I-Grebot/Laser_Beacon_V3.0/README.md

# Laser_Beacon_V3.0
IGrebot's current Beacons system aiming at opponent detection and absolute positioning.

See more on : http://wiki.igrebot.fr/index.php?title=Beacon_V3.0
