I-Grebot/Laser_Beacon_V3.0/Softwares/common/can/doc/igrebot_robot_arch_2013.pdf

Robot Architecture

: sensor
: actuator

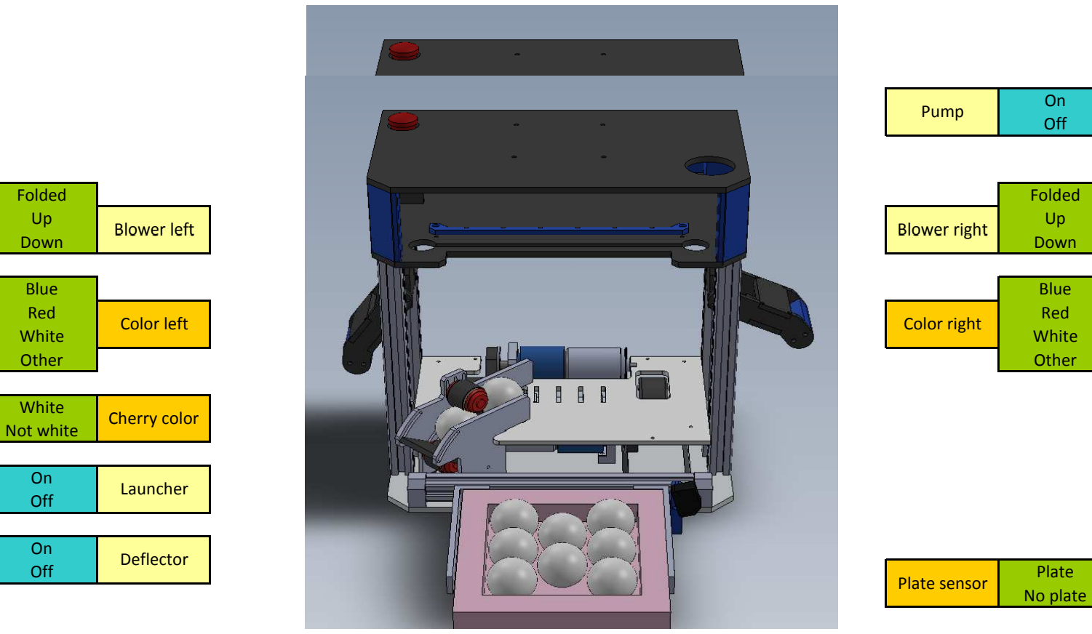
[picture p3: figure]
Folded; Pump; Blower left; Blower right Down; Down; Blue; Red; White; Other; Not white; Off; Plate; No plate; Color right; Deflector; Plate sensor; Cherry color; Launcher; Color left

On | : state
Off | : cmd

## IGrebot 2013

Osiris Back
Right

Osiris Back
Left

Lift
Grab

Osiris Front
Right

Osiris Front
Left Loader
