I-Grebot/Laser_Beacon_V3.0/Electronics/PDD/Releases/PDD_v1.0/PDF/PDD_layout_bcream_neg.pdf

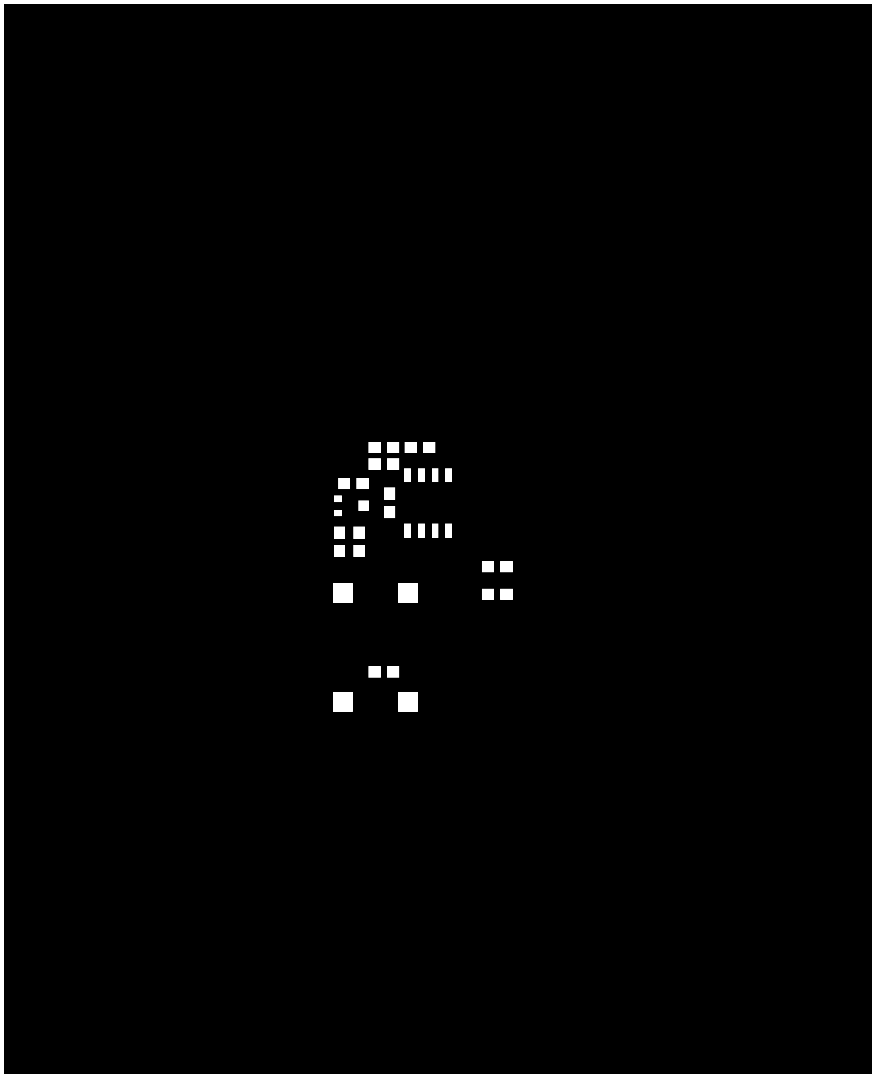
[picture p4: figure]
