I-Grebot/Laser_Beacon_V3.0/Theory/PhotoDetectMain_Algorithm.xlsx

Sheet: Theory
Constants
 |  | 0.003054326191
Laser angle error |  | 0.175 | ° | 0.154
Distance between lasers | dla = | 42 | mm | 38.5 | 60mm @ 3600mm |  | 20
Distance between photodiodes | dph = | 1000 | mm |  |  | 770 | 44.27777778
Turret's angular speed | ftu = | 33 | rps
Measured values
Photodiode A 1st pulse timing | ta1 = | 0 | us
Photodiode A 2nd pulse timing | ta2 = | 722 | us |  | (ta1 < ta2)
Photodiode B 1st pulse timing | tb1 = | 0 | us |  | (ta1 < tb1)
Photodiode B 2nd pulse timing | tb2 = | 0 | us |  | (tb1 < tb2)
Selected orientation quarter offset | qua = | 0 | ° |  | 0° for North, -90° for West, +90° for East, +180° for South
Computed values
Turret's rotation angle between 2 real lasers | Atur = | 8.57736
Turret's rotation angle between 2 perfect // lasers | atu = | 8.40236 | °
Turret's sight distance between 2 photodiodes | dtu = | 0.0 | mm
Final Opponent's values
Distance to opponent | dop = | 287.4275566 | mm
Angle to opponent | aop = | turret's position at (ta2-ta1)/
Opponent's Orientation | oop = | 90.0 | ° |  | relative to aop
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
