I-Grebot/Laser_Beacon_V3.0/Theory/Turret_OpenLoop.xlsx

Sheet: Sheet1
Igrebot 2013
 | Beacon v3.0 - Turret's motor measurements
FCY | 4 | MHz
PWM PERIOD | 512 | cycles at FCY/64
OC2RS | PWM | RPER (ms) | RPS | RPM
0 | 0.00% | 0.00 | 0.00 | 0
32 | 6.25% | 0.00 | 0.00 | 0
64 | 12.50% | 0.00 | 0.00 | 0
96 | 18.75% | 35.00 | 28.57 | 1714.285714
128 | 25.00% | 28.00 | 35.71 | 2142.857143
160 | 31.25% | 25.00 | 40.00 | 2400
192 | 37.50% | 23.00 | 43.48 | 2608.695652
224 | 43.75% | 22.00 | 45.45 | 2727.272727
256 | 50.00% | 21.00 | 47.62 | 2857.142857
288 | 56.25% | 20.50 | 48.78 | 2926.829268
320 | 62.50% | 20.00 | 50.00 | 3000
352 | 68.75% | 19.50 | 51.28 | 3076.923077
384 | 75.00% | 19.00 | 52.63 | 3157.894737
416 | 81.25% | 18.50 | 54.05 | 3243.243243
448 | 87.50% | 18.00 | 55.56 | 3333.333333
480 | 93.75% | 17.75 | 56.34 | 3380.28169
512 | 100.00% | 17.50 | 57.14 | 3428.571429
 | to be avoid (motor doesn't start)
Paul M.
2012-10-19
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
