I-Grebot/Laser_Beacon_V3.0/Electronics/BRX/BRX_v1.0/Images/BRX_schematic.png

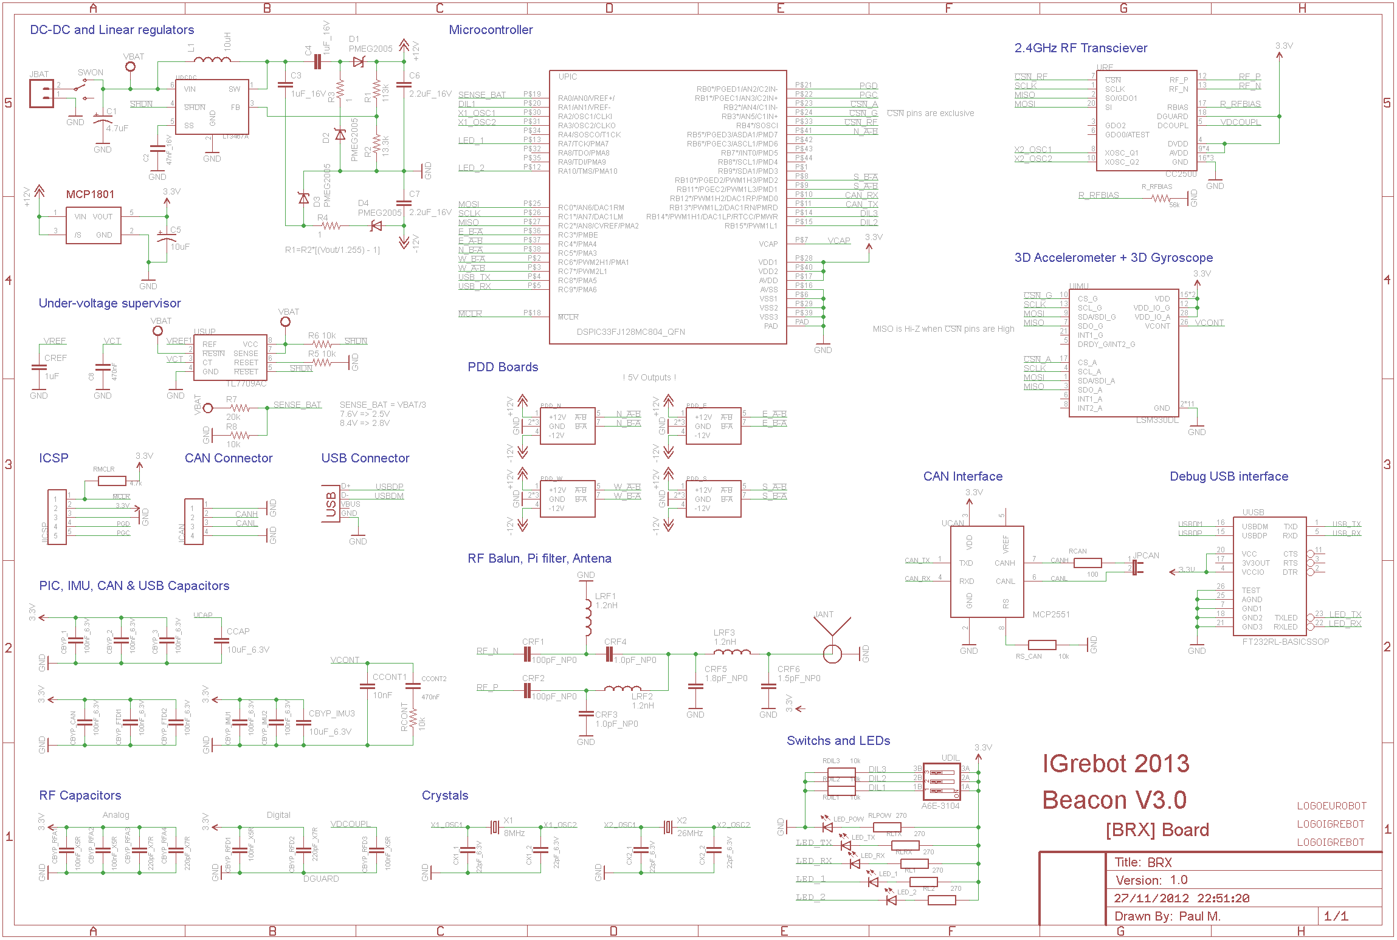
Electronics/BRX/BRX_v1.0/Images/BRX_schematic.png
