I-Grebot/Laser_Beacon_V3.0/Electronics/BTX/BTX_v1.0/Images/BTX_schematic.png

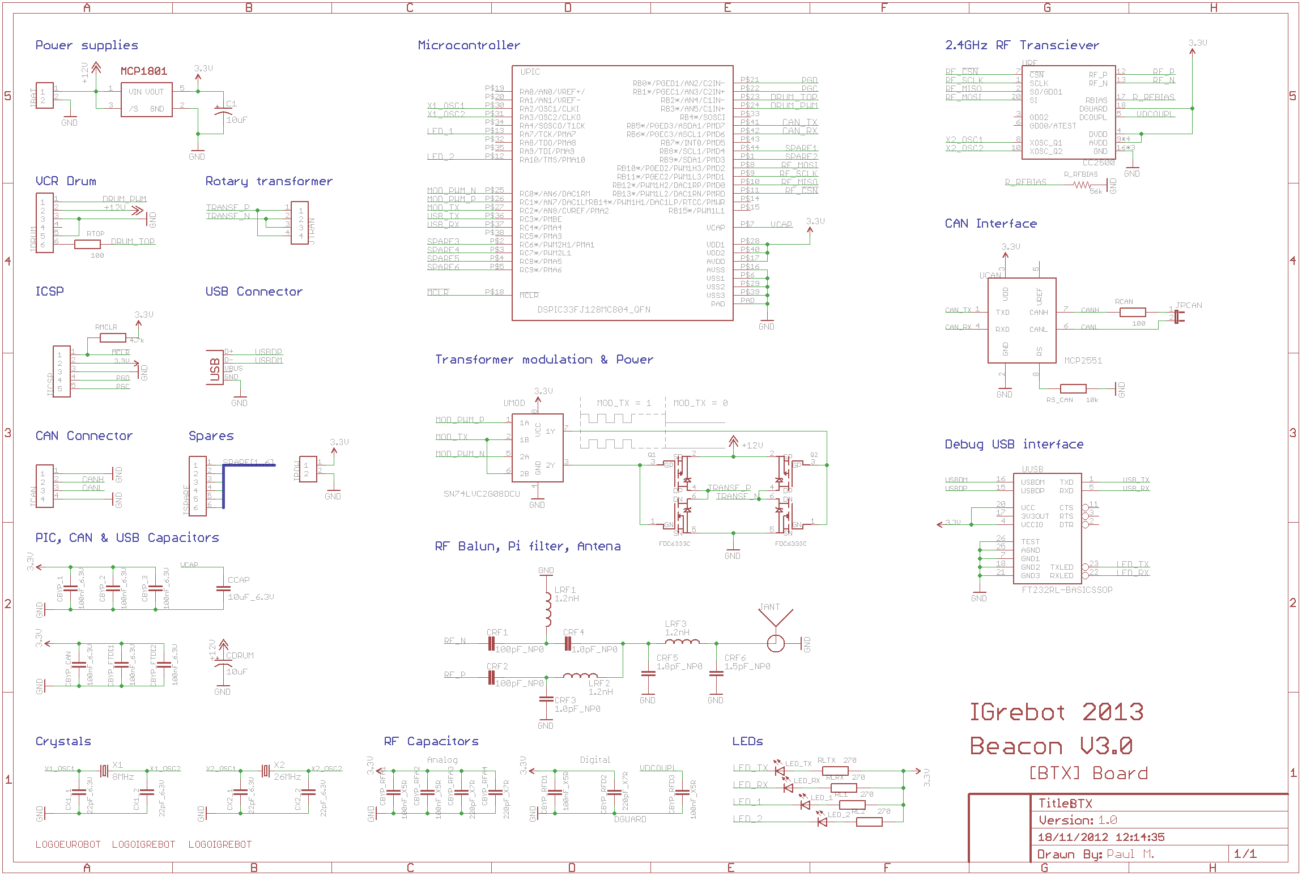
Electronics/BTX/BTX_v1.0/Images/BTX_schematic.png
