I-Grebot/Laser_Beacon_V3.0/Electronics/PDD/Prototype/Images/Rolab_RDD_prot_v1.0_back.png

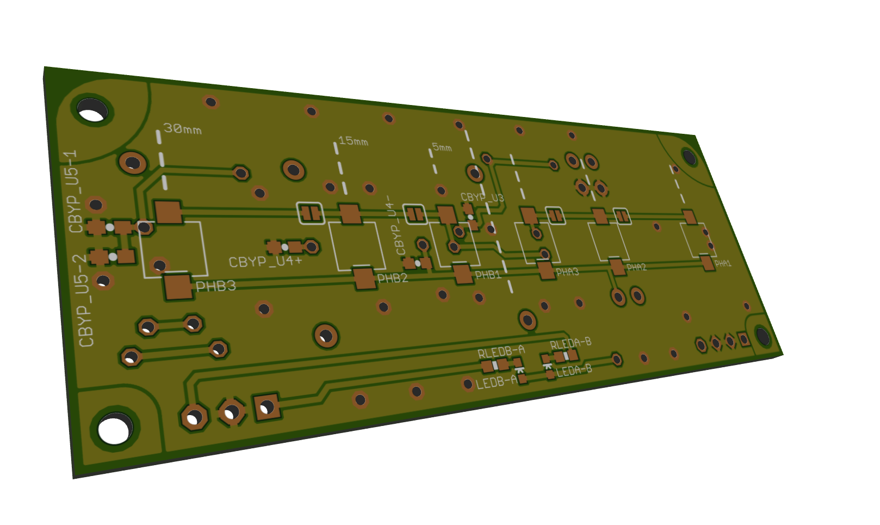
Electronics/PDD/Prototype/Images/Rolab_RDD_prot_v1.0_back.png
