I-Grebot/Laser_Beacon_V3.0/Electronics/PDD/Releases/PDD_v1.0/Images/PDD_schematic.png

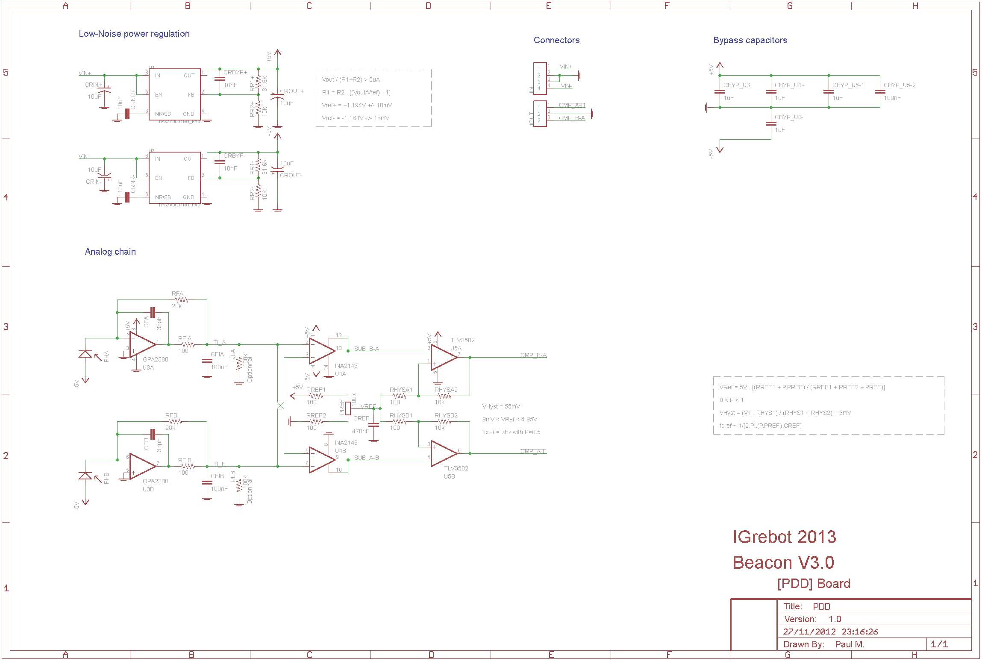
Electronics/PDD/Releases/PDD_v1.0/Images/PDD_schematic.png
