I-Grebot/Laser_Beacon_V3.0/Electronics/TUD/TUD_v1.0/Images/TUD_schematic.png

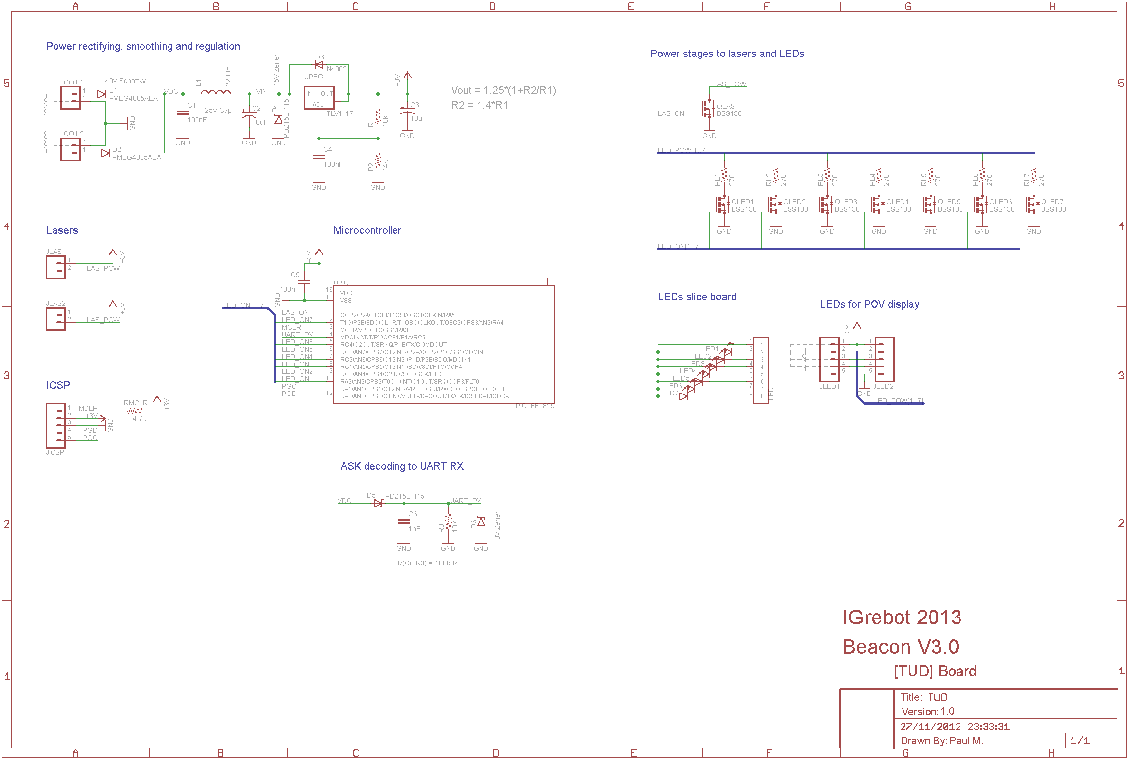
Electronics/TUD/TUD_v1.0/Images/TUD_schematic.png
