I-Grebot/Laser_Beacon_V3.0/Images/Meca/BeaconV3_meca_laser_12x32_10deg.PNG

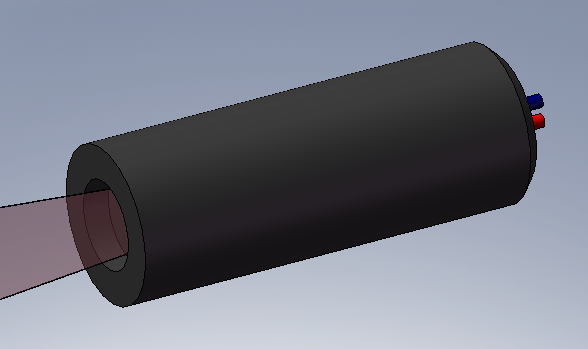
Images/Meca/BeaconV3_meca_laser_12x32_10deg.PNG
