I-Grebot/Laser_Beacon_V3.0/Images/PDD_simu/beacon_2013_rx.png

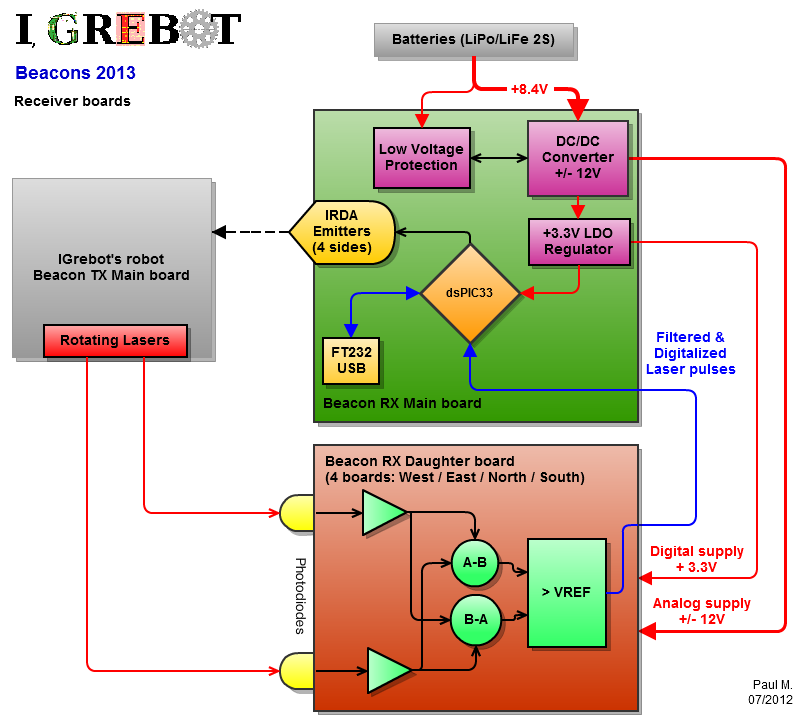
Images/PDD_simu/beacon_2013_rx.png
