I-Grebot/Laser_Beacon_V3.0/Images/PDD_simu/bpw34_datasheet_ir_vs_vr.PNG

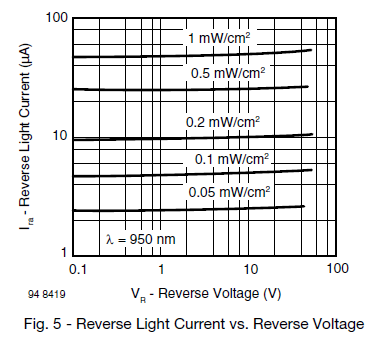
Images/PDD_simu/bpw34_datasheet_ir_vs_vr.PNG
