I-Grebot/Laser_Beacon_V3.0/Images/PDD_simu/bpw34_datasheet_spectral_sensitivity.PNG

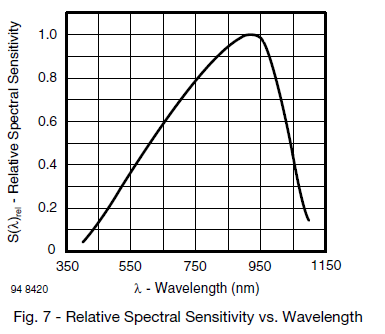
Images/PDD_simu/bpw34_datasheet_spectral_sensitivity.PNG
