I-Grebot/Laser_Beacon_V3.0/Images/PDD_simu/bpw34_model_ir_vs_vr.PNG

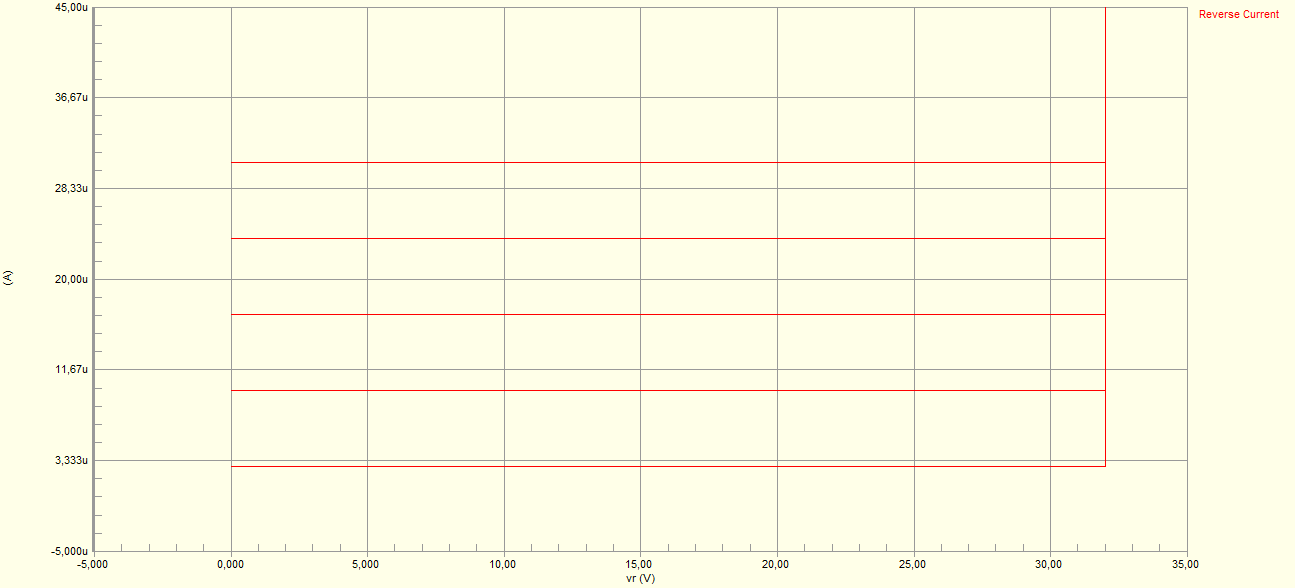
Images/PDD_simu/bpw34_model_ir_vs_vr.PNG
