I-Grebot/Laser_Beacon_V3.0/Images/PDD_simu/bpw34_model_simu3.PNG

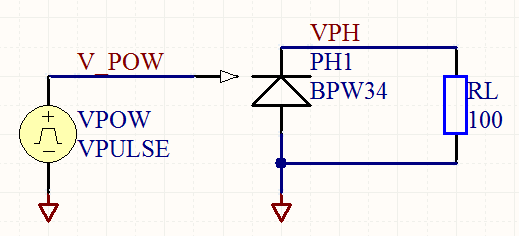
Images/PDD_simu/bpw34_model_simu3.PNG
