I-Grebot/Laser_Beacon_V3.0/Images/PDD_simu/bpw34_model_simu.png

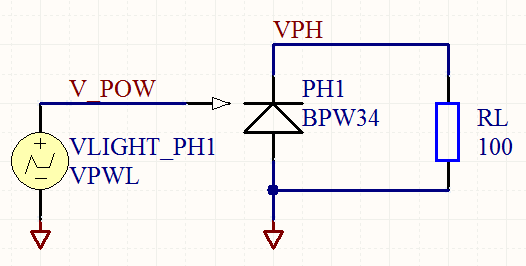
Images/PDD_simu/bpw34_model_simu.png
