I-Grebot/Laser_Beacon_V3.0/Images/PDD_simu/cmp_simu1.PNG

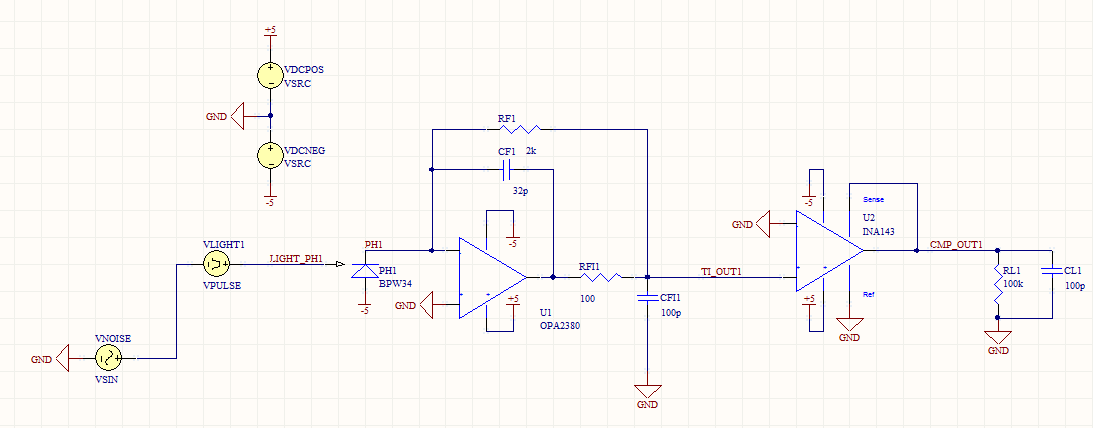
Images/PDD_simu/cmp_simu1.PNG
