I-Grebot/Laser_Beacon_V3.0/Images/PDD_simu/final_sch.PNG

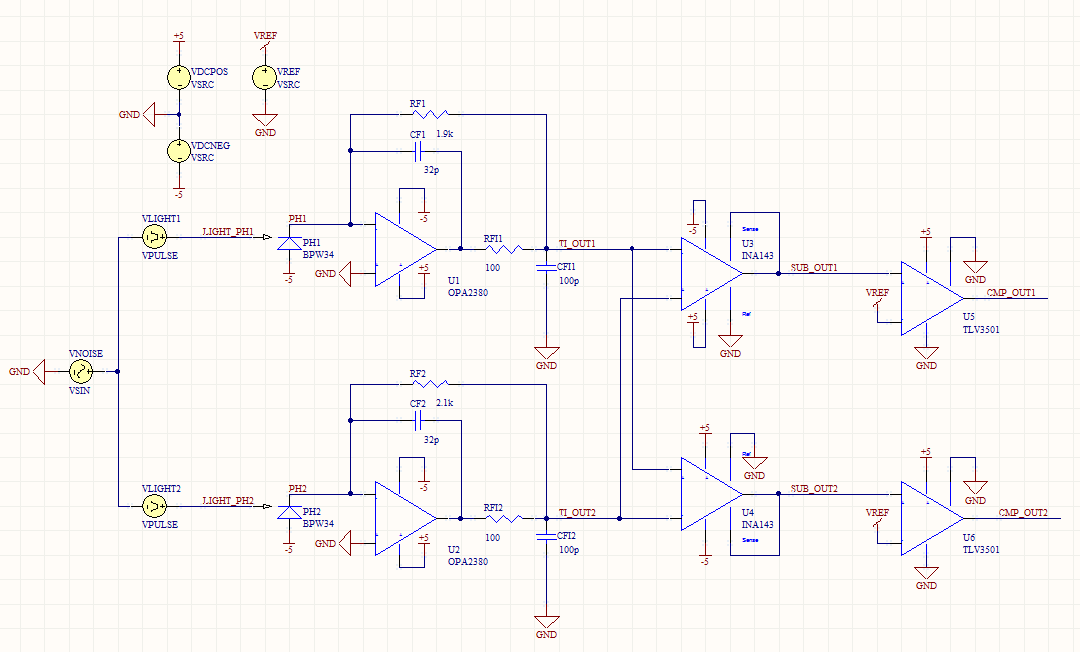
Images/PDD_simu/final_sch.PNG
