I-Grebot/Laser_Beacon_V3.0/Images/PDD_simu/thanks_ti.PNG

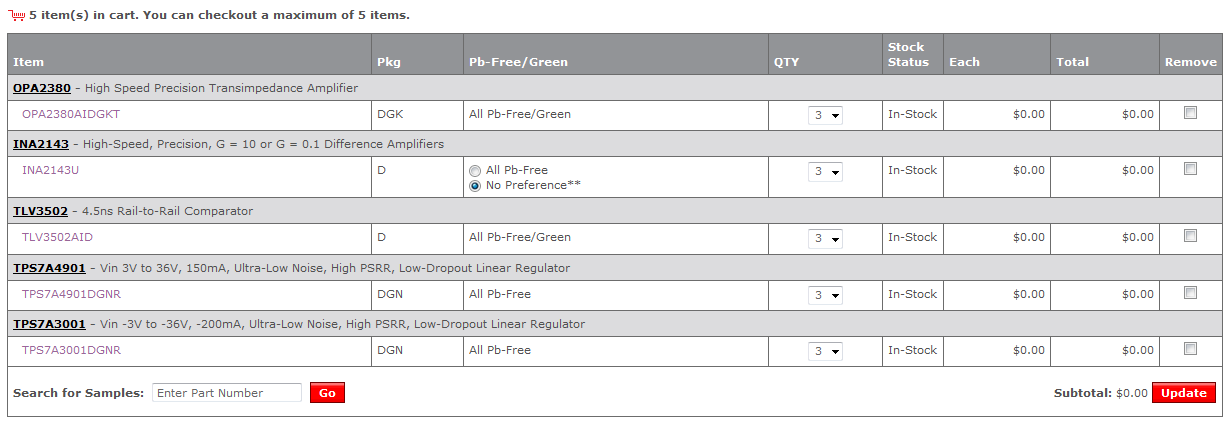
Images/PDD_simu/thanks_ti.PNG
