I-Grebot/Laser_Beacon_V3.0/Images/Theory/beaconV3_theory_err_1b_0.5d_1.0p.png

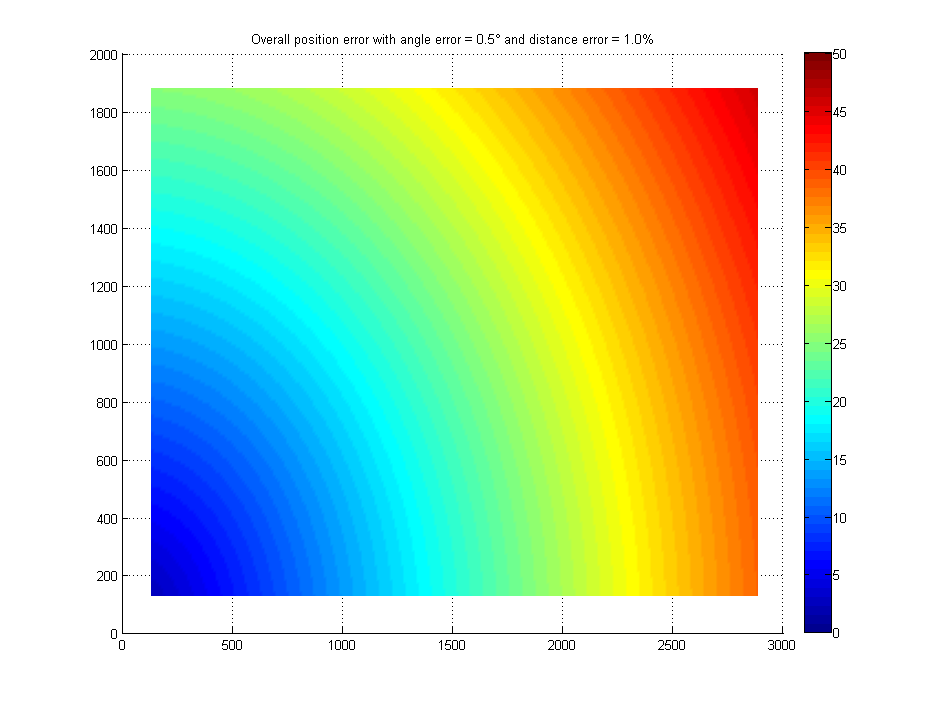
Images/Theory/beaconV3_theory_err_1b_0.5d_1.0p.png
