I-Grebot/Laser_Beacon_V3.0/Images/Theory/beaconV3_theory_pos_2beac_meth1_3.png

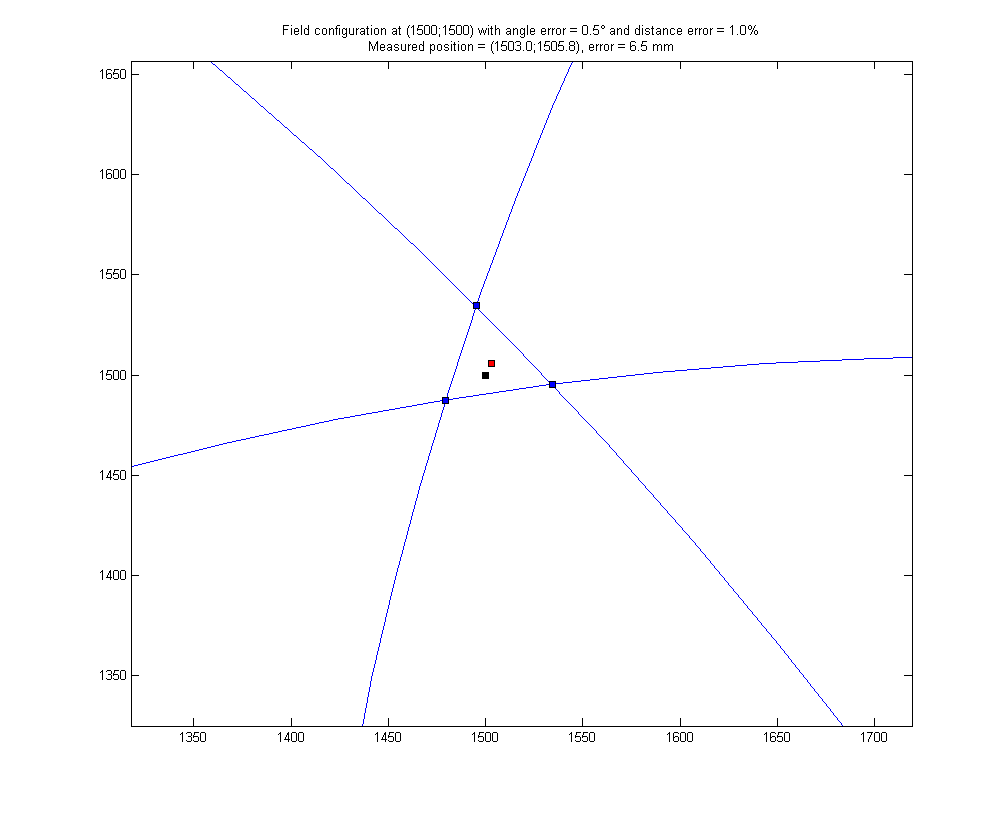
Images/Theory/beaconV3_theory_pos_2beac_meth1_3.png
