I-Grebot/Laser_Beacon_V3.0/Images/Theory/beaconV3_theory_pos_2beac_meth2_AB.png

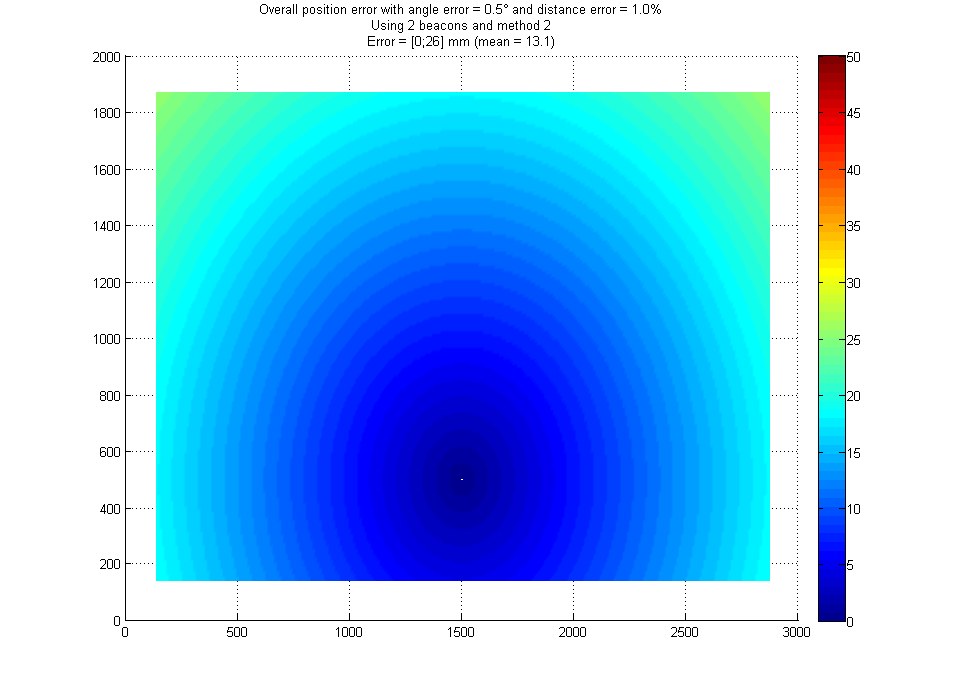
Images/Theory/beaconV3_theory_pos_2beac_meth2_AB.png
