I-Grebot/Laser_Beacon_V3.0/Images/Theory/beaconV3_theory_pos_3beac_meth2_1.png

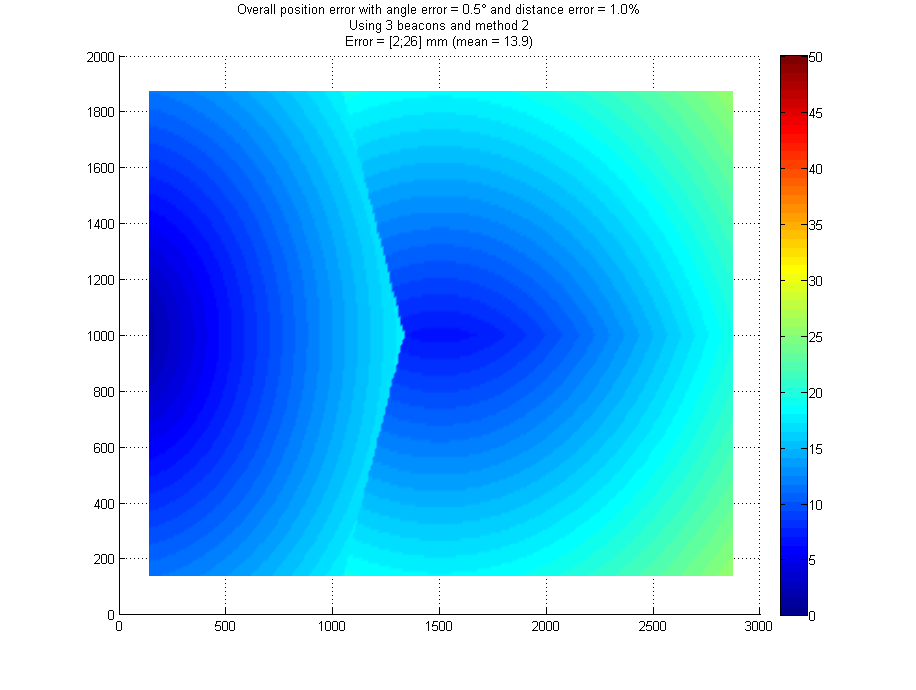
Images/Theory/beaconV3_theory_pos_3beac_meth2_1.png
