I-Grebot/Laser_Beacon_V3.0/Images/Theory/beaconV3_theory_pos_3beac_meth2_2.png

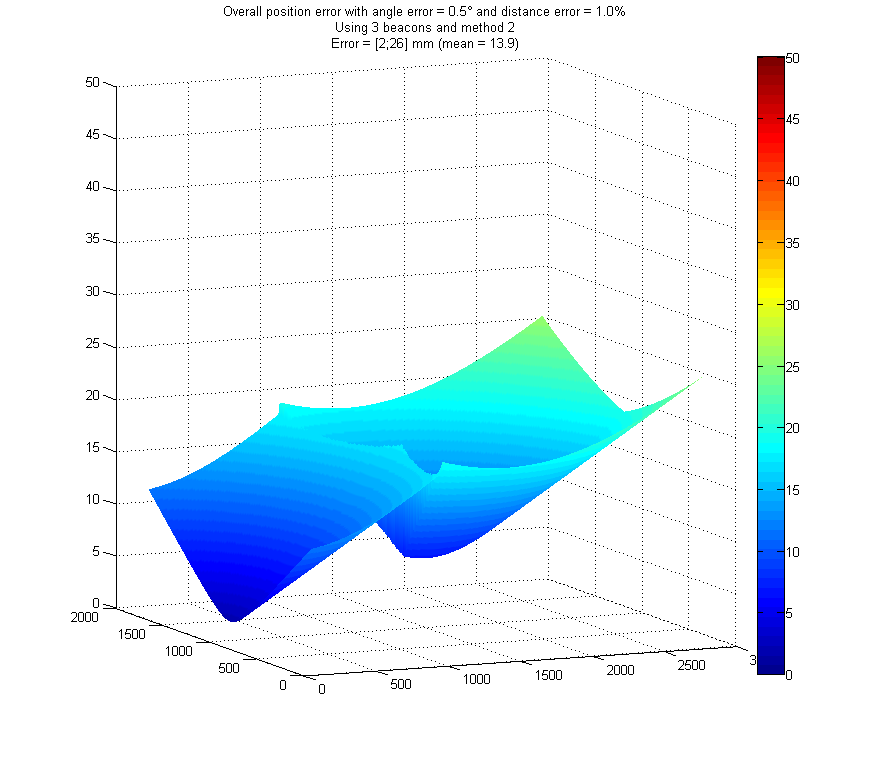
Images/Theory/beaconV3_theory_pos_3beac_meth2_2.png
