I-Grebot/Laser_Beacon_V3.0/Specifications/spec_layout_BRX.png

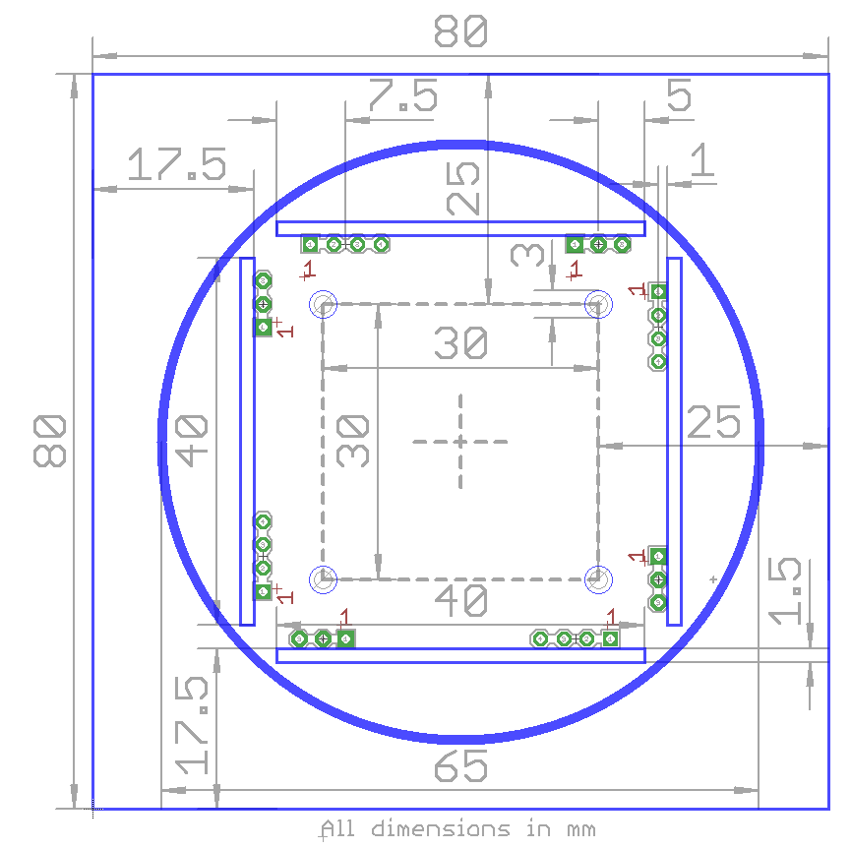
Specifications/spec_layout_BRX.png
