I-Grebot/Laser_Beacon_V3.0/Bill Of Materials/Laser_Beacon_V3.0_BOM.xlsx

Laser Beacon V3.0
Bill-Of-Materials
 |  |  |  |  |  |  |  | [BTX] | [TUD] | [BRX]-O | [BRX]-B | [PDD]
Not included: | - Ceramic 402 / 603 / 805 Resistors, Capacitor (X5R, X7R, NP0 - 6.3V) E24 serie |  |  |  |  | Number of boards |  | 1 | 1 | 2 | 3 | 17
 | - Ceramic 603, Through hole 3mm and 5mm LEDs
 | - Standard 2.54mm or 2.0mm male headers
 |  |  |  | Quantities |  |  |  |  |  |  |  |  |  | Prices
Category | Device | Package / Ref. | Value / Description | [BTX] | [TUD] | [BRX]-O | [BRX]-B | [PDD] | Total Qty. | Stock | Supply | Supply Ref. | Link | Unit | Rem. | Total Price | -
Digital IC | LSM330DL | LLGA-28 | 6 DOF Digital Accelero/Gyro |  |  | 1 |  |  | 2 |  | Farnell | 2056736 | ì | 9.02 € | 18.04 € | 18.04 € | 2.00 €
Connector | SMA Right Angle | 5-1814400-1 | 5.08mm square SMA connector | 1 |  | 1 | 1 |  | 6 |  | Farnell | 1248989 | ì | 2.24 € | 13.44 € | 13.44 € | 6.00 €
Mechanical | M3 X 25mm Hex6 spacer | 05.13.253 | Aluminium Hex6 spacer |  |  | 8 | 4 |  | 28 |  | Farnell | 1466796 | ì | 0.40 € | 11.20 € | 11.20 € | 28
Switch | DIL-3 | A6E3104 | 3 Ways Raised DIL Switch |  |  | 1 | 1 |  | 5 |  | Farnell | 1960869 | ì | 1.98 € | 9.90 € | 9.90 € | 5.00 €
Switch | SPDT Slider | 450302014072 | Right Angle SPDT 12V/500mA |  |  | 1 | 1 |  | 5 |  | Farnell | 2134453 | ì | 1.97 € | 9.85 € | 9.85 € | 5.00 €
Power IC | TL7709AC | SOIC-8 | 7,6V Voltage Supervisor |  |  | 1 | 1 |  | 5 |  | Farnell | 1648653 | ì | 1.76 € | 8.80 € | 8.80 € | 5.00 €
Passive | Schottky Diode | SOD-523 | PMEG2005EB |  |  | 4 | 4 |  | 20 |  | Farnell | 8737860 | ì | 0.36 € | 7.20 € | 7.20 € | 20.00 €
Mechanical | M3 X 40mm Hex6 spacer | 05.13.401 | Aluminium Hex6 spacer |  |  |  | 4 |  | 12 |  | Farnell | 1466856 | ì | 0.60 € | 7.20 € | 7.20 € | 12
Passive | Capacitor | 1411 | 10uF, 16V, Low ESR, Tantalum |  |  |  |  | 4 | 68 |  | Ebay | 310527710797 | ì | 0.10 € | 6.80 € | 6.80 € | 68.00 €
Connector | Antenna | RN-SMA-S-RP | 2.4GHz , 1 inch SMA Antenna | 1 |  | 1 | 1 |  | 6 |  | Ebay | 330844078182 | ì | 1.00 € | 6.00 € | 6.00 € | 6.00 €
Digital IC | FT232RL | SSOP-28 | USB to UART Data converter | 1 |  | 0 | 0 |  | 1 |  | Farnell | 1146032 | ì | 5.45 € | 5.45 € | 5.45 € | 1.00 €
Passive | Trimmer | PVZ2A104C04B00 | 100kΩ |  |  |  |  | 1 | 17 |  | Farnell | 1771728 | ì | 0.22 € | 3.74 € | 3.74 € | 17.00 €
Mechanical | M4 X 30mm Hex6 spacer | 05.14.303 | Aluminium Hex6 spacer | 4 |  |  |  |  | 4 |  | Farnell | 1466848 | ì | 0.80 € | 3.20 € | 3.20 € | 4
Passive | Capacitor | 1210 | 2.2uF, 100V, Ceramic X7R |  |  | 2 | 2 |  | 10 |  | Farnell | 2112727 | ì | 0.29 € | 2.90 € | 2.90 € | 10.00 €
Passive | Capacitor | 1210 | 1uF, 50V, Ceramic X7R |  |  | 3 | 3 |  | 15 |  | Farnell | 2070523 | ì | 0.16 € | 2.40 € | 2.40 € | 15.00 €
Mechanical | Ø3 X 5mm spacer | R30F6700594 | Plastic spacer |  |  | 4 | 4 |  | 20 |  | Farnell | 666877 | ì | 0.10 € | 2.00 € | 2.00 € | 20
Mechanical | M4 X 15mm Hex6 spacer | 05.14.153 | Aluminium Hex6 spacer | 4 |  |  |  |  | 4 |  | Farnell | 1466807 | ì | 0.40 € | 1.60 € | 1.60 € | 4
Mechanical | M4 X 20mm Hex6 spacer | 05.14.203 | Aluminium Hex6 spacer | 4 |  |  |  |  | 4 |  | Farnell | 1467030 | ì | 0.40 € | 1.60 € | 1.60 € | 4
Passive | Capacitor | PANASONIC_C | 4.7uF, 50V, Electrolytic |  |  | 1 | 1 |  | 5 |  | Farnell | 9697098 | ì | 0.27 € | 1.35 € | 1.35 € | 5.00 €
Passive | Capacitor | 1411 | 3.3uF, 35V, ESR 1.3Ω, Tantalum |  | 1 |  |  |  | 1 |  | Farnell | 1692400RL | ì | 1.23 € | 1.23 € | 1.23 € | 1.00 €
Analog IC | FDC6333C | SSOT-6 | Low-VT FAST N/P MOSFET 30V/2A | 2 |  |  |  |  | 2 |  | Farnell | 1700671 | ì | 0.50 € | 1.00 € | 1.00 € | 2.00 €
Passive | Inductor | MCSDC0503-100MU | 10uH |  |  | 1 | 1 |  | 5 |  | Farnell | 1864079 | ì | 0.16 € | 0.80 € | 0.80 € | 5.00 €
Connector | Mini-USB | 10033526-N3212MLF | SMD Type B Mini-USB | 1 |  |  |  |  | 1 |  | Farnell | 2112367 | ì | 0.73 € | 0.73 € | 0.73 € | 1.00 €
Passive | Inductor | 402 | 1.2nH | 3 |  | 3 | 3 |  | 18 |  | Farnell | 2103058 | ì | 0.04 € | 0.72 € | 0.72 € | 18.00 €
Passive | Zener Diode | SOD-323 | BZT52C15S - Vz = 15V |  | 2 |  |  |  | 2 |  | Farnell | 1902429 | ì | 0.32 € | 0.64 € | 0.64 € | 2.00 €
Passive | Capacitor | PANASONIC_C | 10uF, 35V, Electrolytic | 2 |  |  |  |  | 2 |  | Farnell | 9697012 | ì | 0.27 € | 0.54 € | 0.54 € | 2.00 €
Analog IC | BSS138 | SOT-23 | N Channel MOSFET 50V/0,2A |  | 8 |  |  |  | 8 |  | Farnell | 1859849 | ì | 0.06 € | 0.48 € | 0.48 € | 8.00 €
Mechanical | Ø4 X 5mm spacer | R40F6710594 | Plastic spacer | 4 |  |  |  |  | 4 |  | Farnell | 666920 | ì | 0.10 € | 0.40 € | 0.40 € | 4
Passive | Capacitor | 1206 | 10uF, 6.3V, Ceramic X5R | 1 |  | 1 | 1 |  | 6 |  | Farnell | 1759483 | ì | 0.06 € | 0.36 € | 0.36 € | 6.00 €
Passive | Inductor | MCSDC0503-221KU | 220uH |  | 1 |  |  |  | 1 |  | Farnell | 1864084 | ì | 0.34 € | 0.34 € | 0.34 € | 1.00 €
Digital IC | SN74LVC2G08DCU | DCU-8 | Dual AND2 logic gates | 1 |  |  |  |  | 1 |  | Farnell | 1470869 | ì | 0.33 € | 0.33 € | 0.33 € | 1.00 €
Passive | Zener Diode | SOD-323 | BZT52C3V3S-7-F - Vz = 3.3V |  | 1 |  |  |  | 1 |  | Farnell | 2077918 | ì | 0.32 € | 0.32 € | 0.32 € | 1.00 €
Connector | Screw Terminal Bloc | PM5.08/2/90 BLK | 2 Ways 5.08mm Header | 1 |  |  |  |  | 1 |  | Farnell | 1131855 | ì | 0.28 € | 0.28 € | 0.28 € | 1.00 €
Passive | Schottky Diode | SOD-323 | PMEG4005AEA - 40V |  | 2 |  |  |  | 2 |  | Farnell | 8738025 | ì | 0.09 € | 0.18 € | 0.18 € | 2.00 €
Passive | Diode | SOD-323 | 1N4148 - 100V |  | 1 |  |  |  | 1 |  | Farnell | 1612348 | ì | 0.11 € | 0.11 € | 0.11 € | 1.00 €
Passive | Capacitor | 603 | 47nF, 16V, Ceramic X7R |  |  | 1 | 1 |  | 5 |  | Farnell | 1759011 | ì | 0.01 € | 0.05 € | 0.05 € | 5.00 €
Passive | Capacitor | 603 | 1nF, 25V, Ceramic X7R |  | 1 |  |  |  | 1 |  | Farnell | 1856347RL | ì | 0.03 € | 0.03 € | 0.03 € | 1.00 €
Passive | Capacitor | 603 | 100nF, 25V, Ceramic X7R |  | 1 |  |  |  | 1 |  | Farnell | 1759037 | ì | 0.01 € | 0.01 € | 0.01 € | 1.00 €
Passive | Photodiode | VBPW34S | 7mm², 65°, 940nm |  |  |  |  | 2 | 34 | 19 | Sample VS |  |  | 0.00 € | 0.00 € | 0.00 € | 15.00 €
Power IC | LT3467A | TSOT-23 | DC/DC 2.1MHz / 1.1A |  |  | 1 | 1 |  | 5 |  | Sample LT | 1663827 |  | 0.00 € | 0.00 € | 0.00 € | 5.00 €
Analog IC | INA2143U | SOIC-14 | High-Speed Difference OPA |  |  |  |  | 1 | 17 | 5 | Sample TI |  |  | 0.00 € | 0.00 € | 0.00 € | 12
Analog IC | OPA2380AIDGKT | SSOP-8 | High-Speed Transimpedance OPA |  |  |  |  | 1 | 17 | 7 | Sample TI |  |  | 0.00 € | 0.00 € | 0.00 € | 10
Analog IC | TLV3502AID | SOIC-8 | High-Speed Comparator OPA |  |  |  |  | 1 | 17 | 5 | Sample TI |  |  | 0.00 € | 0.00 € | 0.00 € | 12
Digital IC | CC2500RTKR | VQFN-20 | 2.4GHz RF Transciever | 1 |  | 1 | 1 |  | 6 | 10 | Sample TI |  |  | 0.00 € | 0.00 € | 0.00 € | 0
Digital IC | DSPIC33FJ128MC804-x/ML | QFN-44 | dsPIC33F Microcontroller | 1 |  | 1 | 1 |  | 6 |  | Sample MC |  |  | 0.00 € | 0.00 € | 0.00 € | 6.00 €
Digital IC | PIC16F1825 | QFN-16 | PIC16F Microcontroller |  | 1 |  |  |  | 1 |  | Sample MC |  |  | 0.00 € | 0.00 € | 0.00 € | 1.00 €
Digital IC | SN65HVD233D | SOIC-8 | 3.3V CAN Transciever | 1 |  | 0 | 0 |  | 1 | 1 | Sample TI |  |  | 0.00 € | 0.00 € | 0.00 € | 0
Passive | Crystal | ABS10 (2pads 4.8 x 1.8 mm) | 8MHz - No availability! | 1 |  | 1 | 1 |  | 6 |  |  |  |  |  | 0.00 € | 0.00 € | 6.00 €
Passive | Crystal | ABS10 (2pads 4.8 x 1.8 mm) | 26MHz - No availability! | 1 |  | 1 | 1 |  | 6 |  |  |  |  |  | 0.00 € | 0.00 € | 6.00 €
Power IC | TLV1117-33CDCYR | SOT-223 | 3.3V LDO Regulator 800mA | 1 |  | 1 | 1 |  | 6 | 8 | Sample TI |  |  | 0.00 € | 0.00 € | 0.00 € | 0
Power IC | TLV1117CDCYR | SOT-223 | Adjustable LDO Regulator 800mA |  | 1 |  |  |  | 1 | 4 | Sample TI |  |  | 0.00 € | 0.00 € | 0.00 € | 0
Power IC | TPS7A3001DGNR | MSOP-8 | -36V, -200mA LN Regulator |  |  |  |  | 1 | 17 | 6 | Sample TI |  |  | 0.00 € | 0.00 € | 0.00 € | 11
Power IC | TPS7A4901DGNR | MSOP-8 | +36V, +150mA LN Regulator |  |  |  |  | 1 | 17 | 6 | Sample TI |  |  | 0.00 € | 0.00 € | 0.00 € | 11
 |  |  |  |  |  |  |  |  |  |  |  |  | Sub-total tax free |  | 131.22 € | 131.22 €
 |  |  |  |  |  |  |  |  |  |  |  |  | VAT |  | 156.94 € | 156.94 €
 |  |  |  |  |  |  |  |  |  |  |  |  | Shipping |  | 12.00 € | 12.00 €
 |  |  |  |  |  |  |  |  |  |  |  |  | Grand Total |  | 168.94 € | 168.94 €
