I-Grebot/Laser_Beacon_V3.0/Electronics/PDD/Prototype/BOM/Rolab_PDD_prot.xlsx

Rolab PhotoDetect Daughter - Proto 1.0
Bill-Of-Materials |  |  |  |  | Number of boards | 4
Device | Package | Qty | Value | Parts | Description | Supply | Price | Line Price
CAP0603-CAP | 0603-CAP | 3 | 100nF | CBYP_U5-2, CFIA, CFIB | Capacitor | Stock | 0.00 € | 0.00 €
CAP0603-CAP | 0603-CAP | 4 | 10nF | CRBYP+, CRBYP-, CRNR+, CRNR- | Capacitor | Farnell |  | 0.00 €
CAP0603-CAP | 0603-CAP | 4 | 1uF | CBYP_U3, CBYP_U4+, CBYP_U4-, CBYP_U5-1 | Capacitor | Farnell |  | 0.00 €
CAP0603-CAP | 0603-CAP | 2 | 33pF | CFA, CFB | Capacitor | Farnell |  | 0.00 €
CAP0603-CAP | 0603-CAP | 1 | 470nF | CREF | Capacitor | Farnell |  | 0.00 €
RESISTOR0603-RES | 0603-RES | 2 | 0 | RSA, RSB | Resistor | Stock |  | 0.00 €
RESISTOR0603-RES | 0603-RES | 6 | 100 | RFIA, RFIB, RHYSA1, RHYSB1, RREF1, RREF2 | Resistor | Stock | 0.00 € | 0.00 €
RESISTOR0603-RES | 0603-RES | 2 | 100k | RLA, RLB | Resistor | Stock | 0.00 € | 0.00 €
RESISTOR0603-RES | 0603-RES | 6 | 10k | RHYSA2, RHYSB2, ROUTA1, ROUTB1, RR2+, RR2- | Resistor | Stock | 0.00 € | 0.00 €
RESISTOR0603-RES | 0603-RES | 2 | 20k | ROUTA2, ROUTB2 | Resistor | Stock | 0.00 € | 0.00 €
RESISTOR0603-RES | 0603-RES | 4 | 270 | RLEDA-B, RLEDB-A, RLEDV+, RLEDV- | Resistor | Stock | 0.00 € | 0.00 €
RESISTOR0603-RES | 0603-RES | 2 | 2k | RFA, RFB | Resistor | Farnell |  | 0.00 €
RESISTOR0603-RES | 0603-RES | 2 | 31.6k | RR1+, RR1- | Resistor | Farnell |  | 0.00 €
M01PTH | 1X01 | 5 | M01PTH | JTA-B, JTB-A, JTTIA, JTTIB, JTVREF | Header 1 | Stock | 0.00 € | 0.00 €
JUMPER-2PTH_LOCK | 1X02_LOCK | 2 | N/A | JP+5V, JP-5V | Jumper | Stock | 0.00 € | 0.00 €
M02LOCK | 1X02_LOCK | 1 | N/A | JTAGND | Header 2 | Stock | 0.00 € | 0.00 €
SIL3 | CON3-2.54 | 1 | SIL3 | JOUT | Header 3 | Stock | 0.00 € | 0.00 €
SIL4 | CON4-2.54 | 1 | SIL4 | JIN | Header 4 | Stock | 0.00 € | 0.00 €
CAP_POL3528-KIT | EIA3528-KIT | 4 | 10uF | CRIN+, CRIN-, CROUT+, CROUT- | Capacitor Polarized | Farnell |  | 0.00 €
LED0603 | LED-0603 | 4 | N/A | LEDA-B, LEDB-A, LEDV+, LEDV- | LEDs | Stock | 0.00 € | 0.00 €
OPA2380 | MSOP8 | 1 | OPA2380 | U3 | Transimpedance OPA | TI Sample | 0.00 € | 0.00 €
TPS7A3001NO_PAD | MSOP8 | 1 | TPS7A3001NO_PAD | U2 | Regulator | TI Sample | 0.00 € | 0.00 €
TPS7A4901NO_PAD | MSOP8 | 1 | TPS7A4901NO_PAD | U1 | Regulator | TI Sample | 0.00 € | 0.00 €
SOLDERJUMPERNC | SJ_2S | 10 | SOLDERJUMPERNC | SJ1, SJ2, SJ3, SJ4, SJ5, SJ6, SJ7, SJ8, SJ9, SJ11 | Solder Jumper | N/A | 0.00 € | 0.00 €
INA2143 | SOIC14 | 1 | INA2143 | U4 | Differential OPA | TI Sample | 0.00 € | 0.00 €
TLV3502 | SOIC8 | 1 | TLV3502 | U5 | High speed comparator | TI Sample | 0.00 € | 0.00 €
PVZ2A | TRIM-PVZ2A | 1 | 100k | PREF | Trimmer | Stock | 0.00 € | 0.00 €
PVZ2A | TRIM-PVZ2A | 2 | 10k | PA, PB | Trimmer | Stock | 0.00 € | 0.00 €
VBPW34SR | VBPW34SR | 6 | VBPW34SR | PHA1, PHA2, PHA3, PHB1, PHB2, PHB3 | Photodiode | Farnell |  | 0.00 €
 |  |  |  |  |  | Total per board |  | 0.00 €
 |  |  |  |  |  | Total tax free |  | 0.00 €
 |  |  |  |  |  | VAT |  | 0.00 €
 |  |  |  |  |  | Shipping |  | 20.00 €
 |  |  |  |  |  | Grand Total |  | 20.00 €
