I-Grebot/Laser_Beacon_V3.0/Softwares/common/can/doc/igrebot_can_2013.ods

Sheet: CAN Protocol
Standard CAN
Fixed size = | 44 | bits
Bit-stuffing ratio = | 1,2 | when using NRZ-5
Bus speed = | 125 | kbit/s

Sheet: IGrebot's CAN
IGrebot 2013 |  |  |  |  |  |  |  |  |  |  |  | CAN Message IDs
Lower SID = Higher Priority
 |  | CAN Id
 |  | 10 | 9 | 8 | 7 | 6 | 5 | 4 | 3 | 2 | 1 | 0
CAN Message |  | Priority |  | Category |  |  |  | Message
Priorities (4 values)
ID[10:9] | Mnemonic | Description
0 | high | Highest priority
1 | default | Default priority
2 | low | Low priority
3 | diag | Used for diagnosis and debug messages
Categories (16 values)
ID[8:5] | Mnemonic | Description
0 | supply | Critical messages linked with power supply and batteries managment
1 | avoidance | Messages related to the robot avoidance system (except beacons)
2 | beacon | Specific messages related to the beacon(s) managment
3 | motion | Robot motion messages
4 | actuators | Actuators related messages (except motion managment)
5 | sensors | Sensors message (uncorellated with direct actuator motion)
6 | unused
7 | unused
8 | system | High-level messages, related to strategy and system managment
9 | unused
10 | unused
11 | unused
12 | unused
13 | unused
14 | boot | Bootloading messages, dedicated for self-writing over CAN purposes
15 | debug | Messages which purely have a debug purpose
Message ID (32 per category)
ID [4:0]
They are all specific to the category.
Payload possible data types
Data type | Description
bool | Boolean (True or False) stored as a byte
int8 | Byte (-128 to 127)
int16 | Integer (-32768 to 32767)
int32 | Integer (-2147483648 to 2147483647)
int64 | Integer (9223372036854775808 to 9223372036854775807)
uint8 | Unsigned integer (0 to 255) : also used for flags and states
uint16 | Unsigned integer (0 to 65535) : also used for flags and states if than 8 is needed
uint32 | Unsigned integer (0 to 4294967295)
uint64 | Unsigned integer (0 to 18446744073709551615)
float16 | Half precision float: sign bit, 5 bits exponent, 10 bits mantissa
float32 | Single precision float: sign bit, 8 bits exponent, 23 bits mantissa
float64 | Double precision float: sign bit, 11 bits exponent, 52 bits mantissa
complex64 | Complex number, represented by two 32-bit floats (real and imaginary components)
complex128 | Complex number, represented by two 64-bit floats (real and imaginary components)
array | Type used when the data contained in payload shouldn't be interpreted
Note: data type names are given according to Python Numpy package denomination
 |  | status |  |  | yes |  | 1 |  |  |  |  |  |  | Node's id
 |  |  |  |  |  |  |  |  |  | state | 1 | 1 | uint8 | General feedback status ; by sending this the node indicates that it's alive
debug | 15 | printf |  | 0x1E0 | no | 0 | 7 |  |  |  |  |  |  | Emitter node id
 |  |  |  |  |  |  |  |  |  | data | 1 | 7 | array | String data: always 7 bytes (pad with 0 if string is finished)

Sheet: CAN Messages Table
IGrebot 2013 |  |  |  |  |  |  | CAN Messages Table
Category |  | Message |  | CAN Id | RTR allowed | Reccurence (msg/s) | Length (bytes) | Frame size (bits) | Frame's bus-load | Payload content
Mnemonic | Id | Mnemonic | Id |  |  |  |  |  |  | Bitfield | Byte no. | Length | Type | Description
supply | 0 | status | 0 | 0x000 | yes | 20 | 5 | 101 | 1,62% | fault | 0 | 1 | uint8 | Indicates any critical fault
 |  |  |  |  |  |  |  |  |  | battery_voltage | 1 | 2 | uint16 | Main batteries voltage
 |  |  |  |  |  |  |  |  |  | fuses_state | 3 | 1 | uint8 | Fuses state for each power-supply
 |  |  |  |  |  |  |  |  |  | emergency_stop | 4 | 1 | bool | Indicates that emergency button is pushed down
 |  | command | 1 | 0x001 | no | 0 | 1 | 63 | 0,00% | shutdown | 0 | 1 | uint8 | Command a power supply to be shutdown
avoidance | 1 | osiris | 0 | 0x020 | yes | 20 | 1 | 63 | 1,01% | detection | 0 | 1 | uint8 | Each bit indicates a detected object by osiris sensor (#0 to #7)
 |  | ultrasonic | 1 | 0x021 | yes | 20 | 2 | 72 | 1,15% | dist_0 | 0 | 1 | uint8 | Distance measured by US sensor #0
 |  |  |  |  |  |  |  |  |  | dist_1 | 1 | 1 | uint8 | Distance measured by US sensor #1
beacon | 2 | status | 0 | 0x040 | yes | 5 | 3 | 82 | 0,33% | errors | 0 | 1 | uint8 | Each bit corresponds to an error flag
 |  |  |  |  |  |  |  |  |  | turret | 1 | 2 | float16 | Corresponds to the current turret speed
 |  | command | 1 | 0x041 | no | 0 | 1 | 63 | 0,00% | turret | 0 | 1 | uint8 | Controls the turret activations (rotation, lasers, …)
 |  | opponent_1_abs | 2 | 0x042 | yes | 10 | 6 | 111 | 0,89% | pos_x | 0 | 2 | int16 | Opponent's 1st robot X-axis position
 |  |  |  |  |  |  |  |  |  | pos_y | 2 | 2 | int16 | Opponent's 1st robot Y-axis position
 |  |  |  |  |  |  |  |  |  | pos_a | 4 | 2 | int16 | Opponent's 1st robot absolute angular position
 |  | opponent_1_rel | 3 | 0x043 | yes | 10 | 4 | 92 | 0,74% | pos_d | 0 | 2 | int16 | Opponent's 1st robot distance relative to the robot's front
 |  |  |  |  |  |  |  |  |  | pos_a | 2 | 2 | int16 | Opponent's 1st robot angle relative to the robot's front
 |  | opponent_2_abs | 4 | 0x044 | yes | 10 | 6 | 111 | 0,89% | pos_x | 0 | 2 | int16 | Opponent's 2nd robot X-axis position
 |  |  |  |  |  |  |  |  |  | pos_y | 2 | 2 | int16 | Opponent's 2nd robot Y-axis position
 |  |  |  |  |  |  |  |  |  | pos_a | 4 | 2 | int16 | Opponent's 2nd robot absolute angular position
 |  | opponent_2_rel | 5 | 0x045 | yes | 10 | 4 | 92 | 0,74% | pos_d | 0 | 2 | int16 | Opponent's 2nd robot distance relative to the robot's front
 |  |  |  |  |  |  |  |  |  | pos_a | 2 | 2 | int16 | Opponent's 2nd robot angle relative to the robot's front
 |  | robot_abs | 6 | 0x046 | yes | 5 | 6 | 111 | 0,44% | pos_x | 0 | 2 | int16 | Absolute X-axis position from beacon computation
 |  |  |  |  |  |  |  |  |  | pos_y | 2 | 2 | int16 | Absolute Y-axis position from beacon computation
 |  |  |  |  |  |  |  |  |  | pos_a | 4 | 2 | int16 | Absolute Angular position from beacon computation
motion | 3 | fb_status | 0 | 0x060 | yes | 20 | 3 | 82 | 1,31% | lock | 0 | 1 | bool | Lock feedback
 |  |  |  |  |  |  |  |  |  | trajectory_near | 1 | 1 | bool | Flag when trajectory in end windows
 |  |  |  |  |  |  |  |  |  | trajectory_finished | 2 | 1 | bool | Flag when trajectory ends
 |  | fb_position | 1 | 0x061 | yes | 10 | 6 | 111 | 0,89% | pos_x | 0 | 2 | int16 | Current Absolute X-axis position
 |  |  |  |  |  |  |  |  |  | pos_y | 2 | 2 | int16 | Current Absolute Y-axis position
 |  |  |  |  |  |  |  |  |  | pos_a | 4 | 2 | int16 | Current Absolute angle position
 |  | fb_speed | 2 | 0x062 | yes | 10 | 4 | 92 | 0,74% | speed_d | 0 | 2 | int16 | Current linear speed
 |  |  |  |  |  |  |  |  |  | speed_a | 2 | 2 | int16 | Current angular speed
 |  | fb_acceleration | 3 | 0x063 | yes | 10 | 4 | 92 | 0,74% | accel_d | 0 | 2 | int16 | Current linear acceleration
 |  |  |  |  |  |  |  |  |  | accel_a | 2 | 2 | int16 | Current angular acceleration
 |  | param_speed | 4 | 0x064 | no | 0 | 8 | 130 | 0,00% | speed_pos_max_d | 0 | 2 | int16 | Maximum allowed linear positive speed
 |  |  |  |  |  |  |  |  |  | speed_neg_max_d | 2 | 2 | int16 | Maximum allowed linear negative speed
 |  |  |  |  |  |  |  |  |  | speed_pos_max_a | 4 | 2 | int16 | Maximum allowed angular positive speed
 |  |  |  |  |  |  |  |  |  | speed_neg_max_a | 6 | 2 | int16 | Maximum allowed angular negative speed
 |  | param_accel | 5 | 0x065 | no | 0 | 6 | 111 | 0,00% | accel_max_d | 0 | 2 | int16 | Maximum allowed linear acceleration
 |  |  |  |  |  |  |  |  |  | deccel_max_d | 2 | 2 | int16 | Maximum allowed linear decceleration
 |  |  |  |  |  |  |  |  |  | deccel_max_a | 6 | 2 | int16 | Maximum allowed angular decceleration
 |  | command | 6 | 0x066 | yes | 0 | 7 | 120 | 0,00% | lock | 0 | 1 | uint16 | Motion lock configuration
 |  |  |  |  |  |  |  |  |  | stall | 1 | 1 | uint8 | Edges-stall (1:right, 2:left, 4:front: 8:back)
 |  |  |  |  |  |  |  |  |  | pos_reset_x | 3 | 2 | int16 | Reset X position to specified value
 |  |  |  |  |  |  |  |  |  | pos_reset_y | 5 | 2 | int16 | Reset Y position to specified value
 |  |  |  |  |  |  |  |  |  | trajectory_stop | 7 | 1 | bool | Command to stop the current trajectory
 |  | goto | 7 | 0x067 | no | 0 | 4 | 92 | 0,00% | pos_x | 0 | 2 | int16 | Absolute X coordinate to go
 |  |  |  |  |  |  |  |  |  | pos_y | 2 | 2 | int16 | Absolute Y coordinate to go
 |  | set_speed | 8 | 0x068 | no | 0 | 4 | 92 | 0,00% | speed_d | 0 | 2 | int16 | Set linear speed
 |  |  |  |  |  |  |  |  |  | speed_a | 2 | 2 | int16 | Set angular speed
 |  | move_relative | 9 | 0x069 | no | 0 | 4 | 92 | 0,00% | pos_rel_d | 0 | 2 | int16 | Distance consign
 |  |  |  |  |  |  |  |  |  | pos_rel_a | 2 | 2 | int16 | Angular consign
 |  | move_forward | 10 | 0x06A | no | 0 | 2 | 72 | 0,00% | pos_fwd_d | 0 | 2 | int16 | Distance consign
 |  | move_backward | 11 | 0x06B | no | 0 | 2 | 72 | 0,00% | pos_bwd_d | 0 | 2 | int16 | Distance consign
 |  | turn_right | 12 | 0x06C | no | 0 | 2 | 72 | 0,00% | pos_r_a | 0 | 2 | int16 | Angular consign
 |  | turn_left | 13 | 0x06D | no | 0 | 2 | 72 | 0,00% | pos_l_a | 0 | 2 | int16 | Angular consign
actuators | 4 | blower_left | 0 | 0x080 | no | 0 | 2 | 72 | 0,00% | position | 0 | 1 | uint8 | Desired blower position
 |  |  |  |  |  |  |  |  |  | speed | 1 | 1 | uint8 | Optionnal speed of blowing
 |  | blower_right | 1 | 0x081 | no | 0 | 2 | 72 | 0,00% | position | 0 | 1 | uint8 | Desired blower position
 |  |  |  |  |  |  |  |  |  | speed | 1 | 1 | uint8 | Optionnal speed of blowing
 |  | loader | 2 | 0x082 | no | 0 | 2 | 72 | 0,00% | lift | 0 | 1 | uint8 | Position of the lift actuator
 |  |  |  |  |  |  |  |  |  | grab | 1 | 1 | uint8 | Position of the grabbing actuator
 |  | launcher | 3 | 0x083 | no | 0 | 2 | 72 | 0,00% | speed | 0 | 2 | uint8 | Launcher regulated speed command (0 = off)
 |  | deflector | 4 | 0x084 | no | 0 | 1 | 63 | 0,00% | deflect | 0 | 1 | bool | Launcher deflector activation
 |  | pump | 5 | 0x085 | no | 0 | 1 | 63 | 0,00% | pump | 0 | 1 | bool | Funny action activation
sensors | 5 | left_color | 0 | 0x0A0 | no | 5 | 1 | 63 | 0,25% | color | 0 | 1 | uint8 | Sensed color of left RGB color sensor
 |  | right_color | 1 | 0x0A1 | no | 5 | 1 | 63 | 0,25% | color | 0 | 1 | uint8 | Sensed color of right RGB color sensor
 |  | cherry_color | 2 | 0x0A2 | no | 5 | 1 | 63 | 0,25% | color | 0 | 1 | uint8 | Sensed color of cherry RGB color sensor
 |  | plate | 3 | 0x0A3 | no | 5 | 1 | 63 | 0,25% | presence | 0 | 1 | bool | Presence of a plate
system | 8 | status | 0 | 0x100 | yes | 1 | 2 | 72 | 0,06% | node | 0 | 1 | uint8 | Node's id
 |  |  |  |  |  |  |  |  |  | state | 1 | 1 | uint8 | General feedback status ; by sending this the node indicates that it's alive
 |  | match | 1 | 0x101 | no | 0 | 6 | 111 | 0,00% | state | 0 | 1 | uint8 | Match state global variable
 |  |  |  |  |  |  |  |  |  | color | 1 | 1 | bool | Color picked for the match
 |  |  |  |  |  |  |  |  |  | points | 2 | 2 | uint16 | Current count of points (or estimation)
 |  |  |  |  |  |  |  |  |  | timestamp | 4 | 2 | uint16 | Global match timestamp. Unit: 100ms. 0 if not started
 |  | bist_launch | 2 | 0x102 | no | 0 | 1 | 63 | 0,00% | node | 0 | 1 | uint8 | Launch Build-In-Self-Test on specified node(s)
 |  | bist_status | 3 | 0x103 | no | 0 | 3 | 82 | 0,00% | node | 0 | 1 | uint8 | Node's id
 |  |  |  |  |  |  |  |  |  | status | 1 | 2 | uint16 | Bist status feedback for specified id
boot | 14 | node_0 | 0 | 0x1C0 | no | 0 | 8 | 130 | 0,00% | boot_cmd | 0 | 1 | uint8 | Bootload command for node 0
 |  |  |  |  |  |  |  |  |  | boot_data | 1 | 7 | array | Bootload data for node 0
 |  | node_1 | 1 | 0x1C1 | no | 0 | 8 | 130 | 0,00% | boot_cmd | 0 | 1 | uint8 | Bootload command for node 1
 |  |  |  |  |  |  |  |  |  | boot_data | 1 | 7 | array | Bootload data for node 1
 |  | node_2 | 2 | 0x1C2 | no | 0 | 8 | 130 | 0,00% | boot_cmd | 0 | 1 | uint8 | Bootload command for node 2
 |  |  |  |  |  |  |  |  |  | boot_data | 1 | 7 | array | Bootload data for node 2
 |  | node_3 | 3 | 0x1C3 | no | 0 | 8 | 130 | 0,00% | boot_cmd | 0 | 1 | uint8 | Bootload command for node 3
 |  |  |  |  |  |  |  |  |  | boot_data | 1 | 7 | array | Bootload data for node 3
 |  | node_4 | 4 | 0x1C4 | no | 0 | 8 | 130 | 0,00% | boot_cmd | 0 | 1 | uint8 | Bootload command for node 4
 |  |  |  |  |  |  |  |  |  | boot_data | 1 | 7 | array | Bootload data for node 4
 |  | node_5 | 5 | 0x1C5 | no | 0 | 8 | 130 | 0,00% | boot_cmd | 0 | 1 | uint8 | Bootload command for node 5
 |  |  |  |  |  |  |  |  |  | boot_data | 1 | 7 | array | Bootload data for node 5
 |  | node_6 | 6 | 0x1C6 | no | 0 | 8 | 130 | 0,00% | boot_cmd | 0 | 1 | uint8 | Bootload command for node 6
 |  |  |  |  |  |  |  |  |  | boot_data | 1 | 7 | array | Bootload data for node 6
 |  | node_7 | 7 | 0x1C7 | no | 0 | 8 | 130 | 0,00% | boot_cmd | 0 | 1 | uint8 | Bootload command for node 7
 |  |  |  |  |  |  |  |  |  | boot_data | 1 | 7 | array | Bootload data for node 7
debug | 15 | printf | 0 | 0x1E0 | no | 0 | 8 | 130 | 0,00% | node | 0 | 1 | uint8 | Emitter node id
 |  |  |  |  |  |  |  |  |  | data | 1 | 7 | array | String data: always 7 bytes (pad with 0 if string is finished)
END OF TABLE
 |  |  |  | Bus Statistics
 |  |  |  | Useful data (bytes/s) = |  |  | 627
 |  |  |  | Bus load (bytes/s) = |  |  | 1958,375
 |  |  |  | Bus load = |  |  | 12,53%

Sheet: Robot Architecture
IGrebot 2013 |  |  |  |  |  |  |  | Robot Architecture
 |  | Osiris Back Right |  |  | Osiris Back Left
 |  |  |  |  |  |  |  | : sensor
 |  |  |  |  |  |  |  | : actuator
 |  |  |  |  |  | Pump | On | : state
 |  |  |  |  |  |  | Off | : cmd
Folded |  |  |  |  |  |  | Folded
Up | Blower left |  |  |  |  | Blower right | Up
Down |  |  |  |  |  |  | Down
Blue |  |  |  |  |  |  | Blue
Red | Color left |  |  |  |  | Color right | Red
White |  |  |  |  |  |  | White
Other |  |  |  |  |  |  | Other
White | Cherry color
Not white
On | Launcher
Off
On | Deflector
Off |  |  |  |  |  | Plate sensor | Plate
 |  |  |  |  |  |  | No plate
 |  | Osiris Front Right |  |  | Osiris Front Left
 |  |  | Loader | Lift
 |  |  |  | Grab
