I-Grebot/Laser_Beacon_V3.0/Softwares/common/can/holonome/doc/igrebot_can_2013.xlsm

Sheet: CAN Protocol
Standard CAN
Fixed size = | 44 | bits
Bit-stuffing ratio = | 1.2 | when using NRZ-5
Bus speed = | 125 | kbit/s

Sheet: IGrebot's CAN
Lower SID = Higher Priority
Priorities (4 values) |  |  |  | CAN Id
ID[10:9] | Mnemonic | Description |  | 10 | 9 | 8 | 7 | 6 | 5 | 4 | 3 | 2 | 1 | 0
0 | high | Highest priority | CAN Message | Priority |  | Category |  |  |  | Message
1 | default | Default priority
2 | low | Low priority
3 | diag | Used for diagnosis and debug messages
Categories (16 values)
ID[8:5] | Mnemonic | Description
0 | supply | Critical messages linked with power supply and batteries managment
1 | avoidance | Messages related to the robot avoidance system (except beacons)
2 | beacon | Specific messages related to the beacon(s) managment
3 | motion | Robot motion messages
4 | actuators | Actuators related messages (except motion managment)
5 | unused
6 | unused
7 | unused
8 | system | High-level messages, related to strategy and system managment
9 | unused
10 | unused
11 | unused
12 | unused
13 | unused
14 | boot | Bootloading messages, dedicated for self-writing over CAN purposes
15 | debug | Messages which purely have a debug purpose
Message ID (32 per category)
ID [4:0]
They are all specific to the category.

Sheet: CAN Messages Table
IGrebot 2013 - Holonomic |  |  |  |  |  |  | CAN Messages Table
Category |  | Message |  | CAN Id | RTR allowed | Reccurence (msg/s) | Length (bytes) | Frame size (bits) | Frame's bus-load | Payload content
Mnemonic | Id | Mnemonic | Id |  |  |  |  |  |  | Bitfield | Byte no. | Length | Description
supply | 0 | status | 0 | 0x000 | yes | 20 | 4 | 92 | 1.47% | fault | 0 | 1 | Indicates any critical fault
 |  |  |  |  |  |  |  |  |  | battery_voltage | 1 | 2 | Main batteries voltage
 |  |  |  |  |  |  |  |  |  | emergency_stop | 4 | 1 | Indicates that emergency button is pushed down
 |  | command | 1 | 0x001 | no | 0 | 1 | 63 | 0.00% | shutdown | 0 | 1 | Command a power supply to be shutdown
avoidance | 1 | Corner_1 | 0 | 0x020 | yes | 5 | 8 | 130 | 0.52% | Sharps1 | 0 | 2 | Indicates the distance measured by the sharp1 sensor
 |  |  |  |  |  |  |  |  |  | Sharps2 | 2 | 2 | Indicates the distance measured by the sharp2 sensor
 |  |  |  |  |  |  |  |  |  | Sharps3 | 4 | 2 | Indicates the distance measured by the sharp3 sensor
 |  |  |  |  |  |  |  |  |  | Us | 6 | 2 | Indicates the distance measured by the US sensor
 |  | Corner_2 | 1 | 0x021 | yes | 5 | 8 | 130 | 0.52% | Sharps1 | 0 | 2 | Indicates the distance measured by the sharp1 sensor
 |  |  |  |  |  |  |  |  |  | Sharps2 | 2 | 2 | Indicates the distance measured by the sharp2 sensor
 |  |  |  |  |  |  |  |  |  | Sharps3 | 4 | 2 | Indicates the distance measured by the sharp3 sensor
 |  |  |  |  |  |  |  |  |  | Us | 6 | 2 | Indicates the distance measured by the US sensor
 |  | Corner_3 | 2 | 0x022 | yes | 5 | 8 | 130 | 0.52% | Sharps1 | 0 | 2 | Indicates the distance measured by the sharp1 sensor
 |  |  |  |  |  |  |  |  |  | Sharps2 | 2 | 2 | Indicates the distance measured by the sharp2 sensor
 |  |  |  |  |  |  |  |  |  | Sharps3 | 4 | 2 | Indicates the distance measured by the sharp3 sensor
 |  |  |  |  |  |  |  |  |  | Us | 6 | 2 | Indicates the distance measured by the US sensor
beacon | 2 | opponent | 0 | 0x040 | yes | 5 | 6 | 111 | 0.44% | opponent_main_pos_x | 0 | 1 | Opponent main robot's X-axis position
 |  |  |  |  |  |  |  |  |  | opponent_main_pos_y | 1 | 1 | Opponent main robot's Y-axis position
 |  |  |  |  |  |  |  |  |  | opponent_main_pos_a | 2 | 1 | Opponent main robot's angle relative to the robot's front
 |  |  |  |  |  |  |  |  |  | opponent_second_pos_x | 3 | 1 | Opponent's X-axis position
 |  |  |  |  |  |  |  |  |  | opponent_second_pos_y | 4 | 1 | Opponent's Y-axis position
 |  |  |  |  |  |  |  |  |  | opponent_second_pos_a | 5 | 1 | Opponent's angle relative to the robot's front
motion | 3 | fb_wheel_1 | 0 | 0x060 | yes | 20 | 2 | 72 | 1.15% | pos_x | 0 | 1 | Current Absolute X-axis position of wheel 1
 |  |  |  |  |  |  |  |  |  | pos_y | 1 | 1 | Current Absolute Y-axis position of wheel 1
 |  | fb_wheel_2 | 1 | 0x061 | yes | 20 | 2 | 72 | 1.15% | pos_x | 0 | 1 | Current Absolute X-axis position of wheel 2
 |  |  |  |  |  |  |  |  |  | pos_y | 1 | 1 | Current Absolute Y-axis position of wheel 2
 |  | fb_wheel_3 | 2 | 0x062 | yes | 20 | 2 | 72 | 1.15% | pos_x | 0 | 1 | Current Absolute X-axis position of wheel 3
 |  |  |  |  |  |  |  |  |  | pos_y | 1 | 1 | Current Absolute Y-axis position of wheel 3
 |  | fb_motor_1 | 3 | 0x063 | yes | 5 | 3 | 82 | 0.33% | motor_speed | 0 | 2 | Get speed of wheel 1
 |  |  |  |  |  |  |  |  |  | fault | 2 | 1 | Indicates any critical fault on motor driver 1
 |  | fb_motor_2 | 4 | 0x064 | yes | 5 | 3 | 82 | 0.33% | motor_speed | 0 | 2 | Get speed of wheel 2
 |  |  |  |  |  |  |  |  |  | fault | 2 | 1 | Indicates any critical fault on motor driver 2
 |  | fb_motor_3 | 5 | 0x065 | yes | 5 | 3 | 82 | 0.33% | motor_speed | 0 | 2 | Get speed of wheel 3
 |  |  |  |  |  |  |  |  |  | fault | 2 | 1 | Indicates any critical fault on motor driver 3
 |  | param_speed | 6 | 0x066 | no | 20 | 6 | 111 | 1.78% | motor1_speed | 0 | 2 | Set speed of wheel 1
 |  |  |  |  |  |  |  |  |  | motor2_speed | 2 | 2 | Set speed of wheel 2
 |  |  |  |  |  |  |  |  |  | motor3_speed | 4 | 2 | Set speed of wheel 3
actuators | 4 | command | 0 | 0x080 | no | 0 | 6 | 111 | 0.00% | load | 0 | 1 | Order the actuators to load something (cd, totem)
 |  |  |  |  |  |  |  |  |  | unload | 1 | 1 | Order the actuators to empty the robot from its items
 |  |  |  |  |  |  |  |  |  | lift_left | 2 | 1 | Move left lift (vitesse) positive->up, negative->down
 |  |  |  |  |  |  |  |  |  | lift_right | 3 | 1 | Move right lift (vitesse) positive->up, negative->down
 |  |  |  |  |  |  |  |  |  | arm_left | 4 | 1 | Move left arm (position, vaccuum)
 |  |  |  |  |  |  |  |  |  | arm_right | 5 | 1 | Move right arm (position, vaccuum)
Robot | 5 | position | 0 | 0x0A0 | yes | 20 | 6 | 111 | 1.78% | x | 0 | 2 | Current Absolute X-axis position of robot
 |  |  |  |  |  |  |  |  |  | y | 2 | 2 | Current Absolute Y-axis position of robot
 |  |  |  |  |  |  |  |  |  | a | 4 | 2 | Current Absolute angle of robot
 |  | speed | 1 | 0x0A1 | yes | 5 | 6 | 111 | 0.44% | x | 0 | 2 | Current speed of the robot following X-axis
 |  |  |  |  |  |  |  |  |  | y | 2 | 2 | Current speed of the robot following Y-axis
 |  |  |  |  |  |  |  |  |  | a | 4 | 2 | Current rotational speed of the robot
 |  | acceleration | 2 | 0x0A2 | yes | 5 | 6 | 111 | 0.44% | x | 0 | 2 | Current acceleration of the robot following X-axis
 |  |  |  |  |  |  |  |  |  | y | 2 | 2 | Current acceleration of the robot following Y-axis
 |  |  |  |  |  |  |  |  |  | a | 4 | 2 | Current rotational acceleration of the robot
System | 6 | sync | 0 | 0x0C0 | no | 0 | 2 | 72 | 0.00% | timestamp | 0 | 2 | Global match timestamp. Unit: 100ms. 0 if not started
 |  | bist_launch | 1 | 0x0C1 | no | 0 | 1 | 63 | 0.00% | node | 0 | 1 | Launch Build-In-Self-Test on specified node(s)
boot | 14 | node_0 | 0 | 0x1C0 | no | 0 | 8 | 130 | 0.00% | boot_cmd | 0 | 1 | Bootload command for node 0
 |  |  |  |  |  |  |  |  |  | boot_data | 1 | 7 | Bootload data for node 0
 |  | node_1 | 1 | 0x1C1 | no | 0 | 8 | 130 | 0.00% | boot_cmd | 0 | 1 | Bootload command for node 1
 |  |  |  |  |  |  |  |  |  | boot_data | 1 | 7 | Bootload data for node 1
 |  | node_2 | 2 | 0x1C2 | no | 0 | 8 | 130 | 0.00% | boot_cmd | 0 | 1 | Bootload command for node 2
 |  |  |  |  |  |  |  |  |  | boot_data | 1 | 7 | Bootload data for node 2
 |  | node_3 | 3 | 0x1C3 | no | 0 | 8 | 130 | 0.00% | boot_cmd | 0 | 1 | Bootload command for node 3
 |  |  |  |  |  |  |  |  |  | boot_data | 1 | 7 | Bootload data for node 3
 |  | node_4 | 4 | 0x1C4 | no | 0 | 8 | 130 | 0.00% | boot_cmd | 0 | 1 | Bootload command for node 4
 |  |  |  |  |  |  |  |  |  | boot_data | 1 | 7 | Bootload data for node 4
 |  | node_5 | 5 | 0x1C5 | no | 0 | 8 | 130 | 0.00% | boot_cmd | 0 | 1 | Bootload command for node 5
 |  |  |  |  |  |  |  |  |  | boot_data | 1 | 7 | Bootload data for node 5
 |  | node_6 | 6 | 0x1C6 | no | 0 | 8 | 130 | 0.00% | boot_cmd | 0 | 1 | Bootload command for node 6
 |  |  |  |  |  |  |  |  |  | boot_data | 1 | 7 | Bootload data for node 6
 |  | node_7 | 7 | 0x1C7 | no | 0 | 8 | 130 | 0.00% | boot_cmd | 0 | 1 | Bootload command for node 7
 |  |  |  |  |  |  |  |  |  | boot_data | 1 | 7 | Bootload data for node 7
debug | 15 | to be completed | 0
END OF TABLE
 |  |  |  | Bus Statistics
 |  |  |  | Useful data (bytes/s) = |  |  | 695
 |  |  |  | Bus load (bytes/s) = |  |  | 1930.625
 |  |  |  | Bus load = |  |  | 12.36%
