I-Grebot/Laser_Beacon_V3.0/Mechanics/beacons_setup.SLDASM

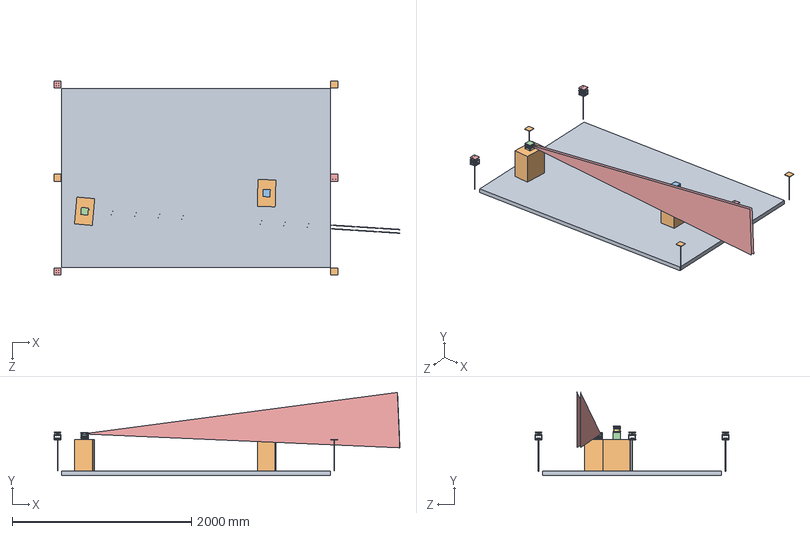
[picture p63: CAD file, 2016-11-03]
Mechanics/beacons_setup.SLDASM
3856.8 x 926.9 x 2164.0 mm
dummy_table
dummy_table_holder x 6
drum_head_bot
drum_head_top
laser_12x32_10deg x 2
turret_laser_12x32_holder
board_tud
drum_head_motor
drum_head_magnet
turret_holder
spacer_screw_M4x20 x 4
turret_top
spacer_screw_M4x15 x 4
spacer_screw_M4x30 x 4
board_btx
spacer_M4x5 x 4
laser_guide x 2
dummy_robot x 2
screw_M4x25 x 4
opponent_holder
beacon_stair_1 x 4
board_brx x 4
board_pdd x 16
spacer_M3x5 x 16
spacer_screw_M3x25 x 20
beacon_stair_2 x 4
beacon_stair_3 x 4
screw_M3x10 x 16
screw_M3x15 x 16
battery_70x40x15 x 4
light_shutter x 4
spacer_screw_M3x40 x 12
nut_M3 x 12
