I-Grebot/Laser_Beacon_V3.0/Mechanics/panels/laser_beacon_panel1.SLDASM

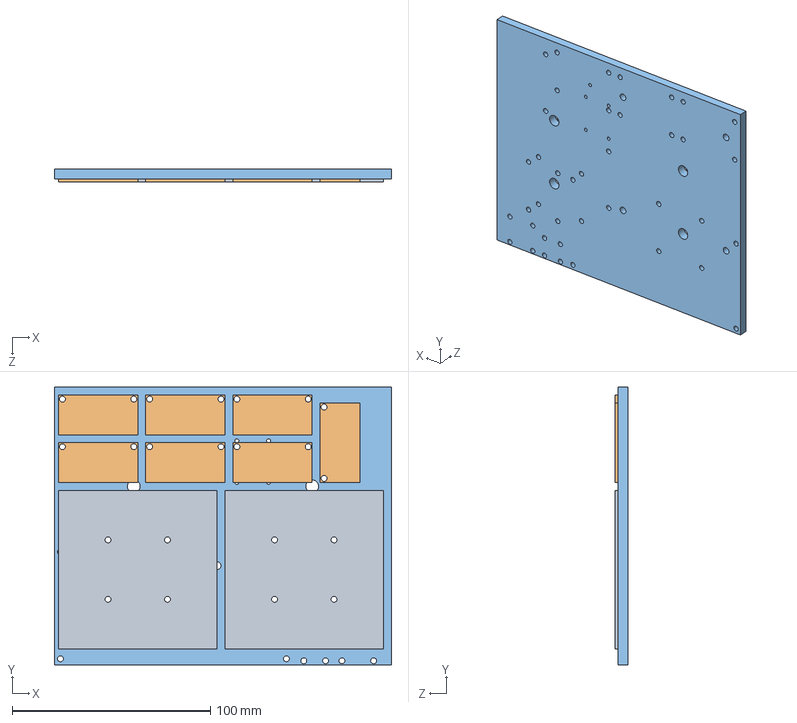
[picture p64: CAD file, 2016-11-03]
Mechanics/panels/laser_beacon_panel1.SLDASM
170.0 x 140.0 x 6.60 mm
board_brx x 2
board_pdd x 7
Board_cutting
