I-Grebot/Laser_Beacon_V3.0/Mechanics/panels/laser_beacon_panel2.SLDASM

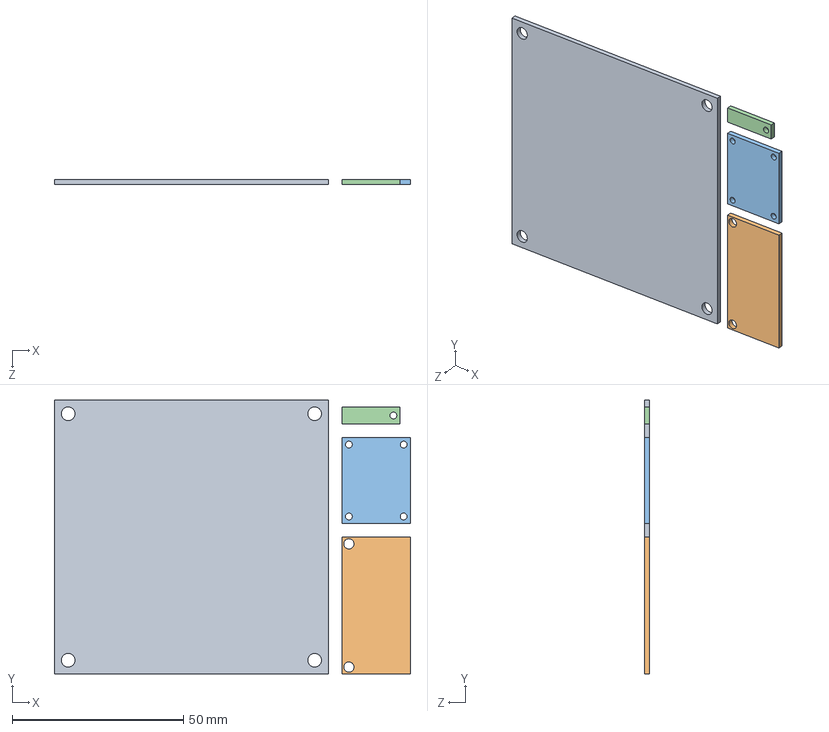
[picture p65: CAD file, 2016-11-03]
Mechanics/panels/laser_beacon_panel2.SLDASM
104.0 x 80.0 x 1.60 mm
board_btx
board_pdd
board_tud
board_pov
