I-Grebot/Laser_Beacon_V3.0/Mechanics/dummies/opponent_robot.SLDASM

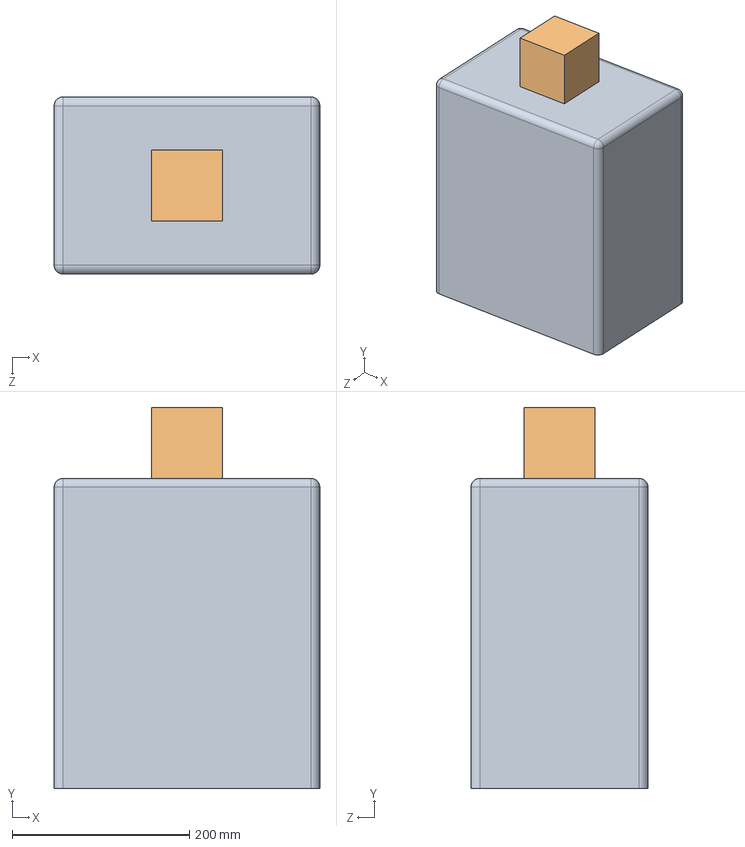
[picture p67: CAD file, 2016-11-03]
Mechanics/dummies/opponent_robot.SLDASM
300.0 x 430.0 x 200.0 mm
dummy_robot
opponent_holder
