I-Grebot/Laser_Beacon_V3.0/Mechanics/dummies/friend_robot.SLDASM

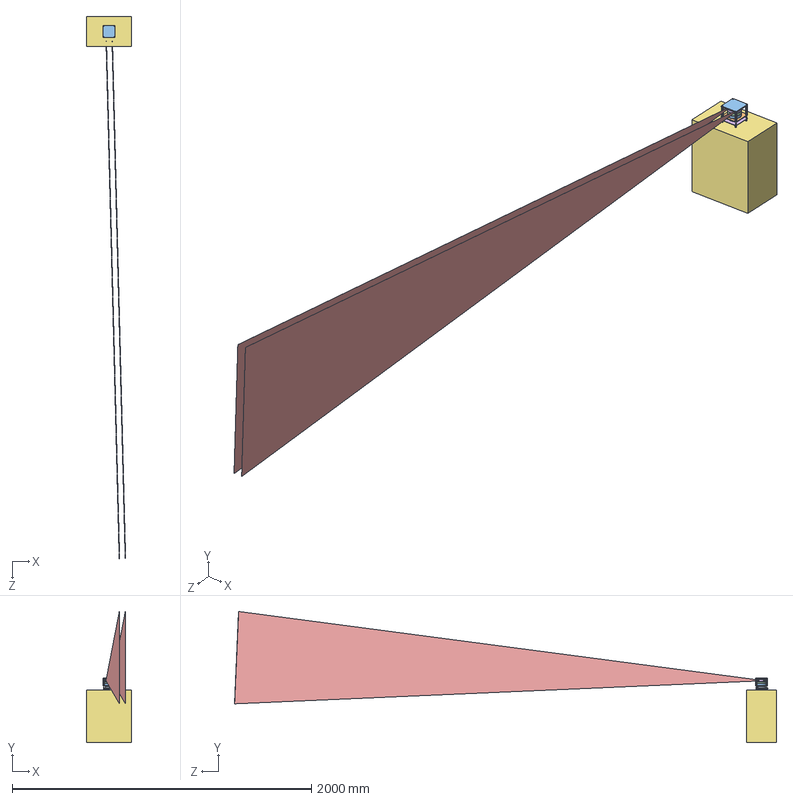
[picture p68: CAD file, 2016-11-03]
Mechanics/dummies/friend_robot.SLDASM
300.0 x 875.2 x 3621.2 mm
drum_head_bot
drum_head_top
laser_12x32_10deg x 2
turret_laser_12x32_holder
board_tud
drum_head_motor
drum_head_magnet
turret_holder
turret_top
spacer_screw_M4x15 x 4
spacer_screw_M4x30 x 4
board_btx
spacer_M4x5 x 4
laser_guide x 2
dummy_robot
screw_M4x25 x 4
