I-Grebot/Laser_Beacon_V3.0/Mechanics/beacons/beacon_table.SLDASM

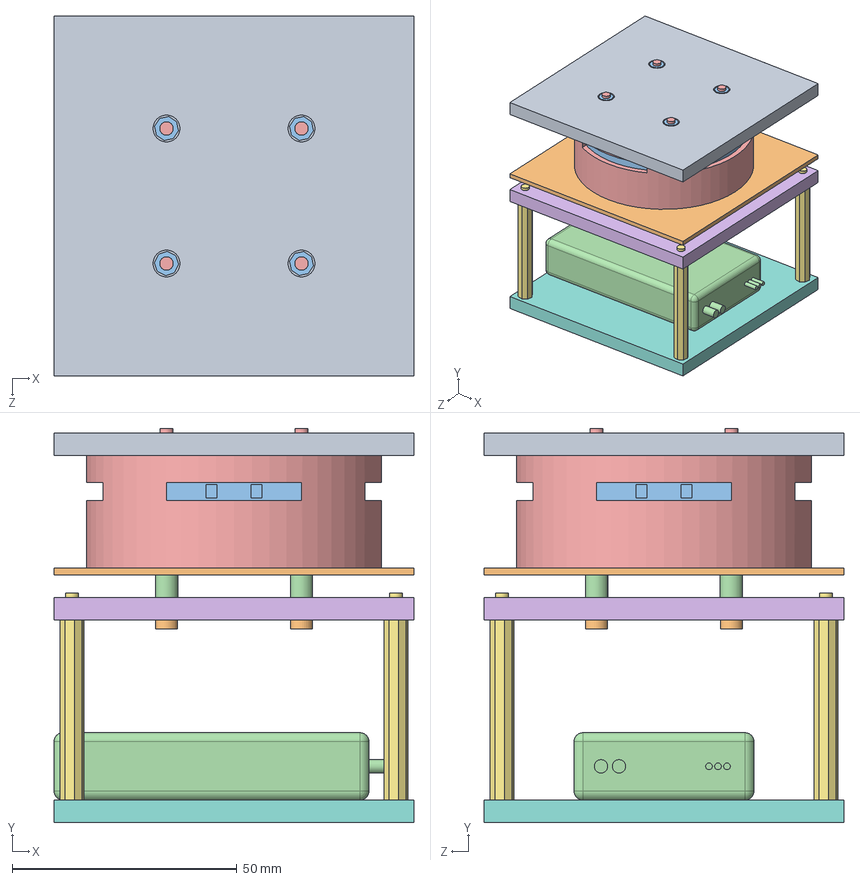
[picture p70: CAD file, 2016-11-03]
Mechanics/beacons/beacon_table.SLDASM
80.0 x 87.6 x 80.0 mm
beacon_stair_1
board_brx
board_pdd x 4
spacer_M3x5 x 4
spacer_screw_M3x25 x 4
beacon_stair_2
spacer_screw_M3x40 x 4
beacon_stair_3
screw_M3x10 x 4
screw_M3x15 x 4
nut_M3 x 4
battery_70x40x15
light_shutter
