I-Grebot/Laser_Beacon_V3.0/Mechanics/beacons/negative_film.SLDPRT

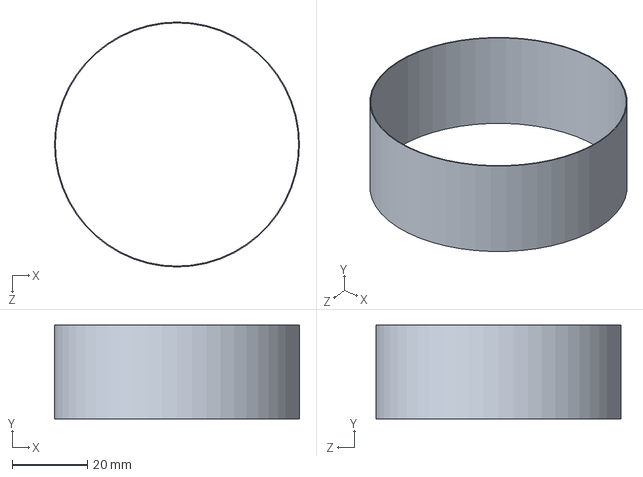
[picture p71: CAD file, 2016-11-03]
Mechanics/beacons/negative_film.SLDPRT
65.2 x 25.0 x 65.2 mm
