I-Grebot/Laser_Beacon_V3.0/Mechanics/dummies/dummy_table.SLDPRT

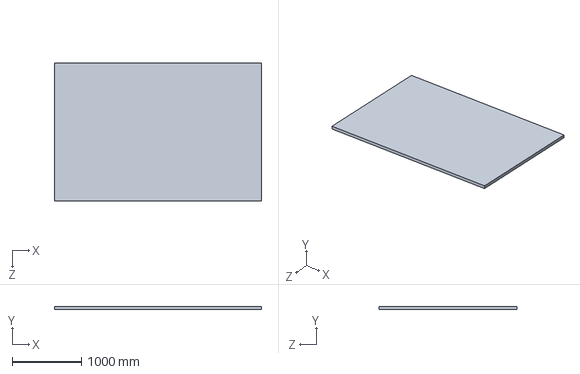
[picture p72: CAD file, 2016-11-03]
Mechanics/dummies/dummy_table.SLDPRT
3000.0 x 50.0 x 2000.0 mm
