I-Grebot/Laser_Beacon_V3.0/Mechanics/turret/board_pov.SLDPRT

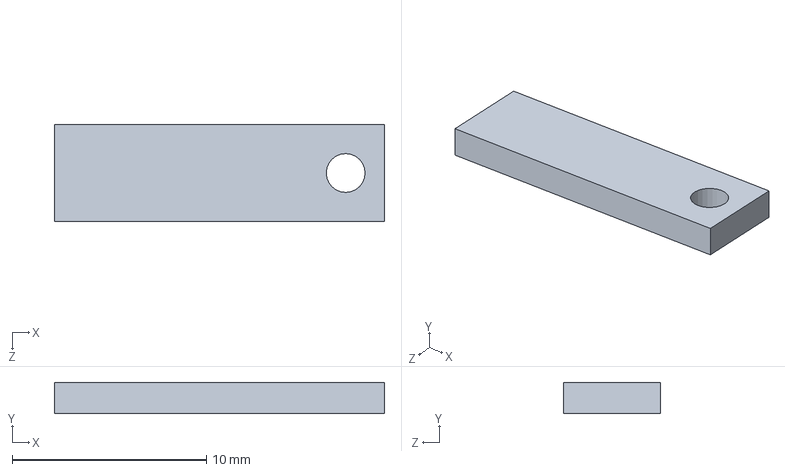
[picture p73: CAD file, 2016-11-03]
Mechanics/turret/board_pov.SLDPRT
17.0 x 1.60 x 5.00 mm
