I-Grebot/Laser_Beacon_V3.0/Mechanics/beacons/board_pdd.SLDPRT

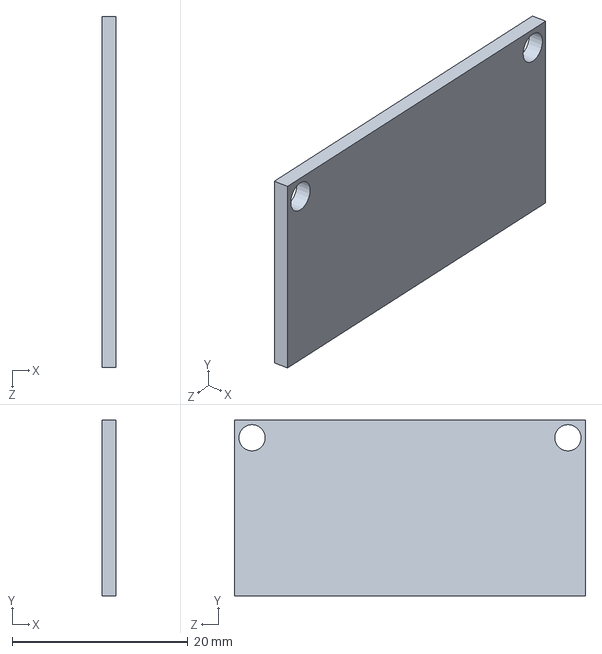
[picture p74: CAD file, 2016-11-03]
Mechanics/beacons/board_pdd.SLDPRT
1.60 x 20.0 x 40.0 mm
