I-Grebot/Laser_Beacon_V3.0/Mechanics/dummies/battery_70x40x15.SLDPRT

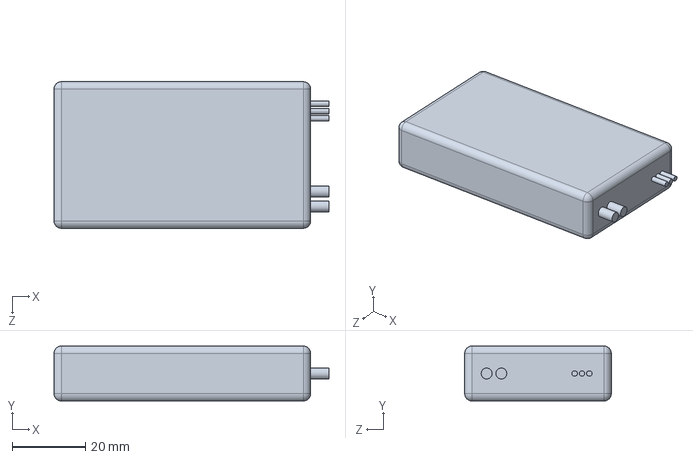
[picture p75: CAD file, 2016-11-03]
Mechanics/dummies/battery_70x40x15.SLDPRT
75.0 x 15.0 x 40.0 mm
