I-Grebot/Laser_Beacon_V3.0/Mechanics/beacons/beacon_stair_3.SLDPRT

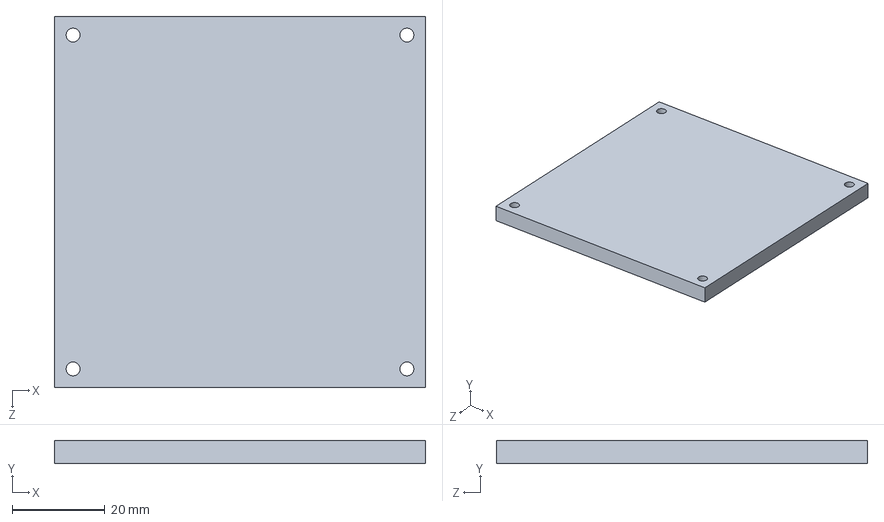
[picture p76: CAD file, 2016-11-03]
Mechanics/beacons/beacon_stair_3.SLDPRT
80.0 x 5.00 x 80.0 mm
