I-Grebot/Laser_Beacon_V3.0/Mechanics/turret/board_tud.SLDPRT

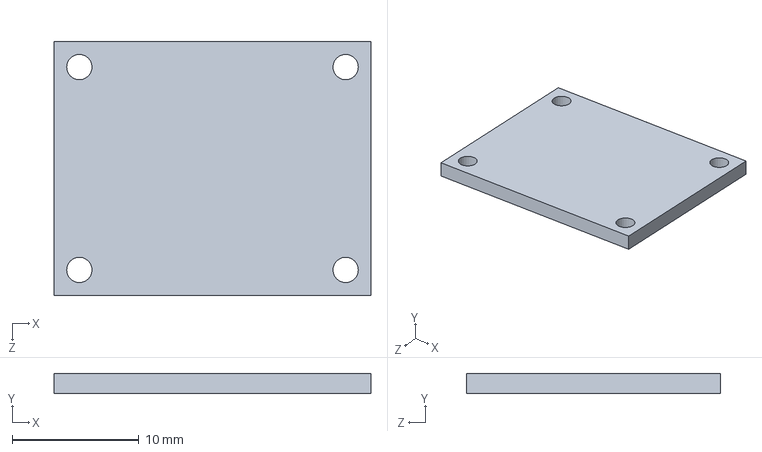
[picture p77: CAD file, 2016-11-03]
Mechanics/turret/board_tud.SLDPRT
25.0 x 1.60 x 20.0 mm
