I-Grebot/Laser_Beacon_V3.0/Mechanics/dummies/team_flag.SLDPRT

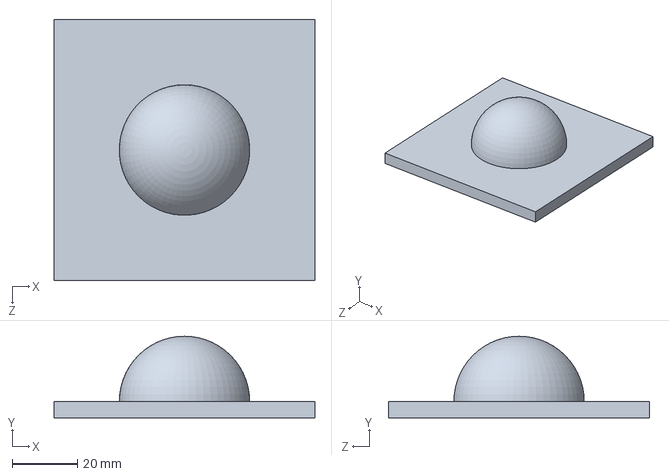
[picture p78: CAD file, 2016-11-03]
Mechanics/dummies/team_flag.SLDPRT
80.0 x 25.0 x 80.0 mm
