I-Grebot/Laser_Beacon_V3.0/Mechanics/turret/laser_guide.SLDPRT

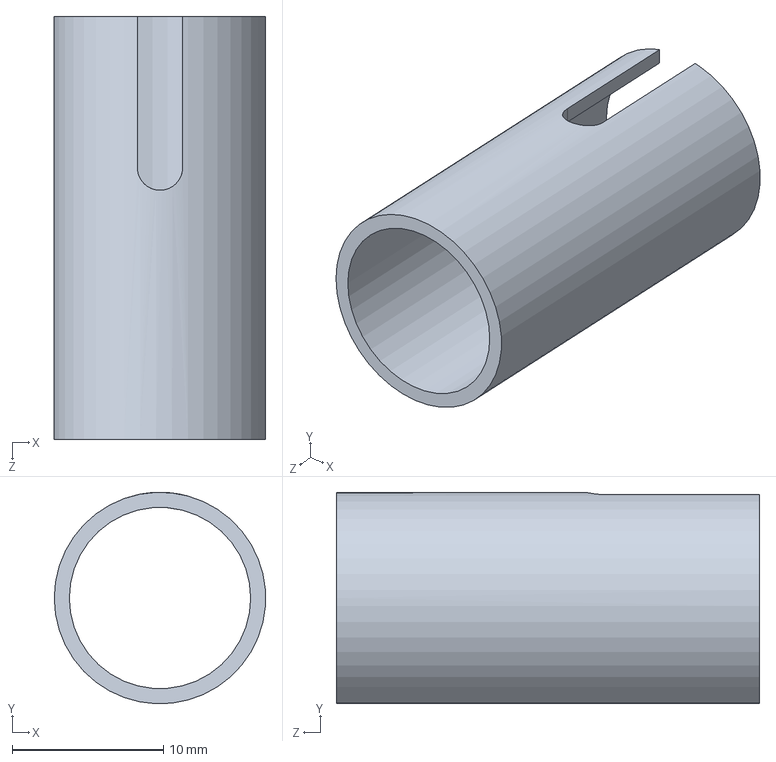
[picture p79: CAD file, 2016-11-03]
Mechanics/turret/laser_guide.SLDPRT
14.0 x 14.0 x 28.0 mm
