I-Grebot/Laser_Beacon_V3.0/Mechanics/dummies/opponent_holder.SLDPRT

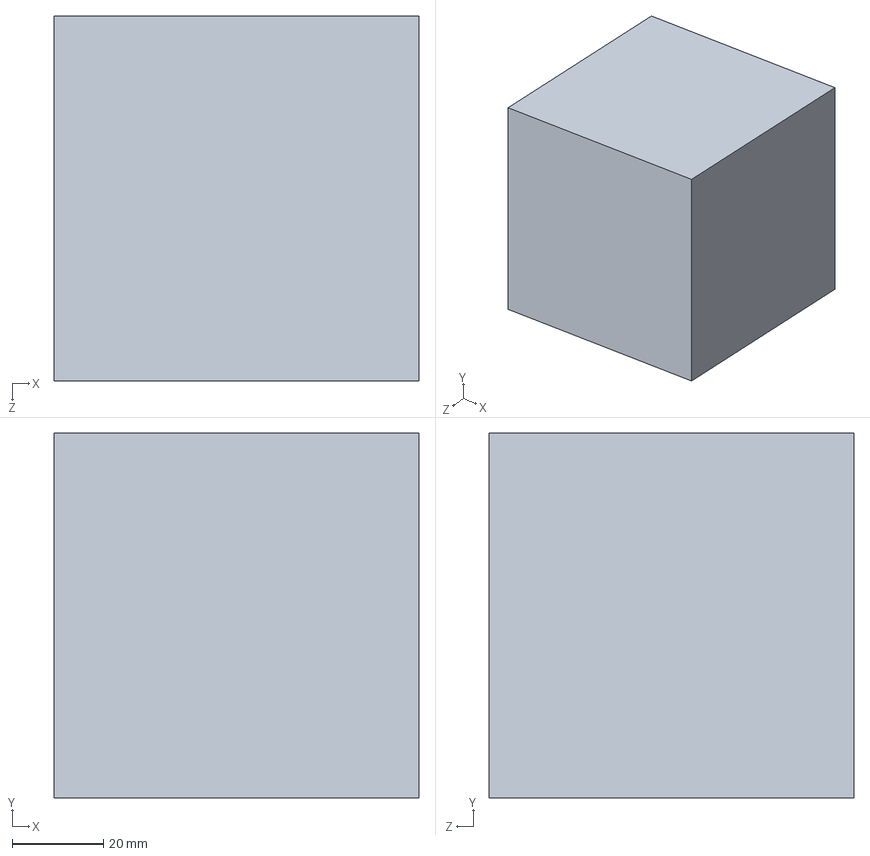
[picture p80: CAD file, 2016-11-03]
Mechanics/dummies/opponent_holder.SLDPRT
80.0 x 80.0 x 80.0 mm
