I-Grebot/Laser_Beacon_V3.0/Mechanics/turret/laser_12x32_10deg.SLDPRT

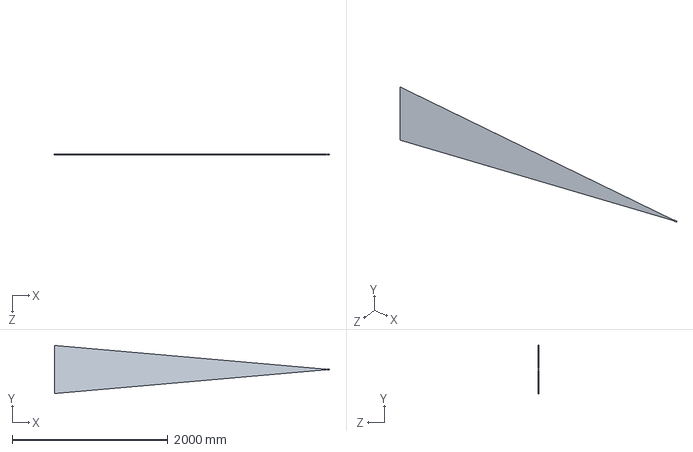
[picture p81: CAD file, 2016-11-03]
Mechanics/turret/laser_12x32_10deg.SLDPRT
3533.0 x 617.9 x 12.0 mm
