I-Grebot/Laser_Beacon_V3.0/Mechanics/dummies/dummy_table_holder.SLDPRT

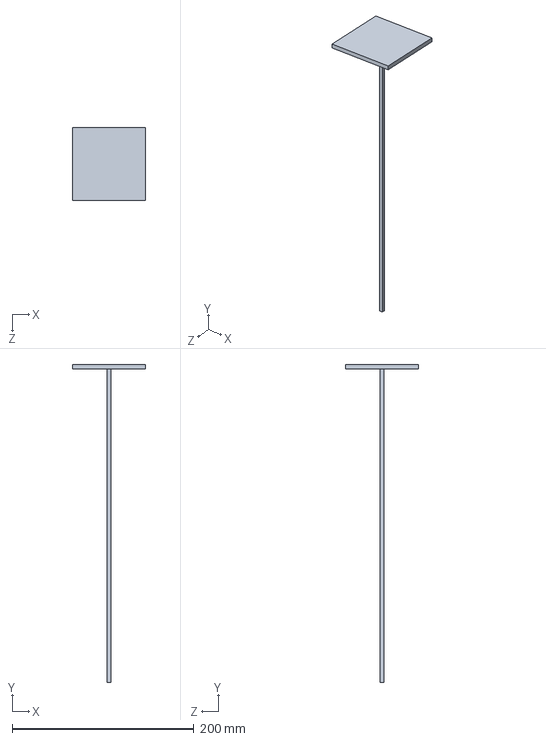
[picture p82: CAD file, 2016-11-03]
Mechanics/dummies/dummy_table_holder.SLDPRT
80.0 x 350.0 x 80.0 mm
