I-Grebot/Laser_Beacon_V3.0/Mechanics/turret/drum_head_magnet.SLDPRT

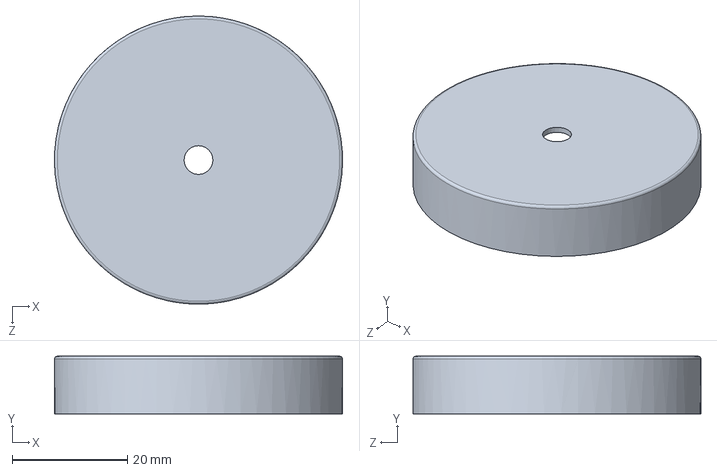
[picture p83: CAD file, 2016-11-03]
Mechanics/turret/drum_head_magnet.SLDPRT
50.0 x 10.0 x 50.0 mm
