I-Grebot/Laser_Beacon_V3.0/Mechanics/beacons/light_shutter.SLDPRT

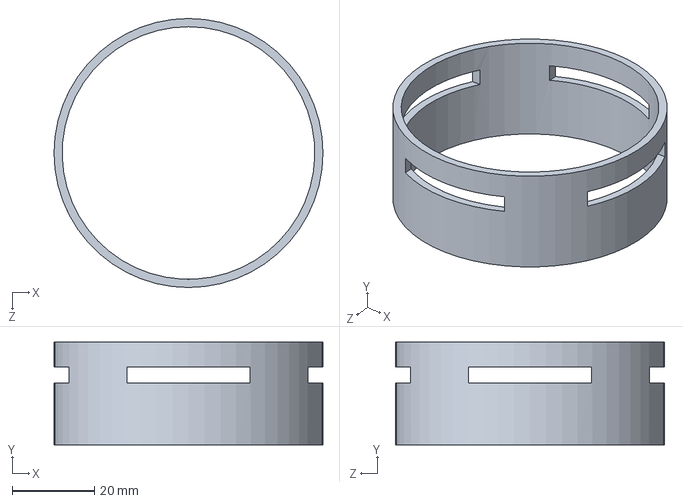
[picture p84: CAD file, 2016-11-03]
Mechanics/beacons/light_shutter.SLDPRT
65.5 x 25.0 x 65.5 mm
