I-Grebot/Laser_Beacon_V3.0/Mechanics/dummies/dummy_robot.SLDPRT

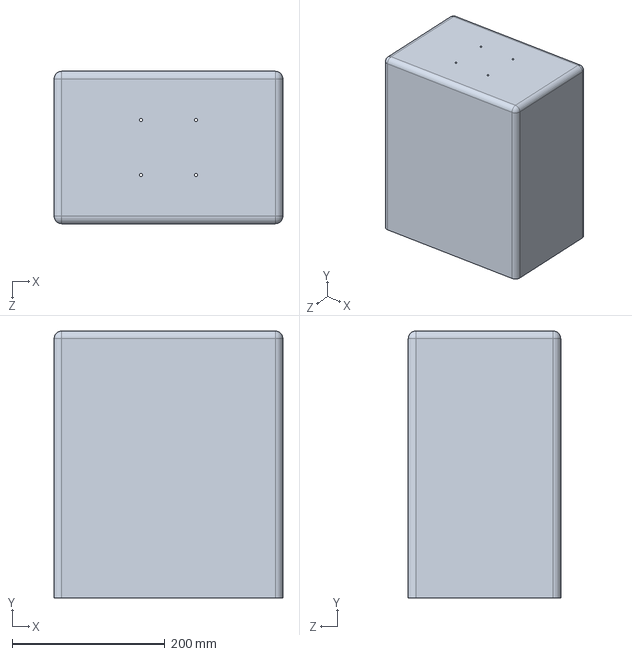
[picture p85: CAD file, 2016-11-03]
Mechanics/dummies/dummy_robot.SLDPRT
300.0 x 350.0 x 200.0 mm
