I-Grebot/Laser_Beacon_V3.0/Mechanics/turret/drum_head_bot.SLDPRT

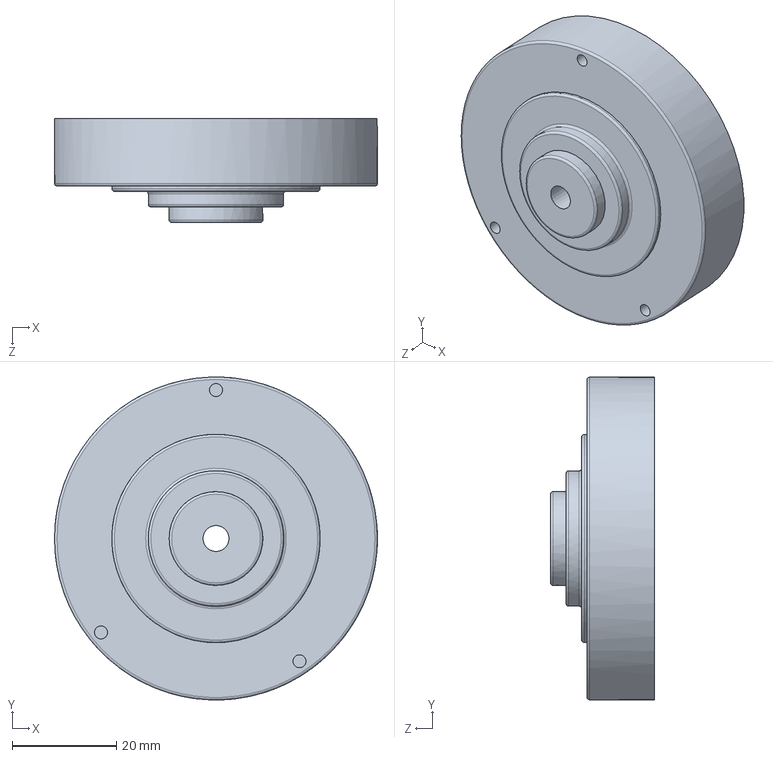
[picture p86: CAD file, 2016-11-03]
Mechanics/turret/drum_head_bot.SLDPRT
62.0 x 62.0 x 20.0 mm
