I-Grebot/Laser_Beacon_V3.0/Mechanics/beacons/board_brx.SLDPRT

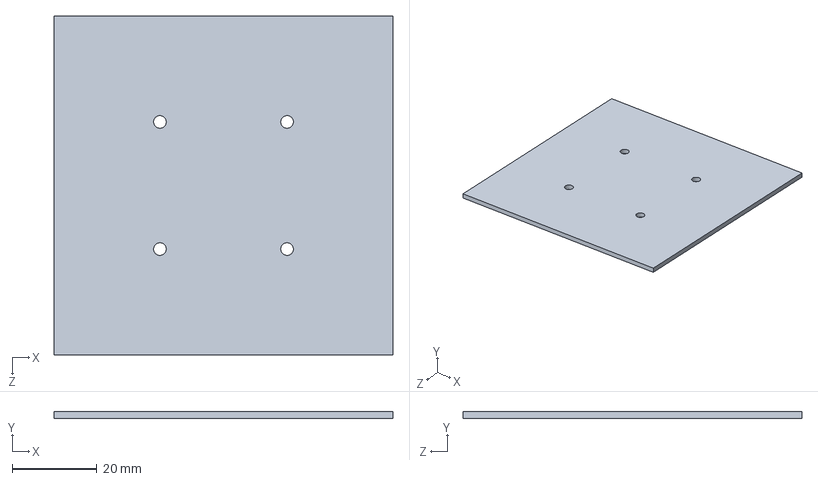
[picture p87: CAD file, 2016-11-03]
Mechanics/beacons/board_brx.SLDPRT
80.0 x 1.60 x 80.0 mm
