I-Grebot/Laser_Beacon_V3.0/Mechanics/turret/drum_head_motor.SLDPRT

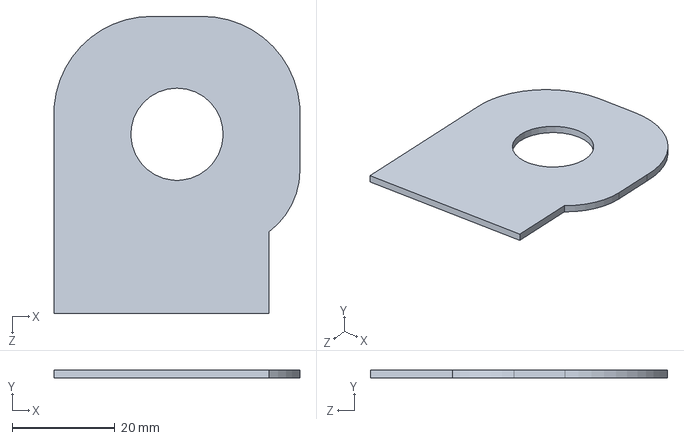
[picture p88: CAD file, 2016-11-03]
Mechanics/turret/drum_head_motor.SLDPRT
48.0 x 1.60 x 58.0 mm
