I-Grebot/Laser_Beacon_V3.0/Mechanics/common/spacer_M3x5.SLDPRT

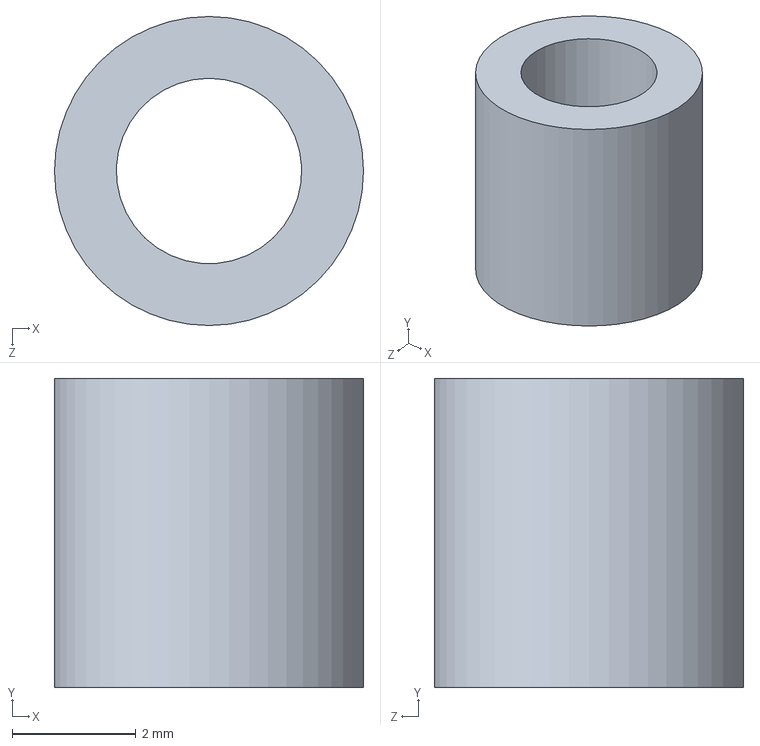
[picture p89: CAD file, 2016-11-03]
Mechanics/common/spacer_M3x5.SLDPRT
5.00 x 5.00 x 5.00 mm
