I-Grebot/Laser_Beacon_V3.0/Mechanics/common/spacer_M4x5.SLDPRT

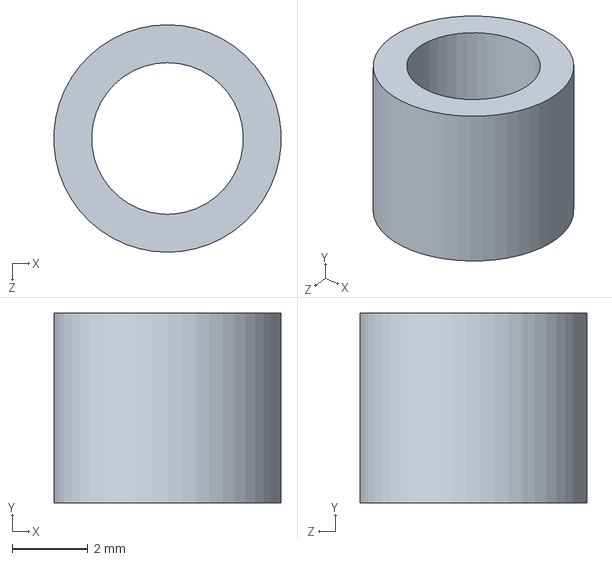
[picture p90: CAD file, 2016-11-03]
Mechanics/common/spacer_M4x5.SLDPRT
5.99 x 5.00 x 6.00 mm
