I-Grebot/Laser_Beacon_V3.0/Mechanics/turret/turret_holder.SLDPRT

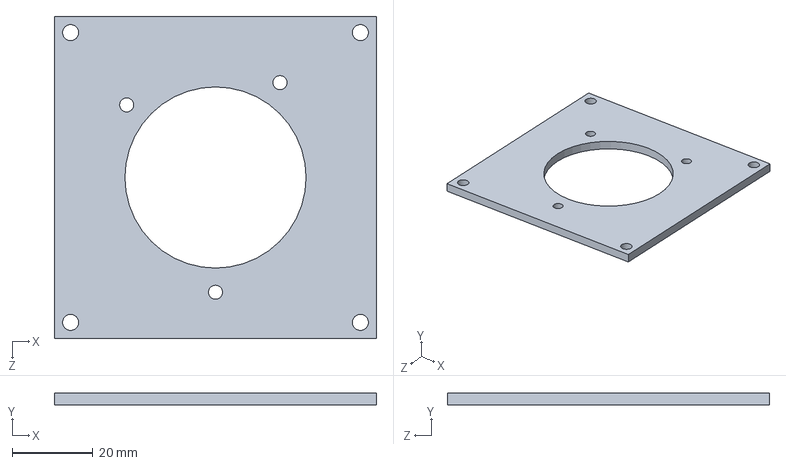
[picture p91: CAD file, 2016-11-03]
Mechanics/turret/turret_holder.SLDPRT
80.0 x 3.00 x 80.0 mm
