I-Grebot/Laser_Beacon_V3.0/Mechanics/turret/drum_head_top.SLDPRT

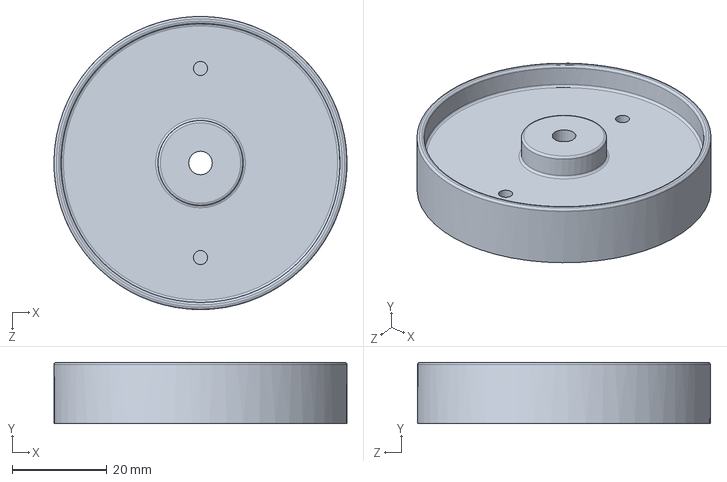
[picture p92: CAD file, 2016-11-03]
Mechanics/turret/drum_head_top.SLDPRT
62.0 x 13.0 x 62.0 mm
