I-Grebot/Laser_Beacon_V3.0/Mechanics/turret/turret_laser_12x32_holder.SLDPRT

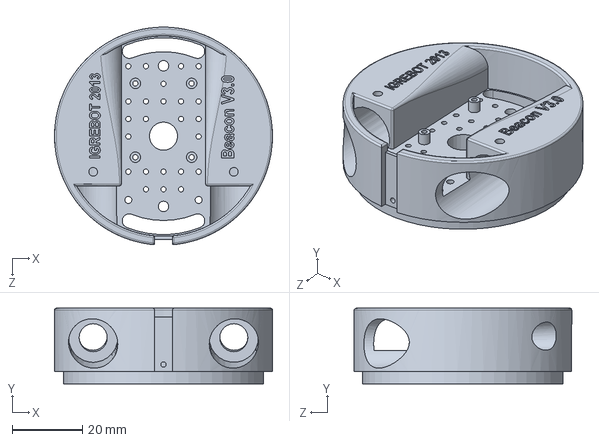
[picture p93: CAD file, 2016-11-03]
Mechanics/turret/turret_laser_12x32_holder.SLDPRT
62.0 x 21.5 x 61.9 mm
