I-Grebot/Laser_Beacon_V3.0/Mechanics/common/spacer_M4x10.SLDPRT

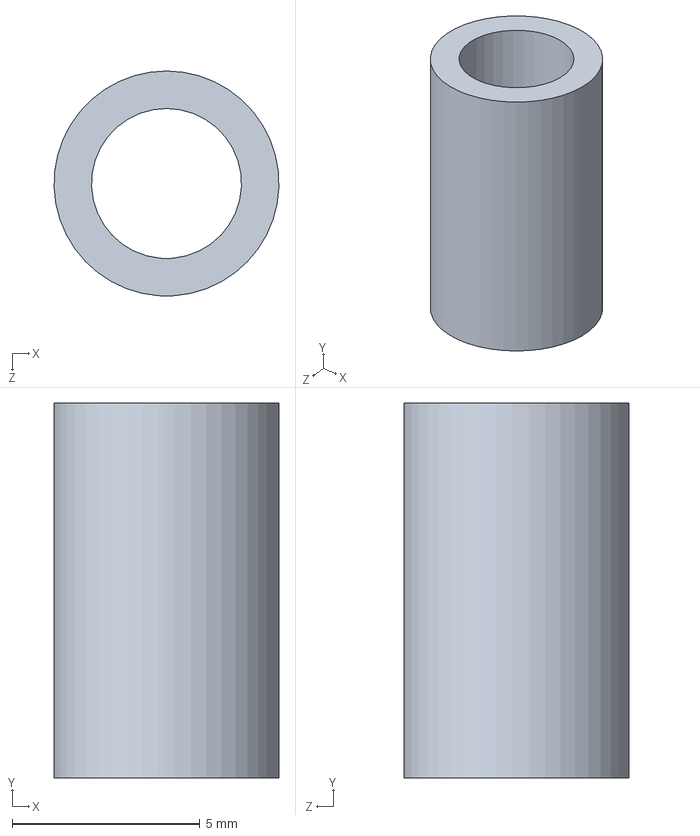
[picture p94: CAD file, 2016-11-03]
Mechanics/common/spacer_M4x10.SLDPRT
6.00 x 10.0 x 6.00 mm
