I-Grebot/Laser_Beacon_V3.0/(list of files, cad)

Other CAD files:
Theory/setup_drawings.SLDPRT
Mechanics/beacons/beacon_stair_2.SLDPRT
Mechanics/turret/turret_top.SLDPRT
Mechanics/beacons/beacon_stair_1.SLDPRT
Mechanics/turret/board_btx.SLDPRT
Mechanics/common/nut_M3.SLDPRT
Mechanics/common/screw_M3x10.SLDPRT
Mechanics/common/screw_M3x15.SLDPRT
Mechanics/common/screw_M4x10.SLDPRT
Mechanics/common/screw_M4x15.SLDPRT
Mechanics/common/screw_M4x25.SLDPRT
Mechanics/common/spacer_screw_M3x25.SLDPRT
Mechanics/common/spacer_screw_M3x40.SLDPRT
Mechanics/common/spacer_screw_M4x15.SLDPRT
Mechanics/common/spacer_screw_M4x20.SLDPRT
Mechanics/common/spacer_screw_M4x30.SLDPRT
Mechanics/common/spacer_screw_M4x40.SLDPRT
Mechanics/common/spacer_screw_M4x45.SLDASM
Mechanics/common/spacer_screw_M4x50.SLDPRT
Mechanics/turret/turret_laser_12x32_holder.STL
