I-Grebot/Laser_Beacon_V3.0/Images/Meca/BeaconV3_meca_setup_0.PNG

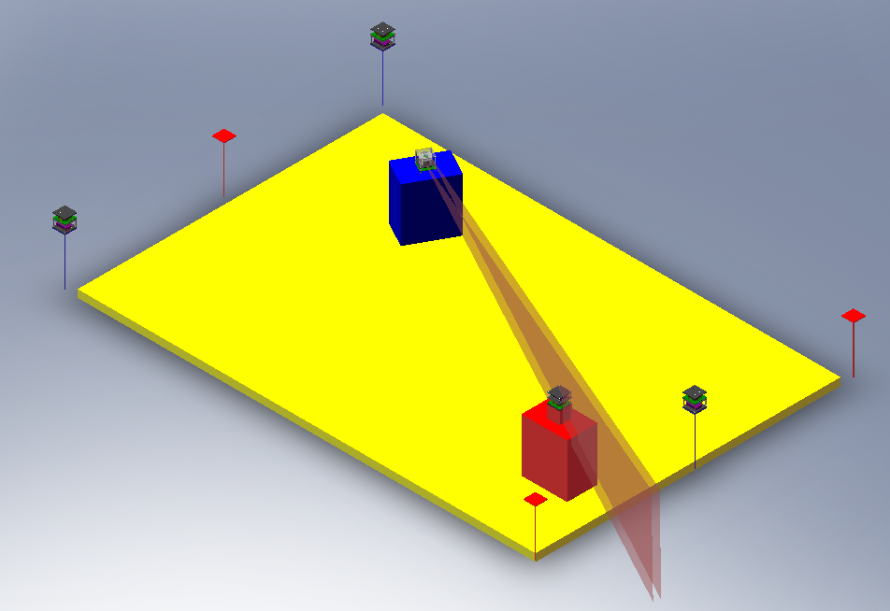
Images/Meca/BeaconV3_meca_setup_0.PNG
