I-Grebot/Laser_Beacon_V3.0/Images/Meca/BeaconV3_meca_setup_2.PNG

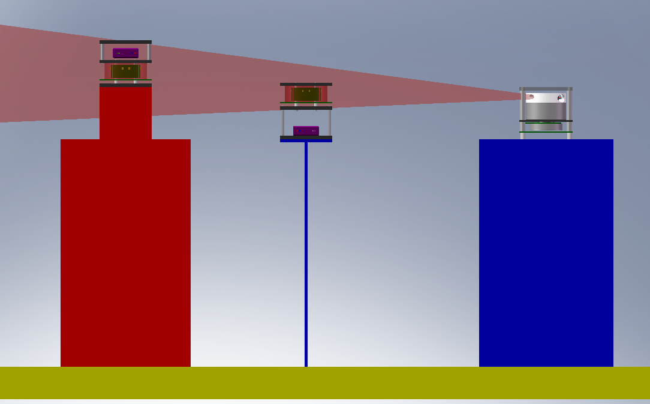
Images/Meca/BeaconV3_meca_setup_2.PNG
