I-Grebot/Laser_Beacon_V3.0/Images/Meca/BeaconV3_meca_setup_5.PNG

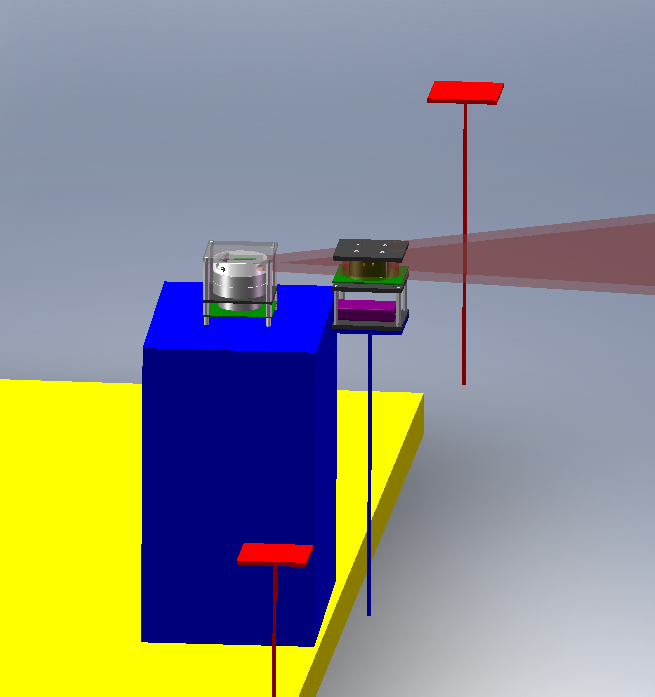
Images/Meca/BeaconV3_meca_setup_5.PNG
