I-Grebot/Laser_Beacon_V3.0/Images/PDD_simu/final_simu1_result1.PNG

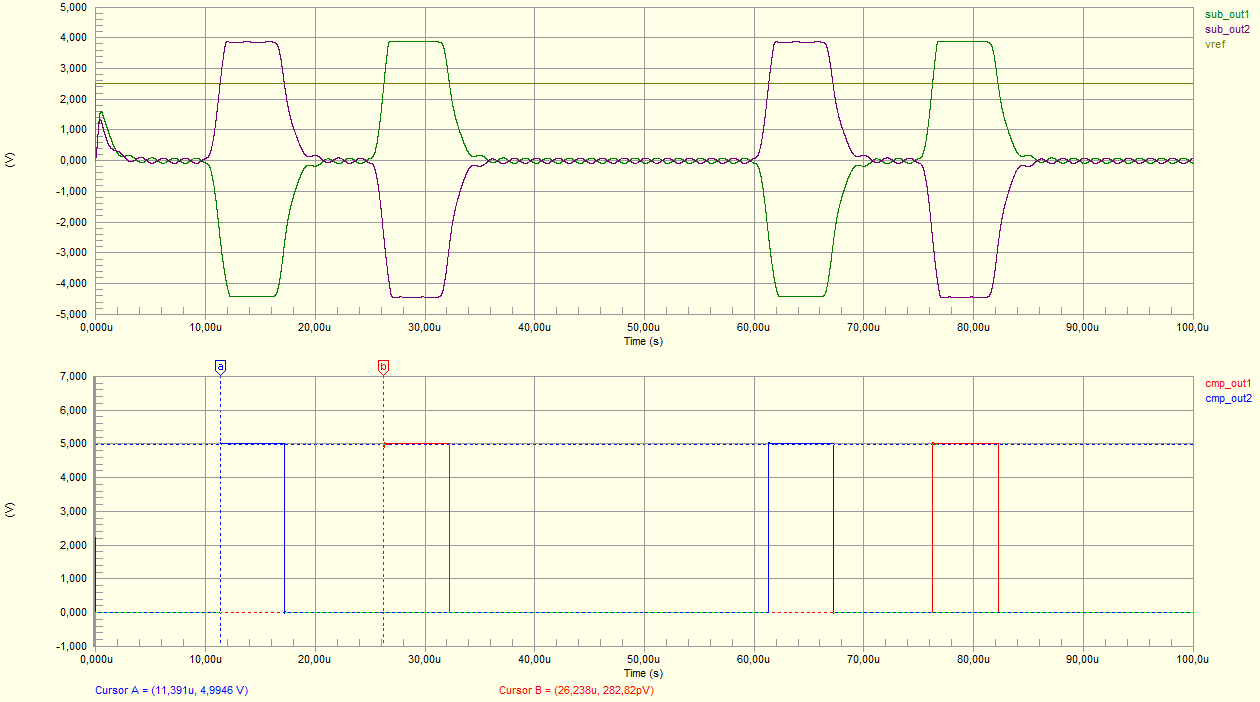
Images/PDD_simu/final_simu1_result1.PNG
