I-Grebot/Laser_Beacon_V3.0/Images/PDD_simu/ti_simu1_result1.PNG

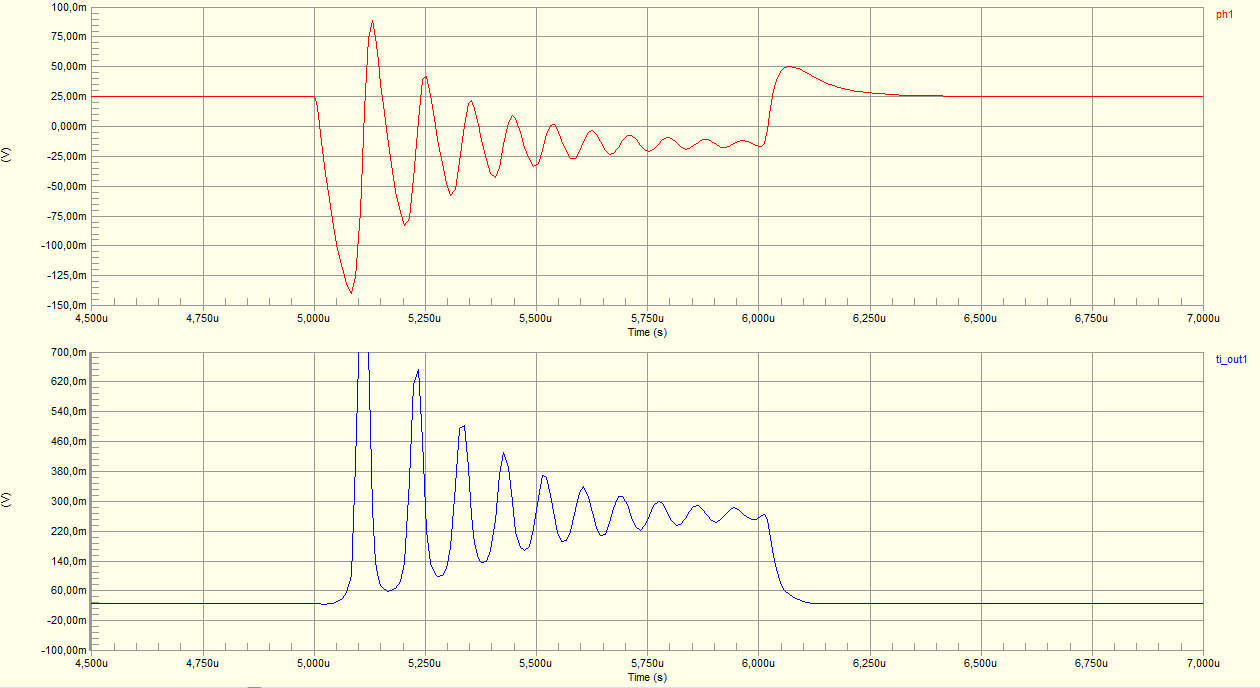
Images/PDD_simu/ti_simu1_result1.PNG
