I-Grebot/Laser_Beacon_V3.0/Electronics/BRX/BRX_v1.0/PDF/BRX_layout_top.pdf

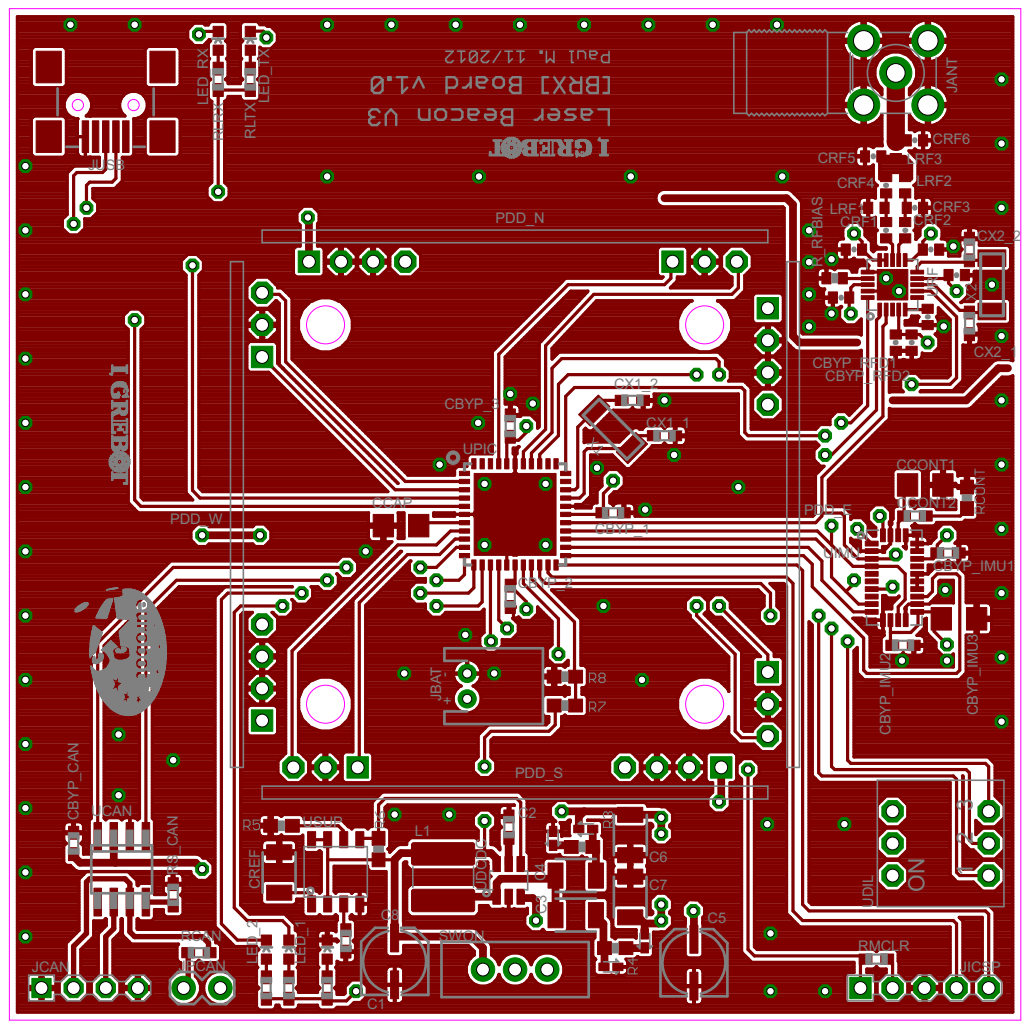
[picture p111: page 1]

+ - 1 2 3 ON UPIC UCAN RS_CAN CX1_1 CX1_2 LED_TX LED_RX RLTX CBYP_1 CBYP_2 CBYP_3 CCAP CBYP_CAN RLRX LED_1 JUSB RMCLR LED_2 URF CX2_1 CX2_2 R_RFBIAS CRF1 LRF1 CRF2CRF3 CRF4 LRF2 CRF5 LRF3CRF6 CBYP_RFD1 CBYP_RFD2 JANT JCAN JPCAN RCAN JICSP PDD_N PDD_W PDD_E PDD_S UDCDC L1 C1 C2 C3 C4C6C7 JBAT SWON USUP C8 UIMU CCONT1 CBYP_IMU1 CBYP_IMU2 C5 CBYP_IMU3 CREF CCONT2 UDIL
