I-Grebot/Laser_Beacon_V3.0/Electronics/BRX/BRX_v1.0/PDF/BRX_schematic.pdf

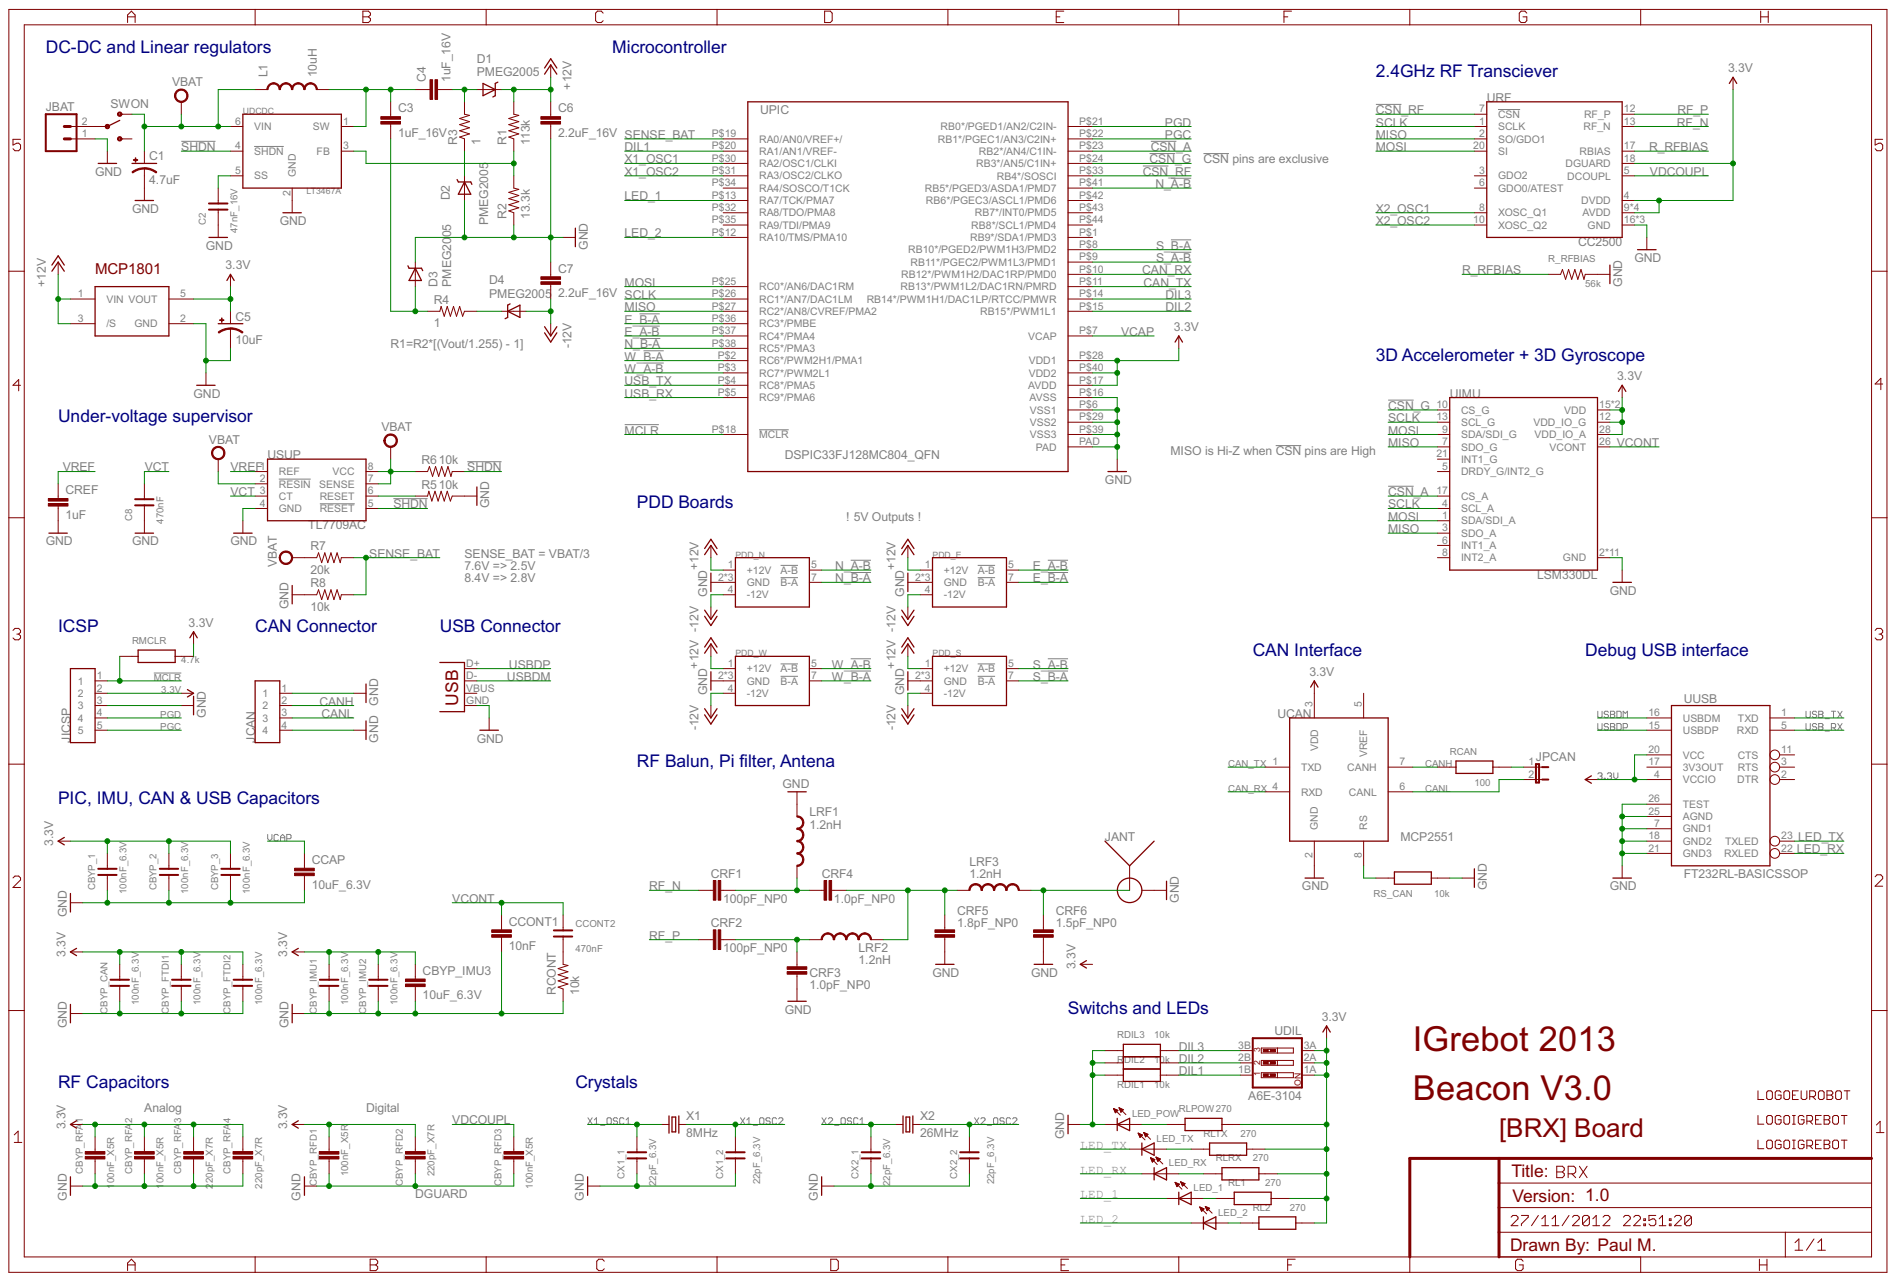
[picture p112: page 1]

DC-DC and Linear regulators

CSN pins are exclusive

3 CAN Interface Debug USB interface

RF Balun, Pi filter, Antena

PIC, IMU, CAN & USB Capacitors

Drawn By: Title: Version:
