I-Grebot/Laser_Beacon_V3.0/Electronics/BTX/BTX_v1.0/PDF/BTX_layout_top.pdf

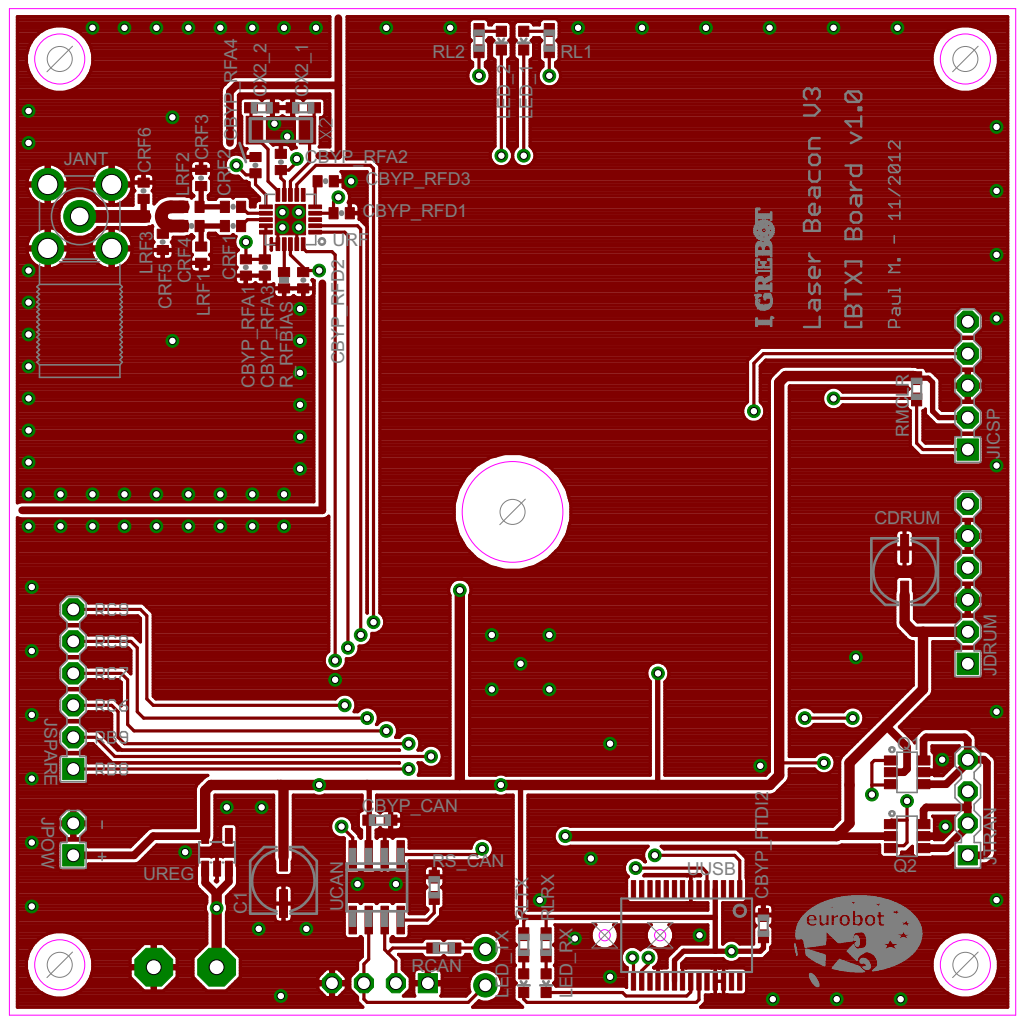
[picture p113: page 1]

UCANRS_CAN UUSB LED_TX LED_RX RLTX CBYP_CAN CBYP_FTDI2 RLRX RL1 LED_1 RMCLR UREG C1 JTRAN JDRUM RL2 LED_2 URF CX2_1 CX2_2 R_RFBIAS CBYP_RFD3 CBYP_RFA1 CBYP_RFA2 CBYP_RFA3 CBYP_RFA4 CRF1 LRF1 CRFC2RF3 LRF2 CRF4 CRFL5RF3 CRF6 CBYP_RFD1 CBYP_RFD2 JANT RCAN Q1 Q2 JSPARE JPOW CDRUM JICSP
