I-Grebot/Laser_Beacon_V3.0/Electronics/Panels/Panel2/PDF/Panel2_layout_top.pdf

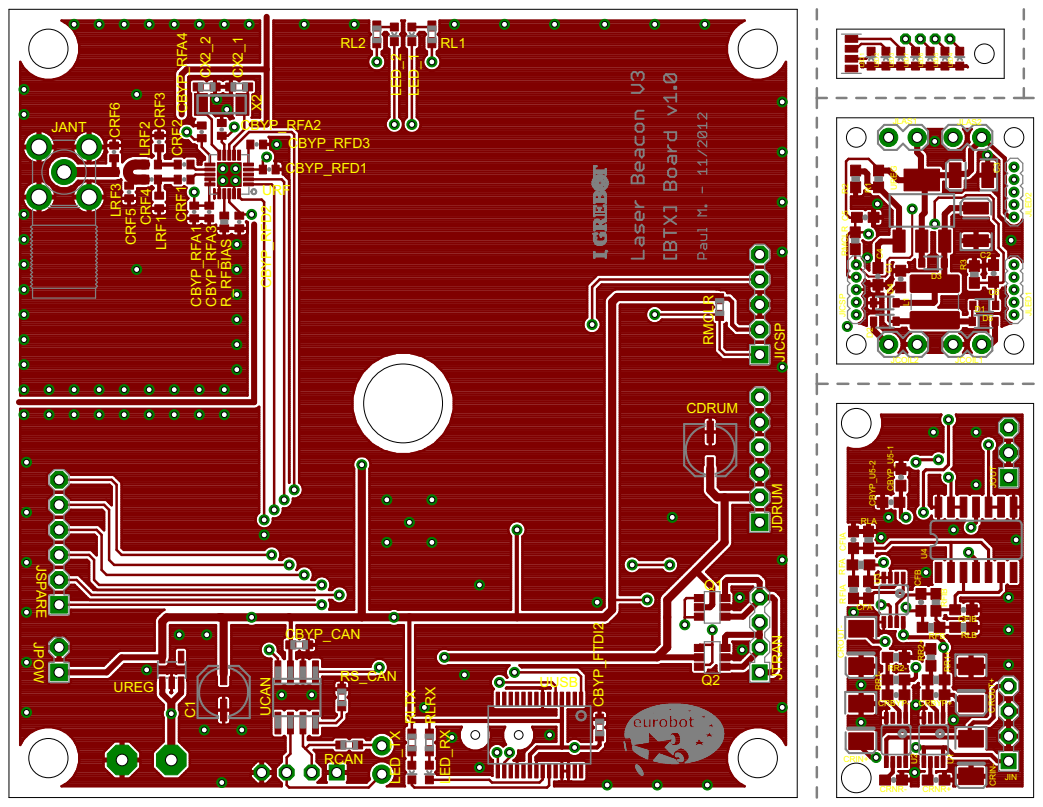
[picture p114: page 1]

C1 C2 C3 C4 C5 C6 D1 D2 D3 D4 D5 JCOIL2 JCOIL1 JICSP JLAS1 JLAS2 JLED1 JLED2 L1 LED1 LED2 LED3 LED4 LED5 LED6 LED7 R1 R2 R3 RMCLR UREG CBYP_U5-1 CBYP_U5-2 CFA CFB CFIA CFIB CRBYP- CRBYP+ CRIN+ CRIN- CRNR- CRNR+ CROUT+ CROUT- JIN JOUT RFA RFB RFIA RFIB RLA RLB RR1+ RR1- RR2+ RR2- U1U2 U3 U4 C1 CBYP_CAN CBYP_FTDI2 CBYP_RFA1 CBYP_RFA2 CBYP_RFA3 CBYP_RFA4 CBYP_RFD1 CBYP_RFD2 CBYP_RFD3 CDRUM CRF1 CRFC2RF3 CRF4 CRF5 CRF6 CX2_1 CX2_2 JANT JDRUM JICSP JPOW JSPARE JTRAN LED_1 LED_2 LED_RX LED_TX LRF1 LRF2 LRF3 Q1 Q2 RCAN RL2 RL1 RLRX RLTX RMCLR RS_CAN R_RFBIAS UCAUREG N URF UUSB X2
