I-Grebot/Laser_Beacon_V3.0/Electronics/TUD/TUD_v1.0/PDF/TUD_schematic.pdf

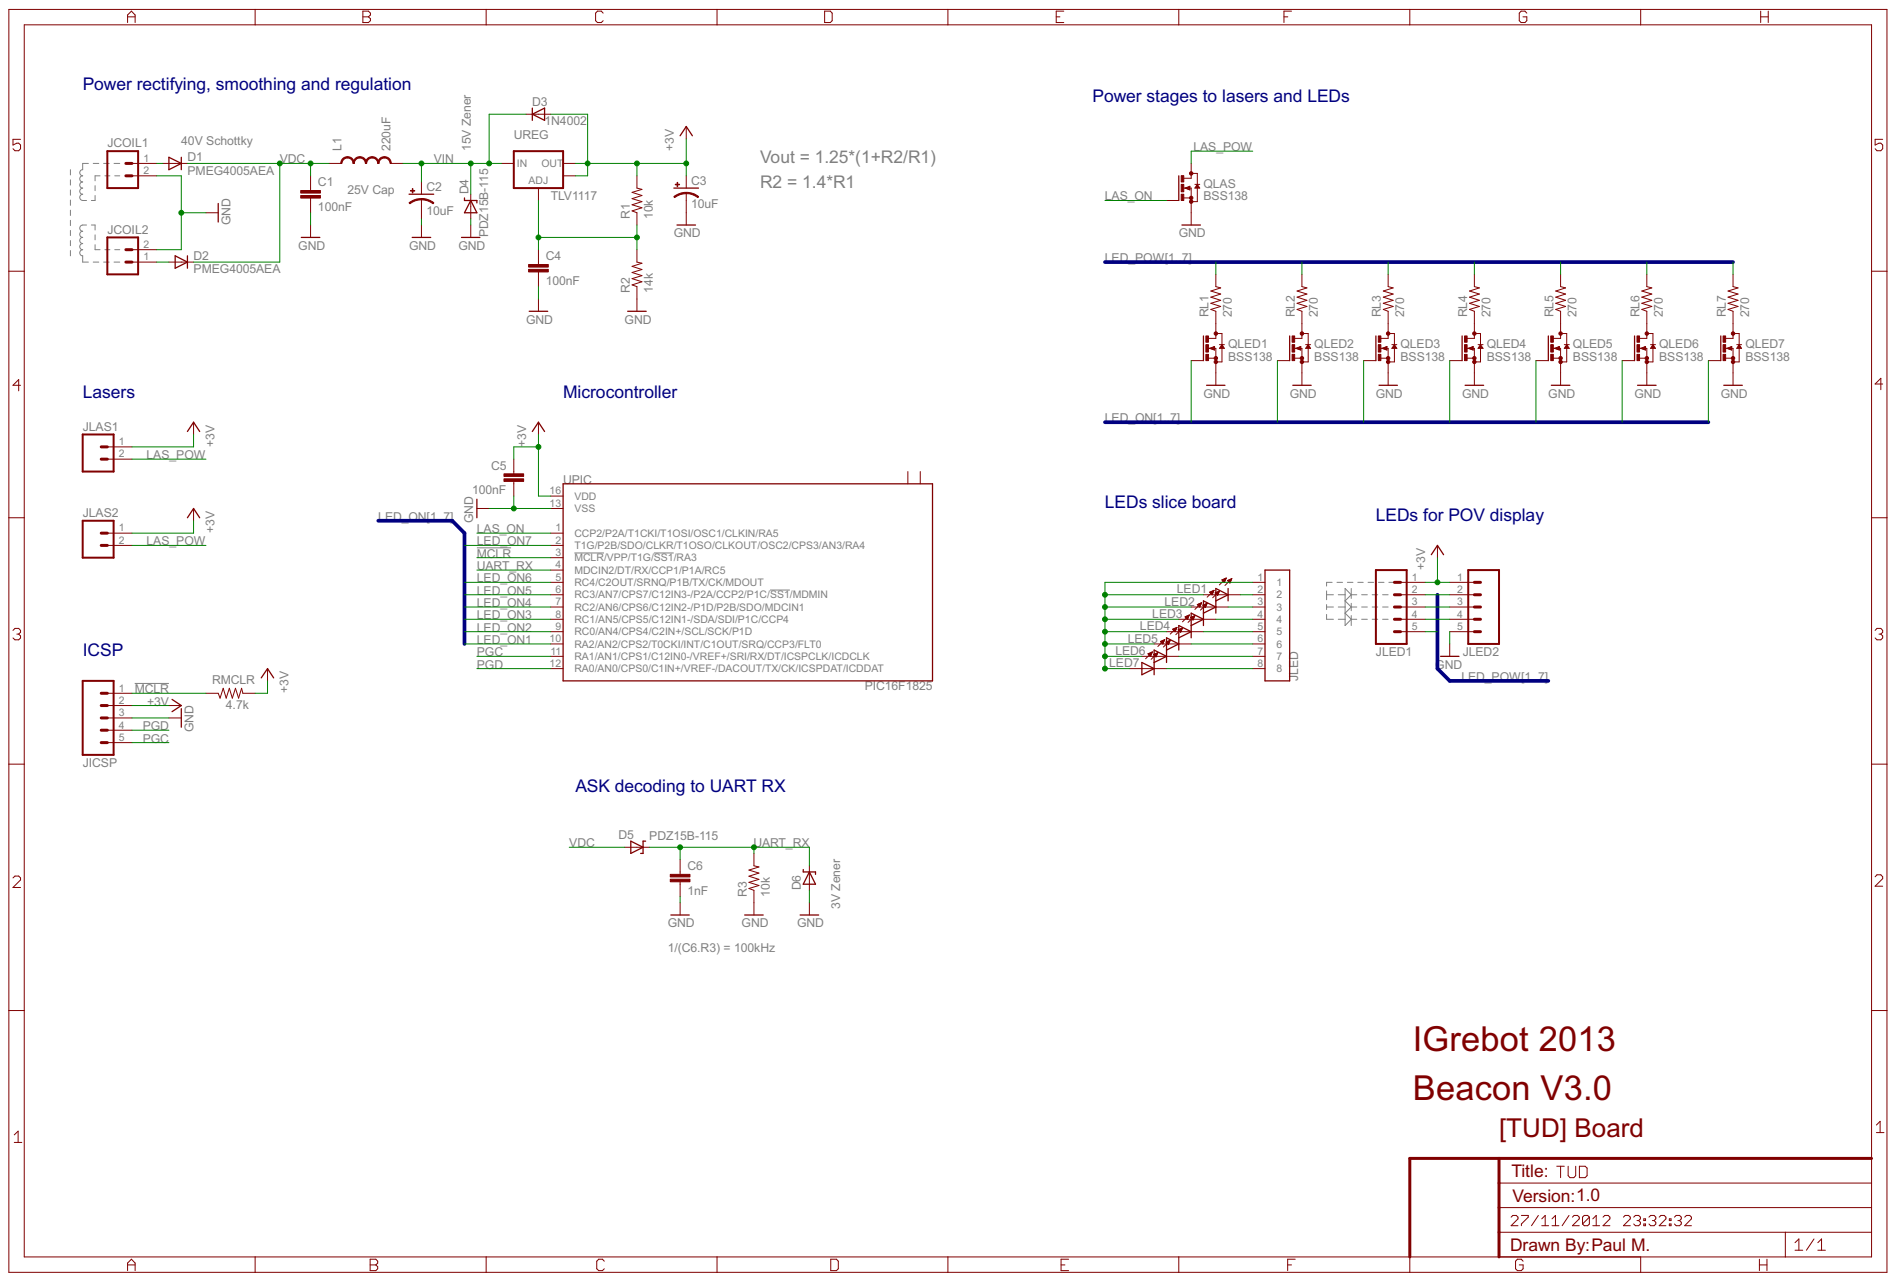
[picture p115: page 1]

LEDs for POV display

ASK decoding to UART RX

Drawn By: Title: Version:
