I-Grebot/Laser_Beacon_V3.0/Electronics/PDD/Releases/PDD_v1.0/PDF/PDD_schematic.pdf

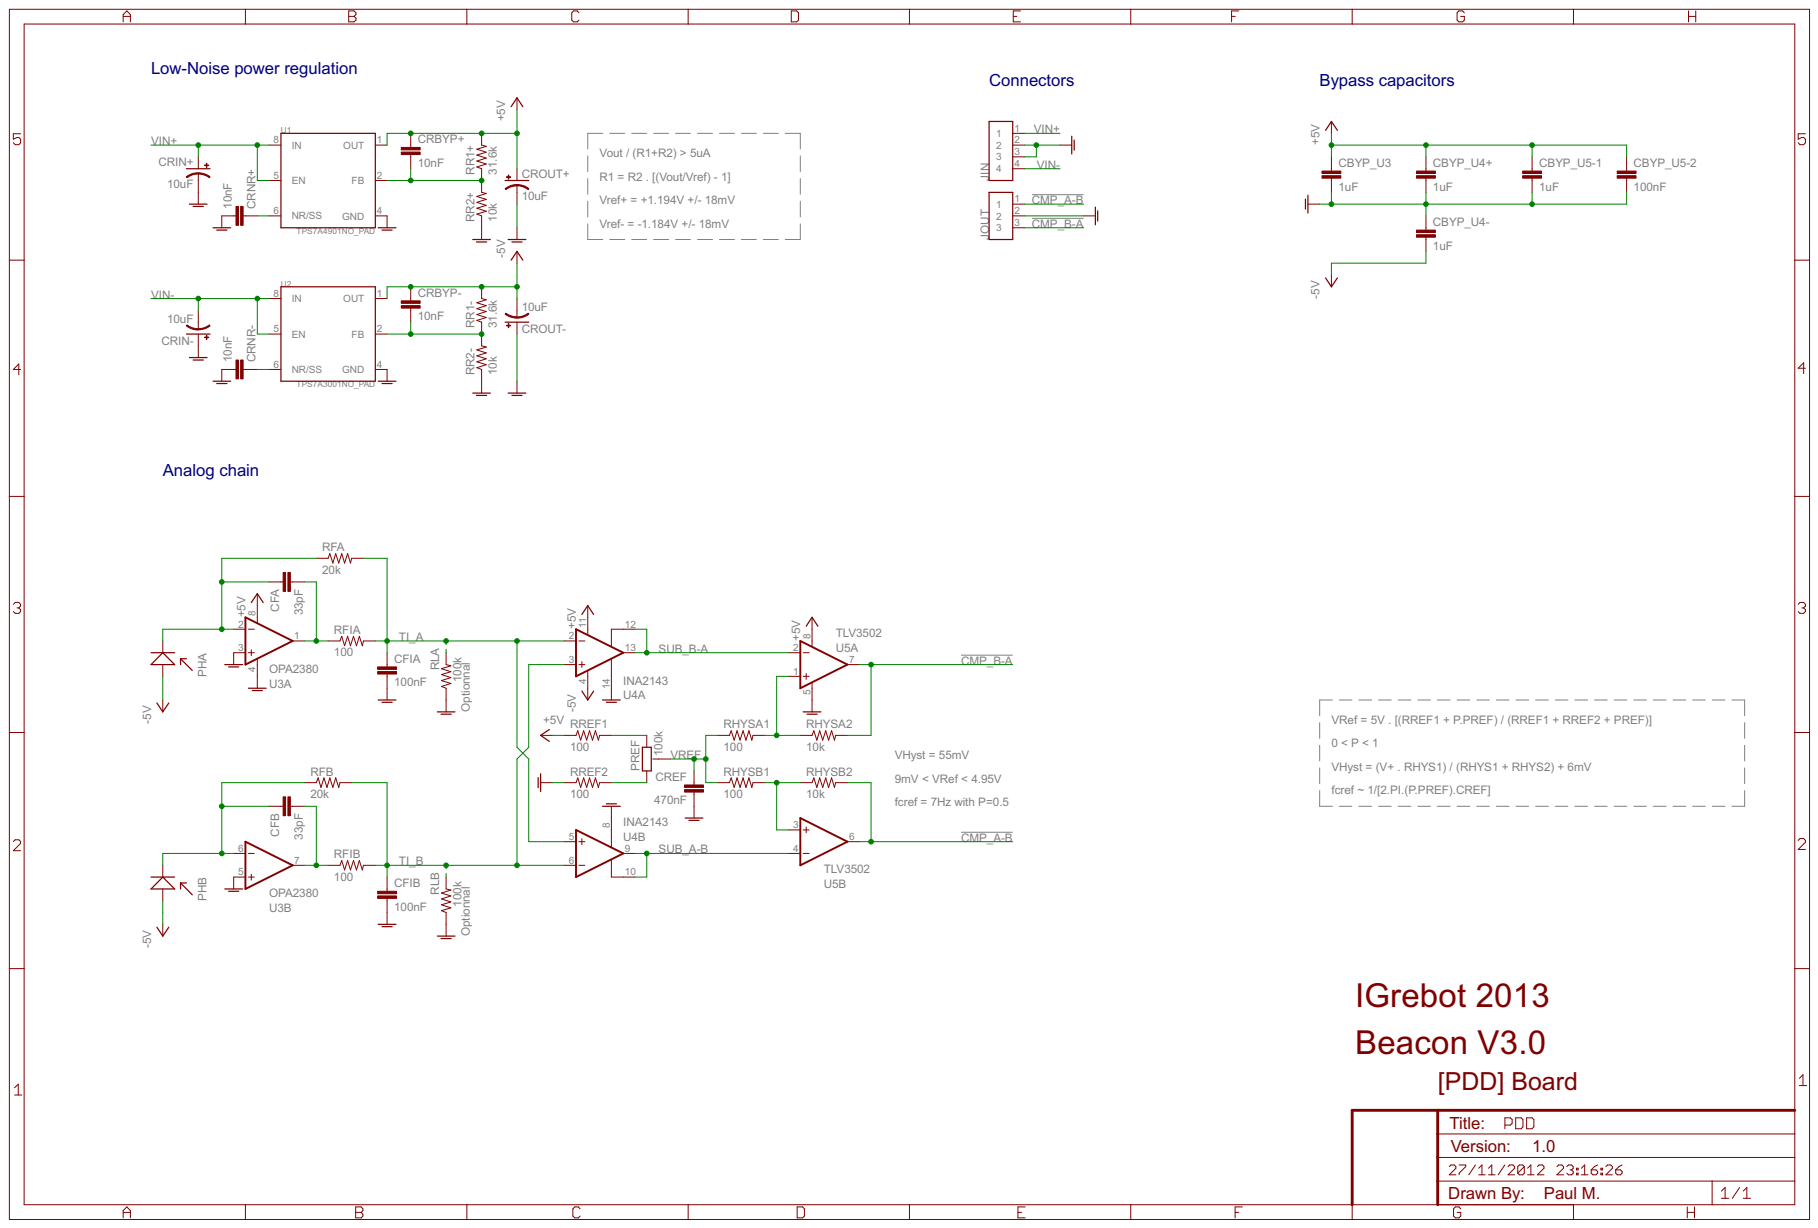
[picture p116: page 1]

Low-Noise power regulation

Vout / (R1+R2) > 5uA R1 = R2 . [(Vout/Vref) - 1] Vref+ = +1.194V +/- 18mV

VRef = 5V . [(RREF1 + P.PREF) / (RREF1 + RREF2 + PREF)] 0 < P < 1 VHyst = 55mV

fcref ~ 1/[2.PI.(P.PREF).CREF]

Drawn By: Title: Version:
