I-Grebot/Laser_Beacon_V3.0/Electronics/BRX/BRX_v1.0/PDF/BRX_layout_bot.pdf

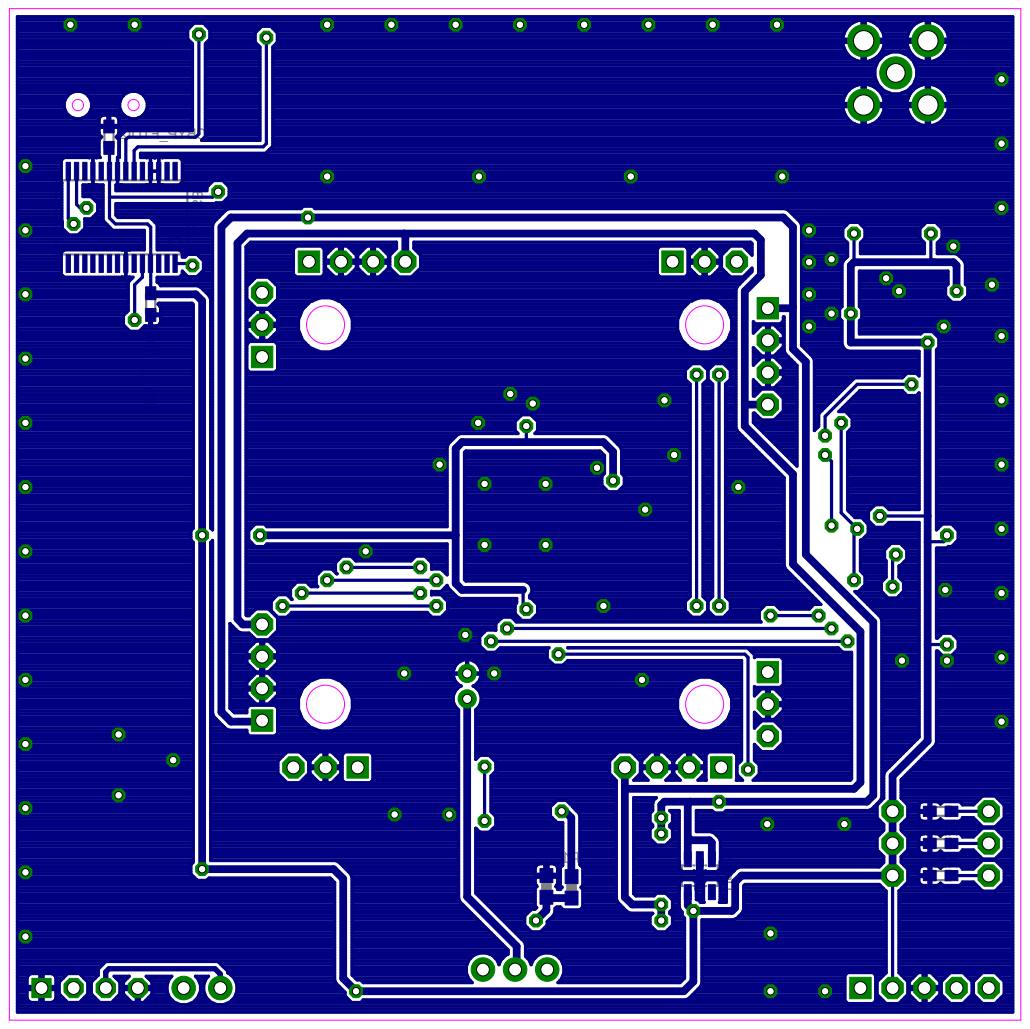
[picture p117: page 1]

UUSB CBYP_FTDI1 2I DTF_PYBC UREG 3LI DR 2LI DR 1LI DR
