I-Grebot/Laser_Beacon_V3.0/Electronics/BTX/BTX_v1.0/PDF/BTX_layout_bot.pdf

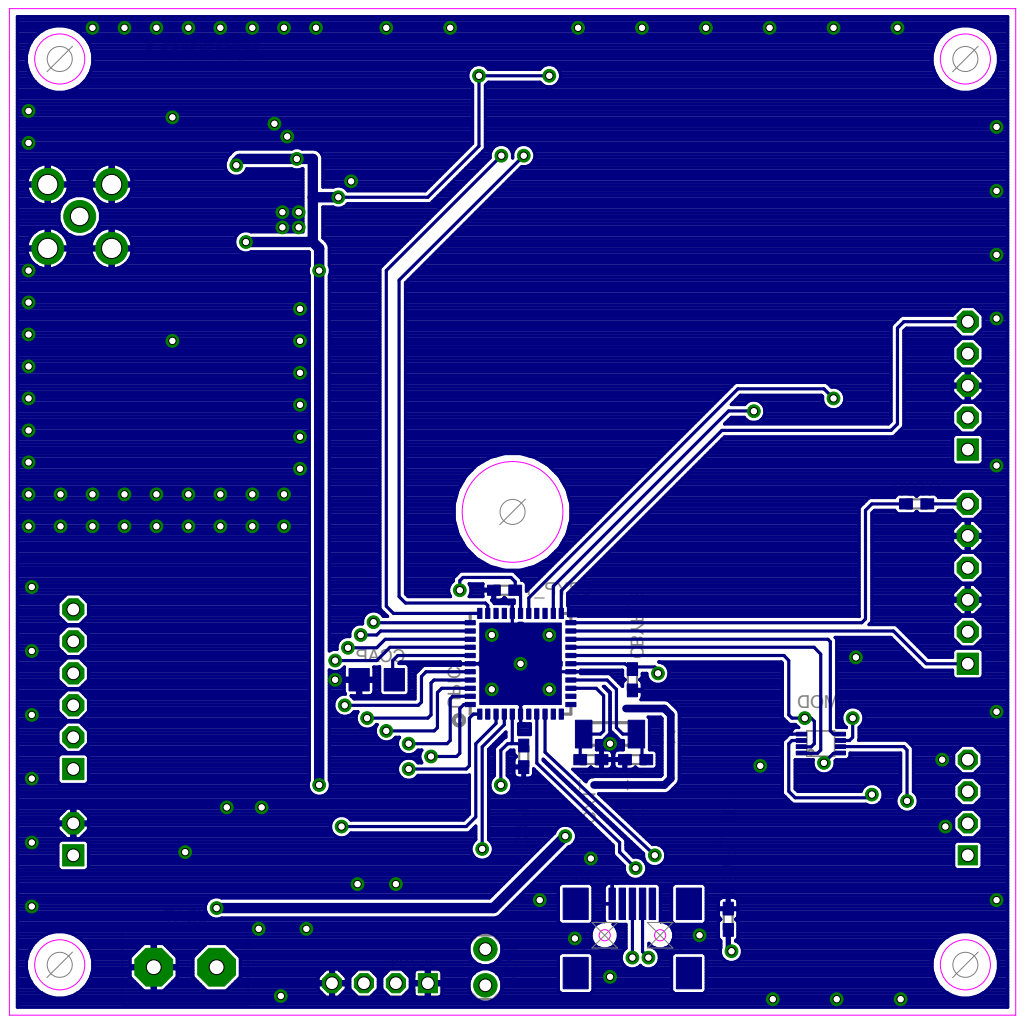
[picture p118: page 1]

UPIC CX1_1 CX1_2 1_PYBC CBYP_2 CBYP_3 PACC CBYP_FTDI1 BSUJ TABJ POTR DOMU NACJ JPCAN
