I-Grebot/Laser_Beacon_V3.0/Electronics/BTX/BTX_v1.0/PDF/BTX_schematic.pdf

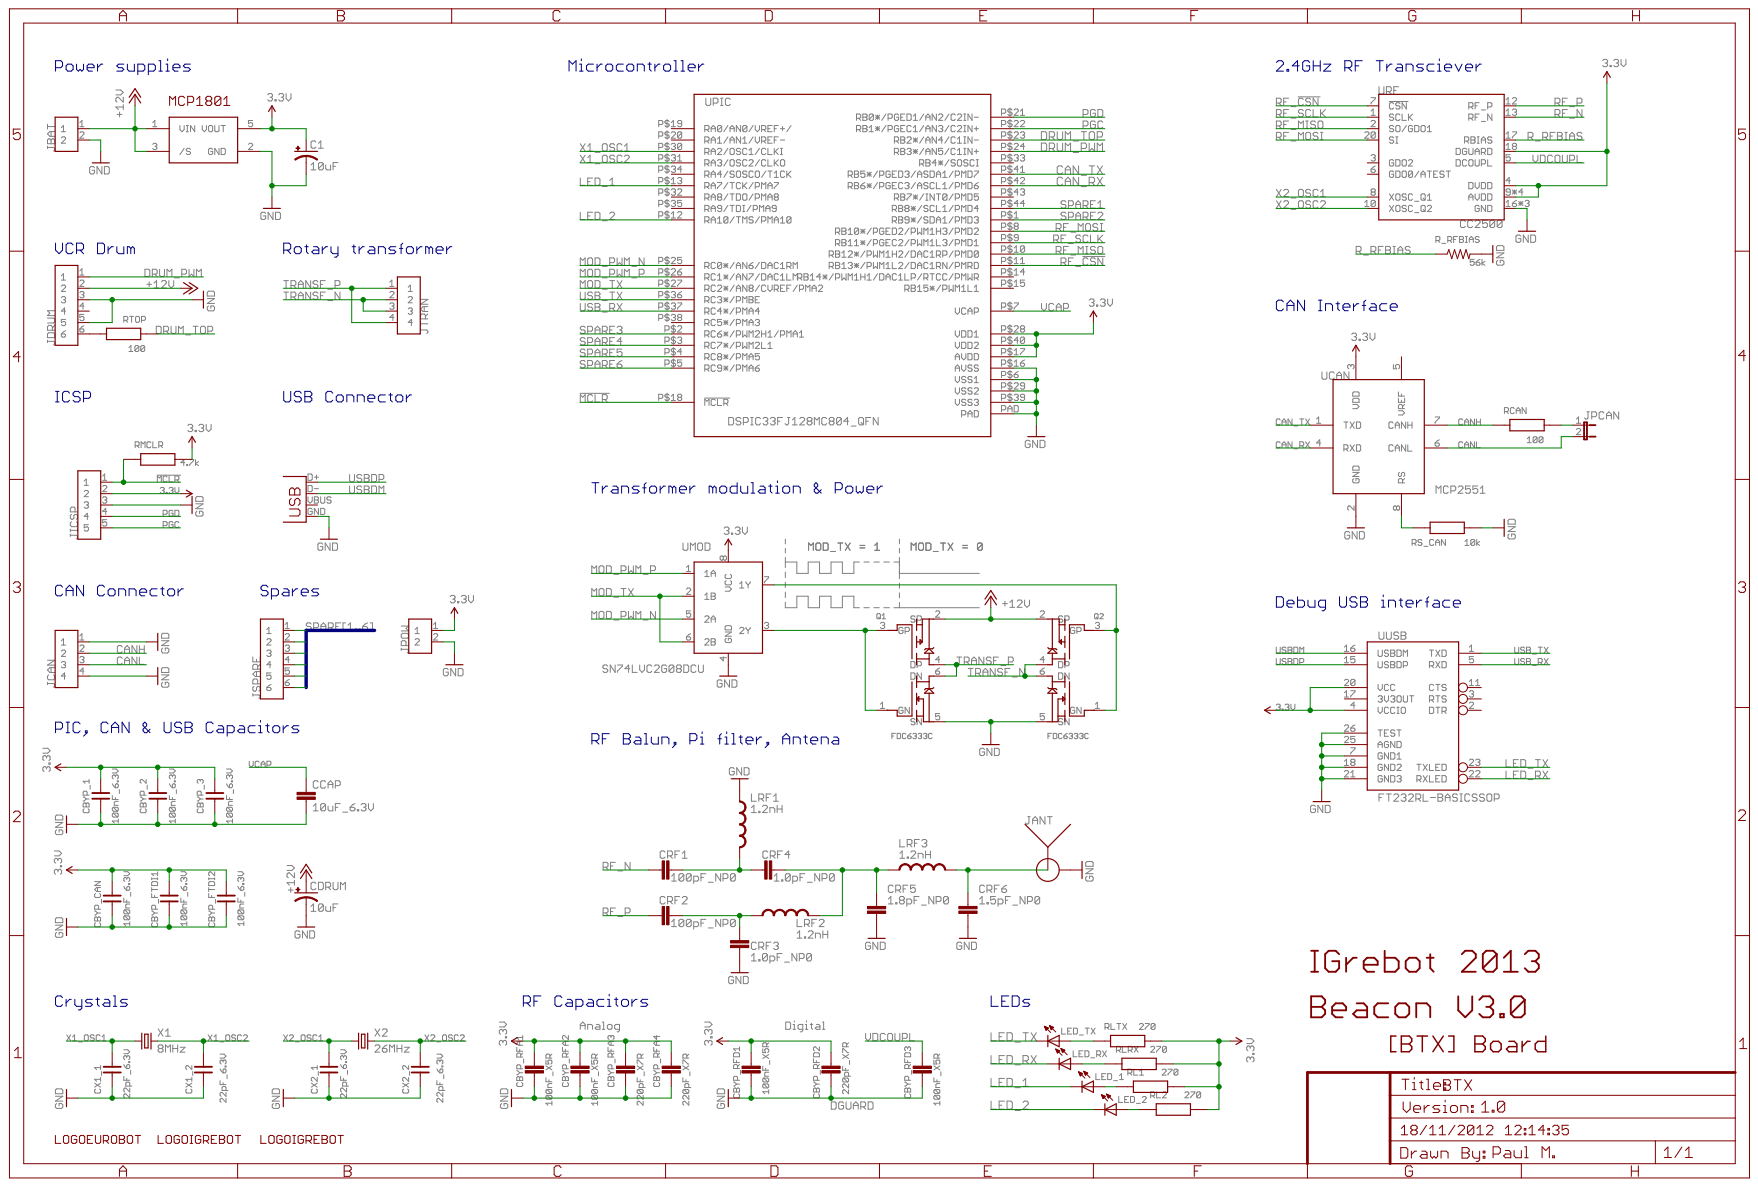
[picture p119: page 1]
