I-Grebot/Laser_Beacon_V3.0/Electronics/Panels/Panel1/PDF/Panel1_layout_bot.pdf

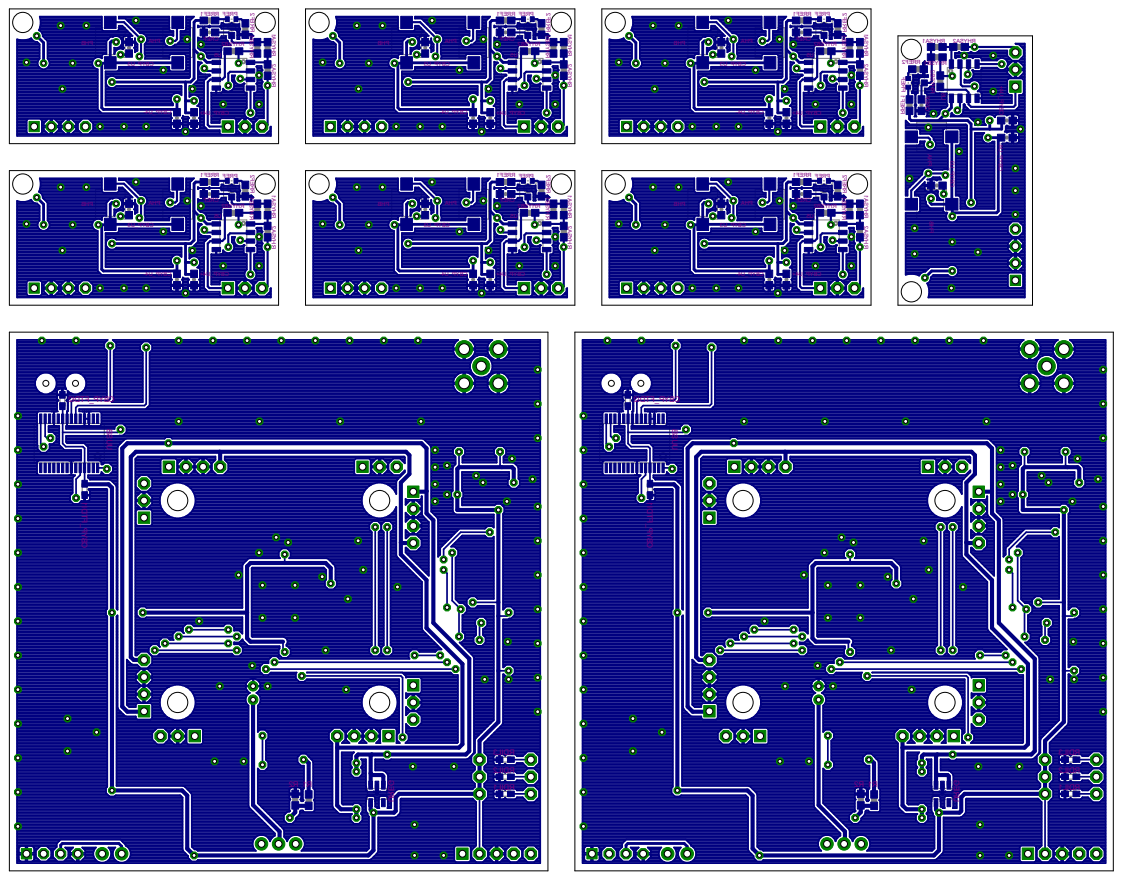
[picture p120: page 1]
