I-Grebot/Laser_Beacon_V3.0/Electronics/Panels/Panel1/PDF/Panel1_layout_top.pdf

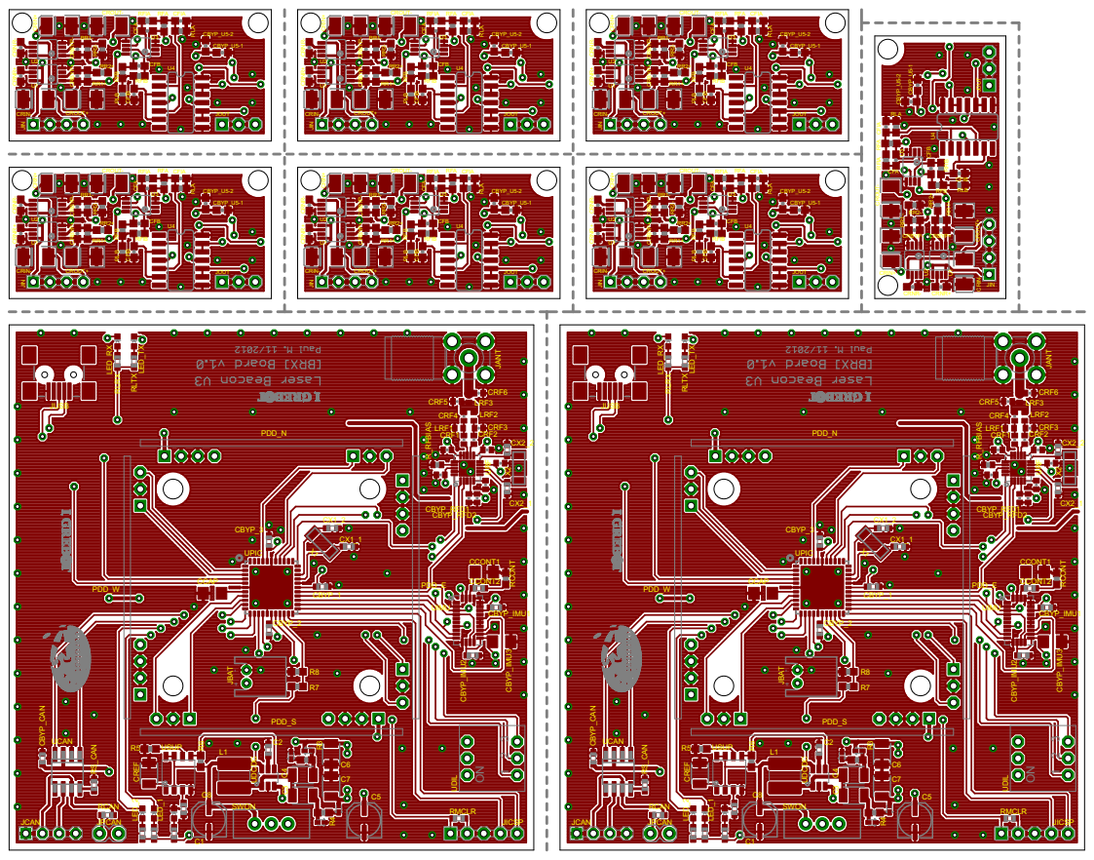
[picture p121: page 1]

CRIN+ CRIN- CRNR+ CRNR- CROUT+

JCAN | JPCAN | JICSP
