I-Grebot/Laser_Beacon_V3.0/Electronics/Panels/Panel2/PDF/Panel2_layout_bot.pdf

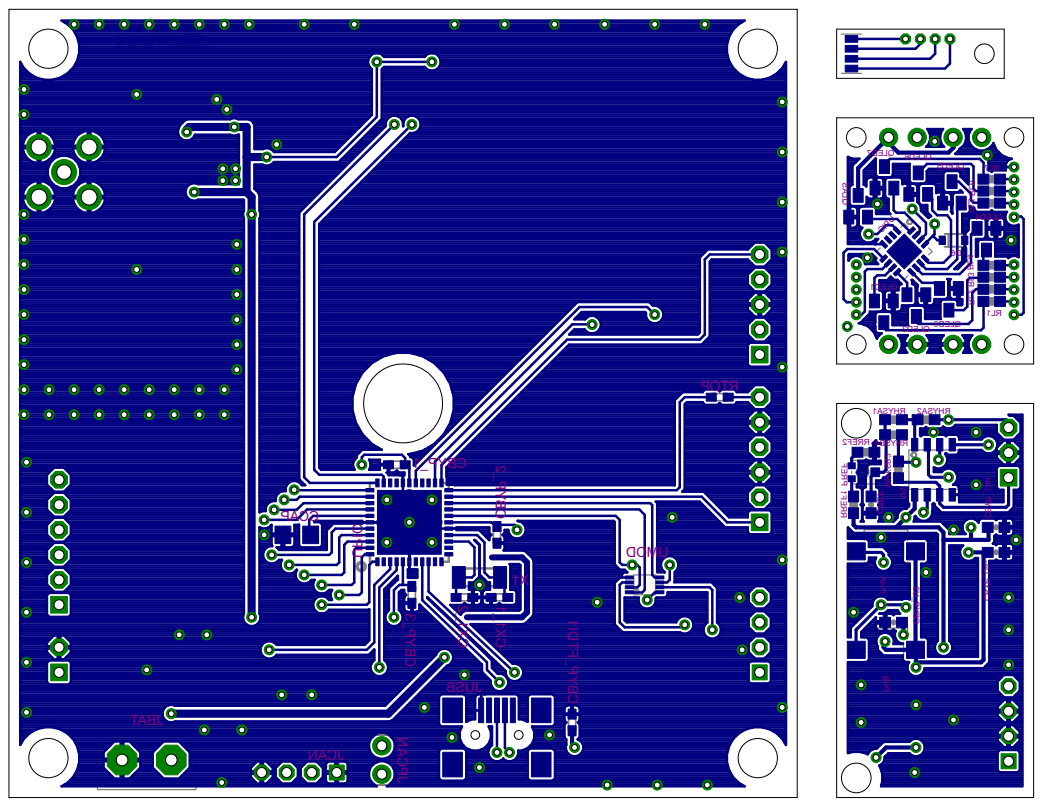
[picture p122: page 1]

6D QLAS 1DEL Q 2DEL Q 3DEL Q 4DEL Q 5DEL Q 6DEL Q 7DEL Q 1LR RL2 RL3 RL4 RL5 RL6 7LR UP CI CBYP_U3 CBYP_U4+ CBYP_U4- CREF PHA PHB PREF 1ASYHR 2ASYHR 1BSYHR RHYSB2 RREF1 2FERR U5 1_PYBC CBYP_2 CBYP_3 CBYP_FTDI1 PACC CX1_1 CX1_2 TABJ NACJ JPCAN BSUJ POTR UDOMU PIC 1X
