I-Grebot/Laser_Beacon_V3.0/Electronics/PDD/Prototype/PDF/Rolab_PDD_proto_v1.0_pcb_bot_place.pdf

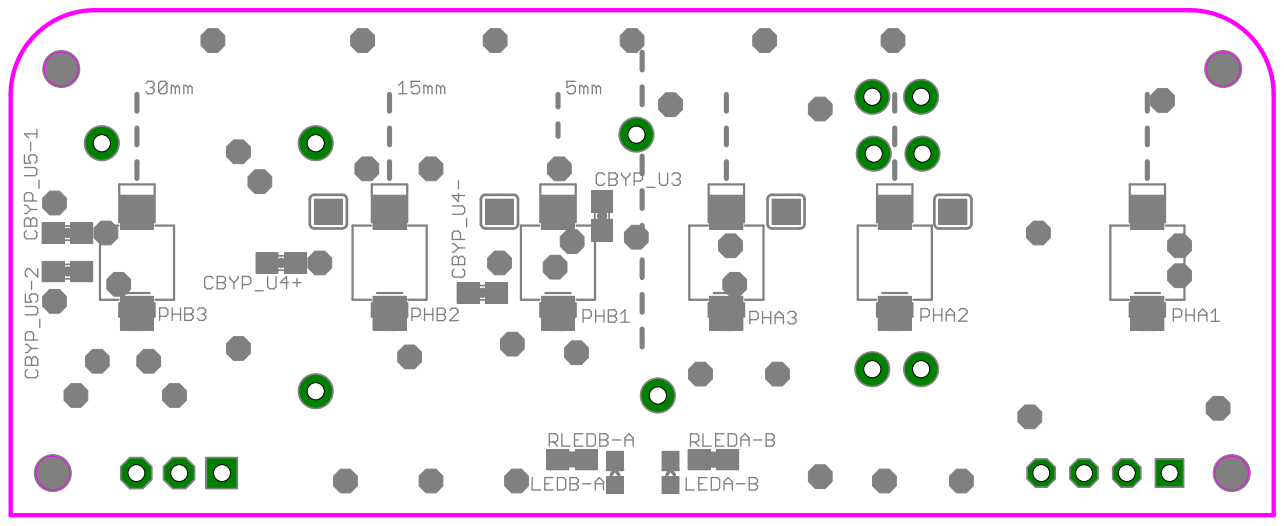
[picture p124: page 1]
