I-Grebot/Laser_Beacon_V3.0/Electronics/PDD/Prototype/PDF/Rolab_PDD_proto_v1.0_pcb_top_copper.pdf

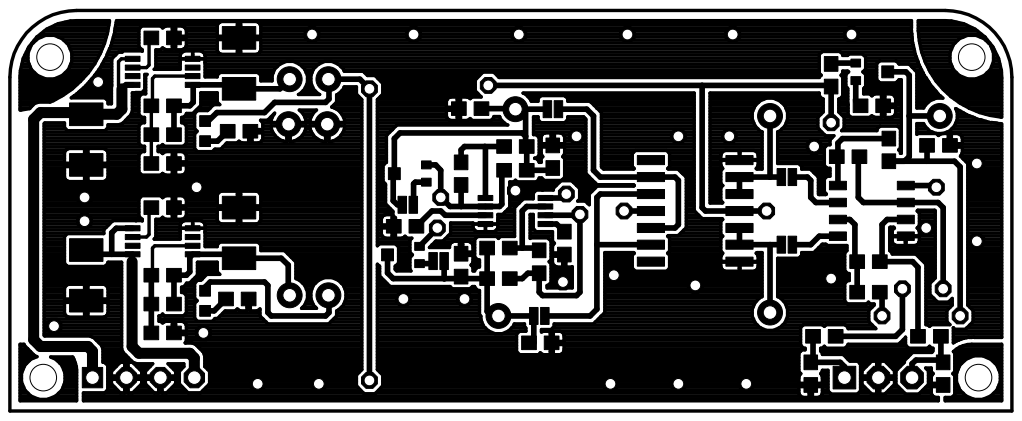
[picture p125: page 1]
