I-Grebot/Laser_Beacon_V3.0/Electronics/PDD/Prototype/PDF/Rolab_PDD_proto_v1.0_schematic.pdf

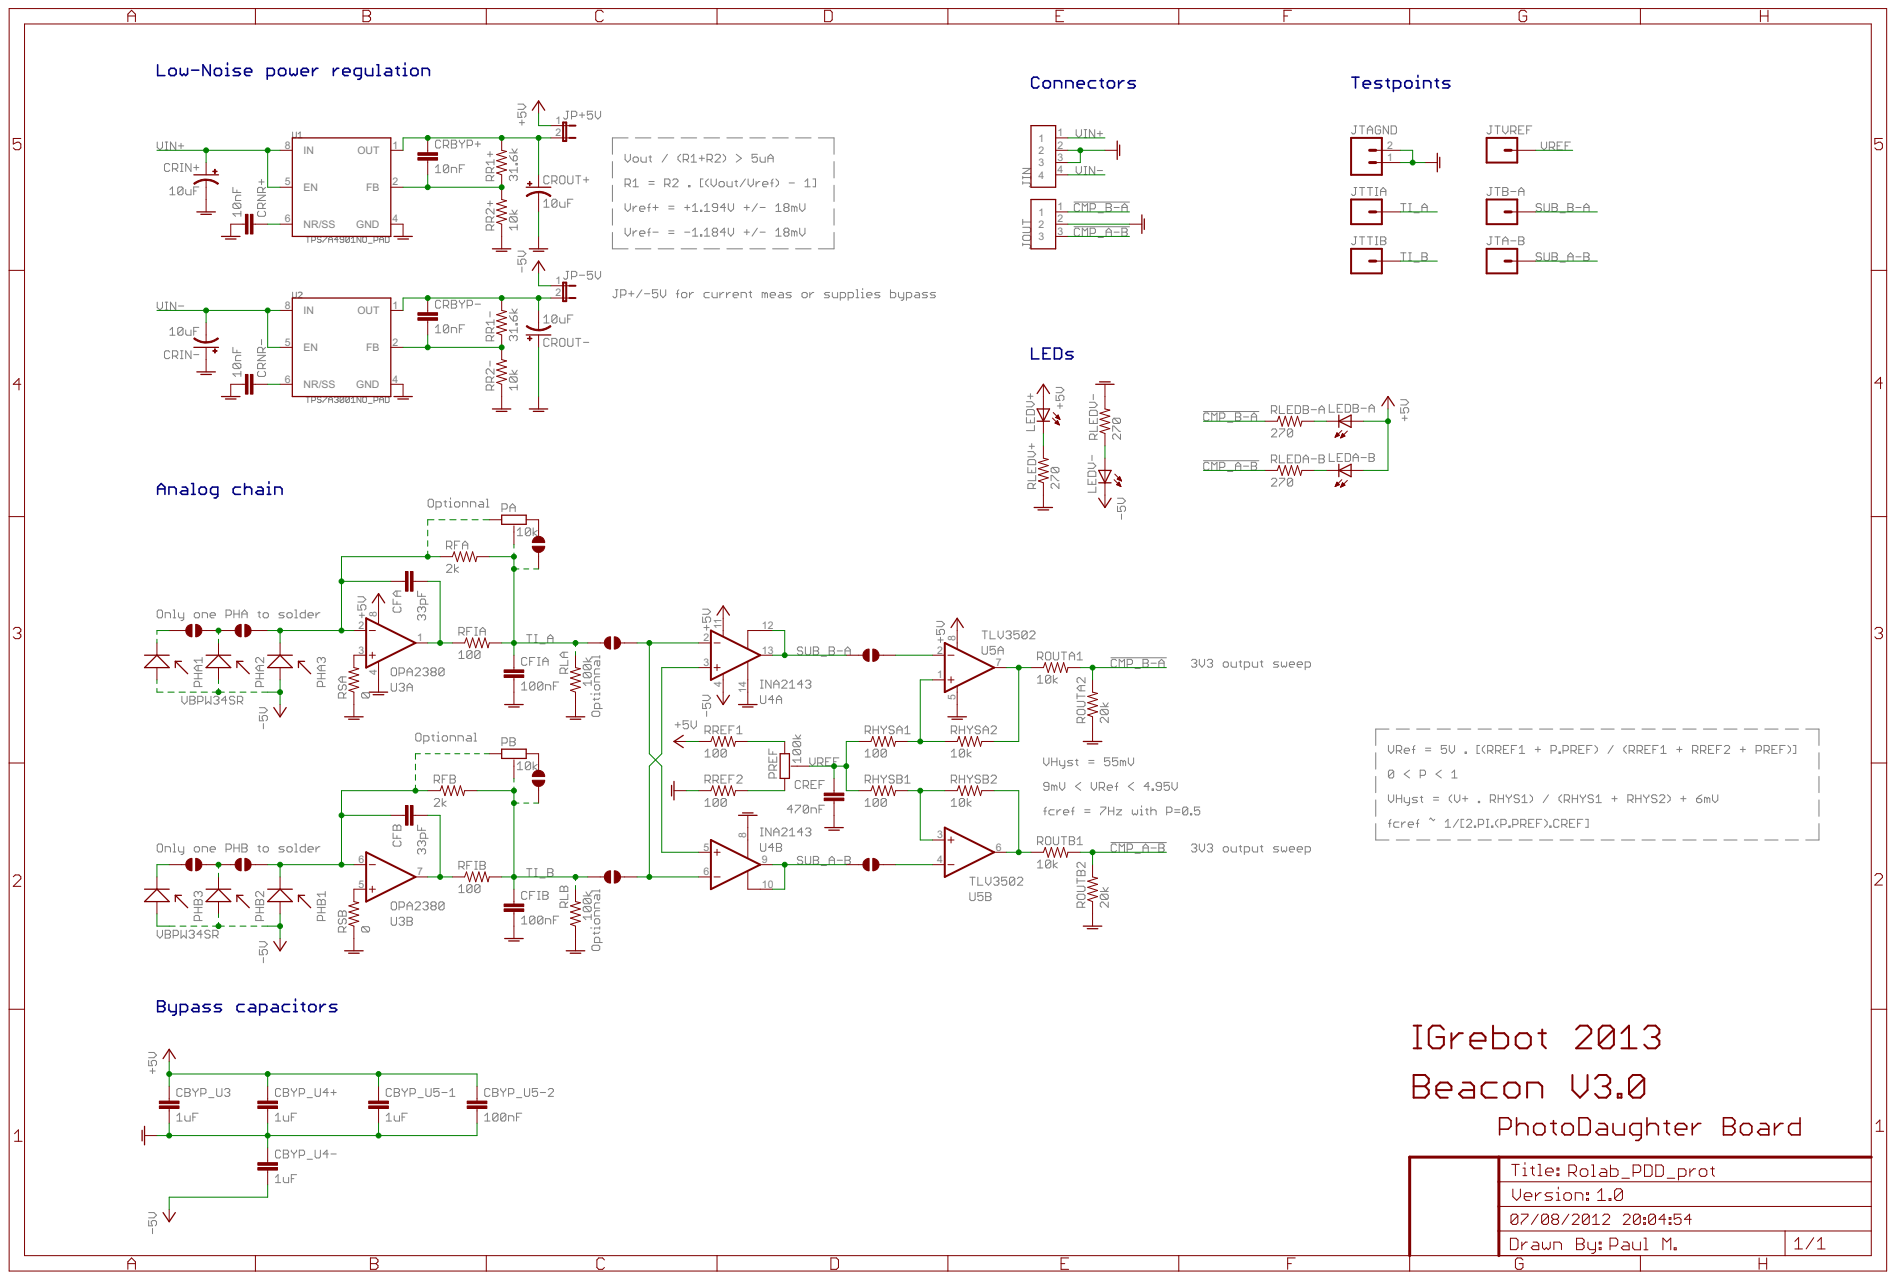
[picture p127: page 1]
