I-Grebot/Laser_Beacon_V3.0/Electronics/TUD/TUD_v1.0/PDF/TUD_layout_bot.pdf

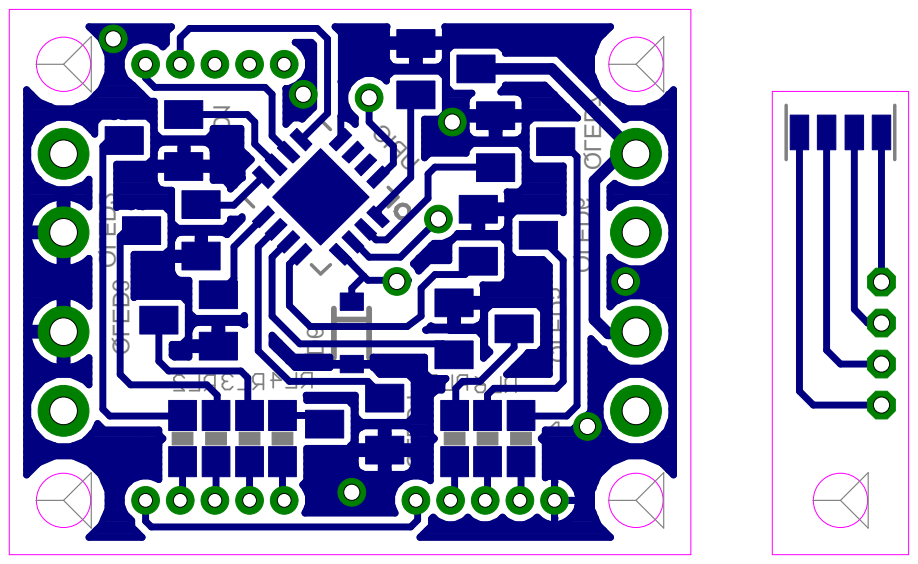
[picture p128: page 1]
