I-Grebot/Laser_Beacon_V3.0/Electronics/TUD/TUD_v1.0/PDF/TUD_layout_top.pdf

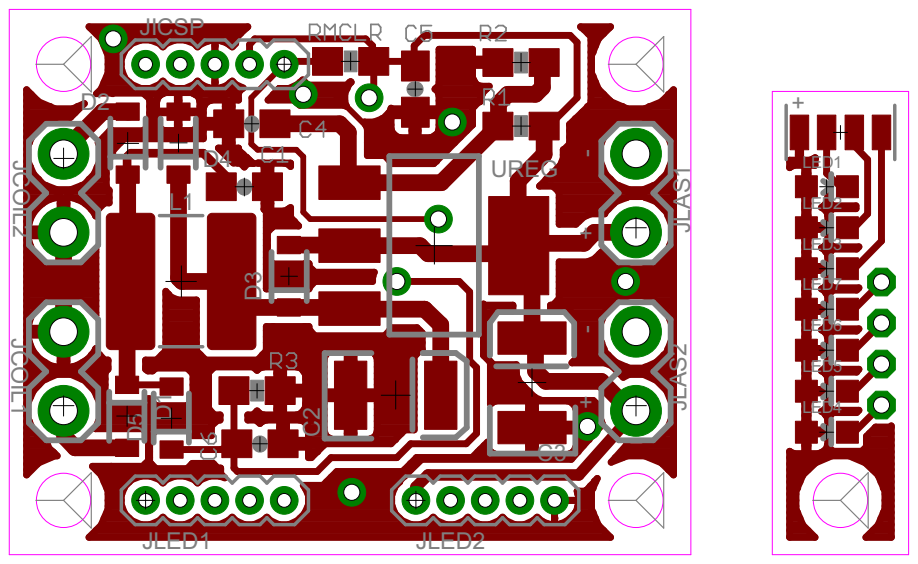
[picture p129: page 1]
