I-Grebot/Laser_Beacon_V3.0/Electronics/BTX/BTX_v1.0/Sources/BTX.brd

## EAGLE design Electronics/BTX/BTX_v1.0/Sources/BTX.brd (2016-11-03)

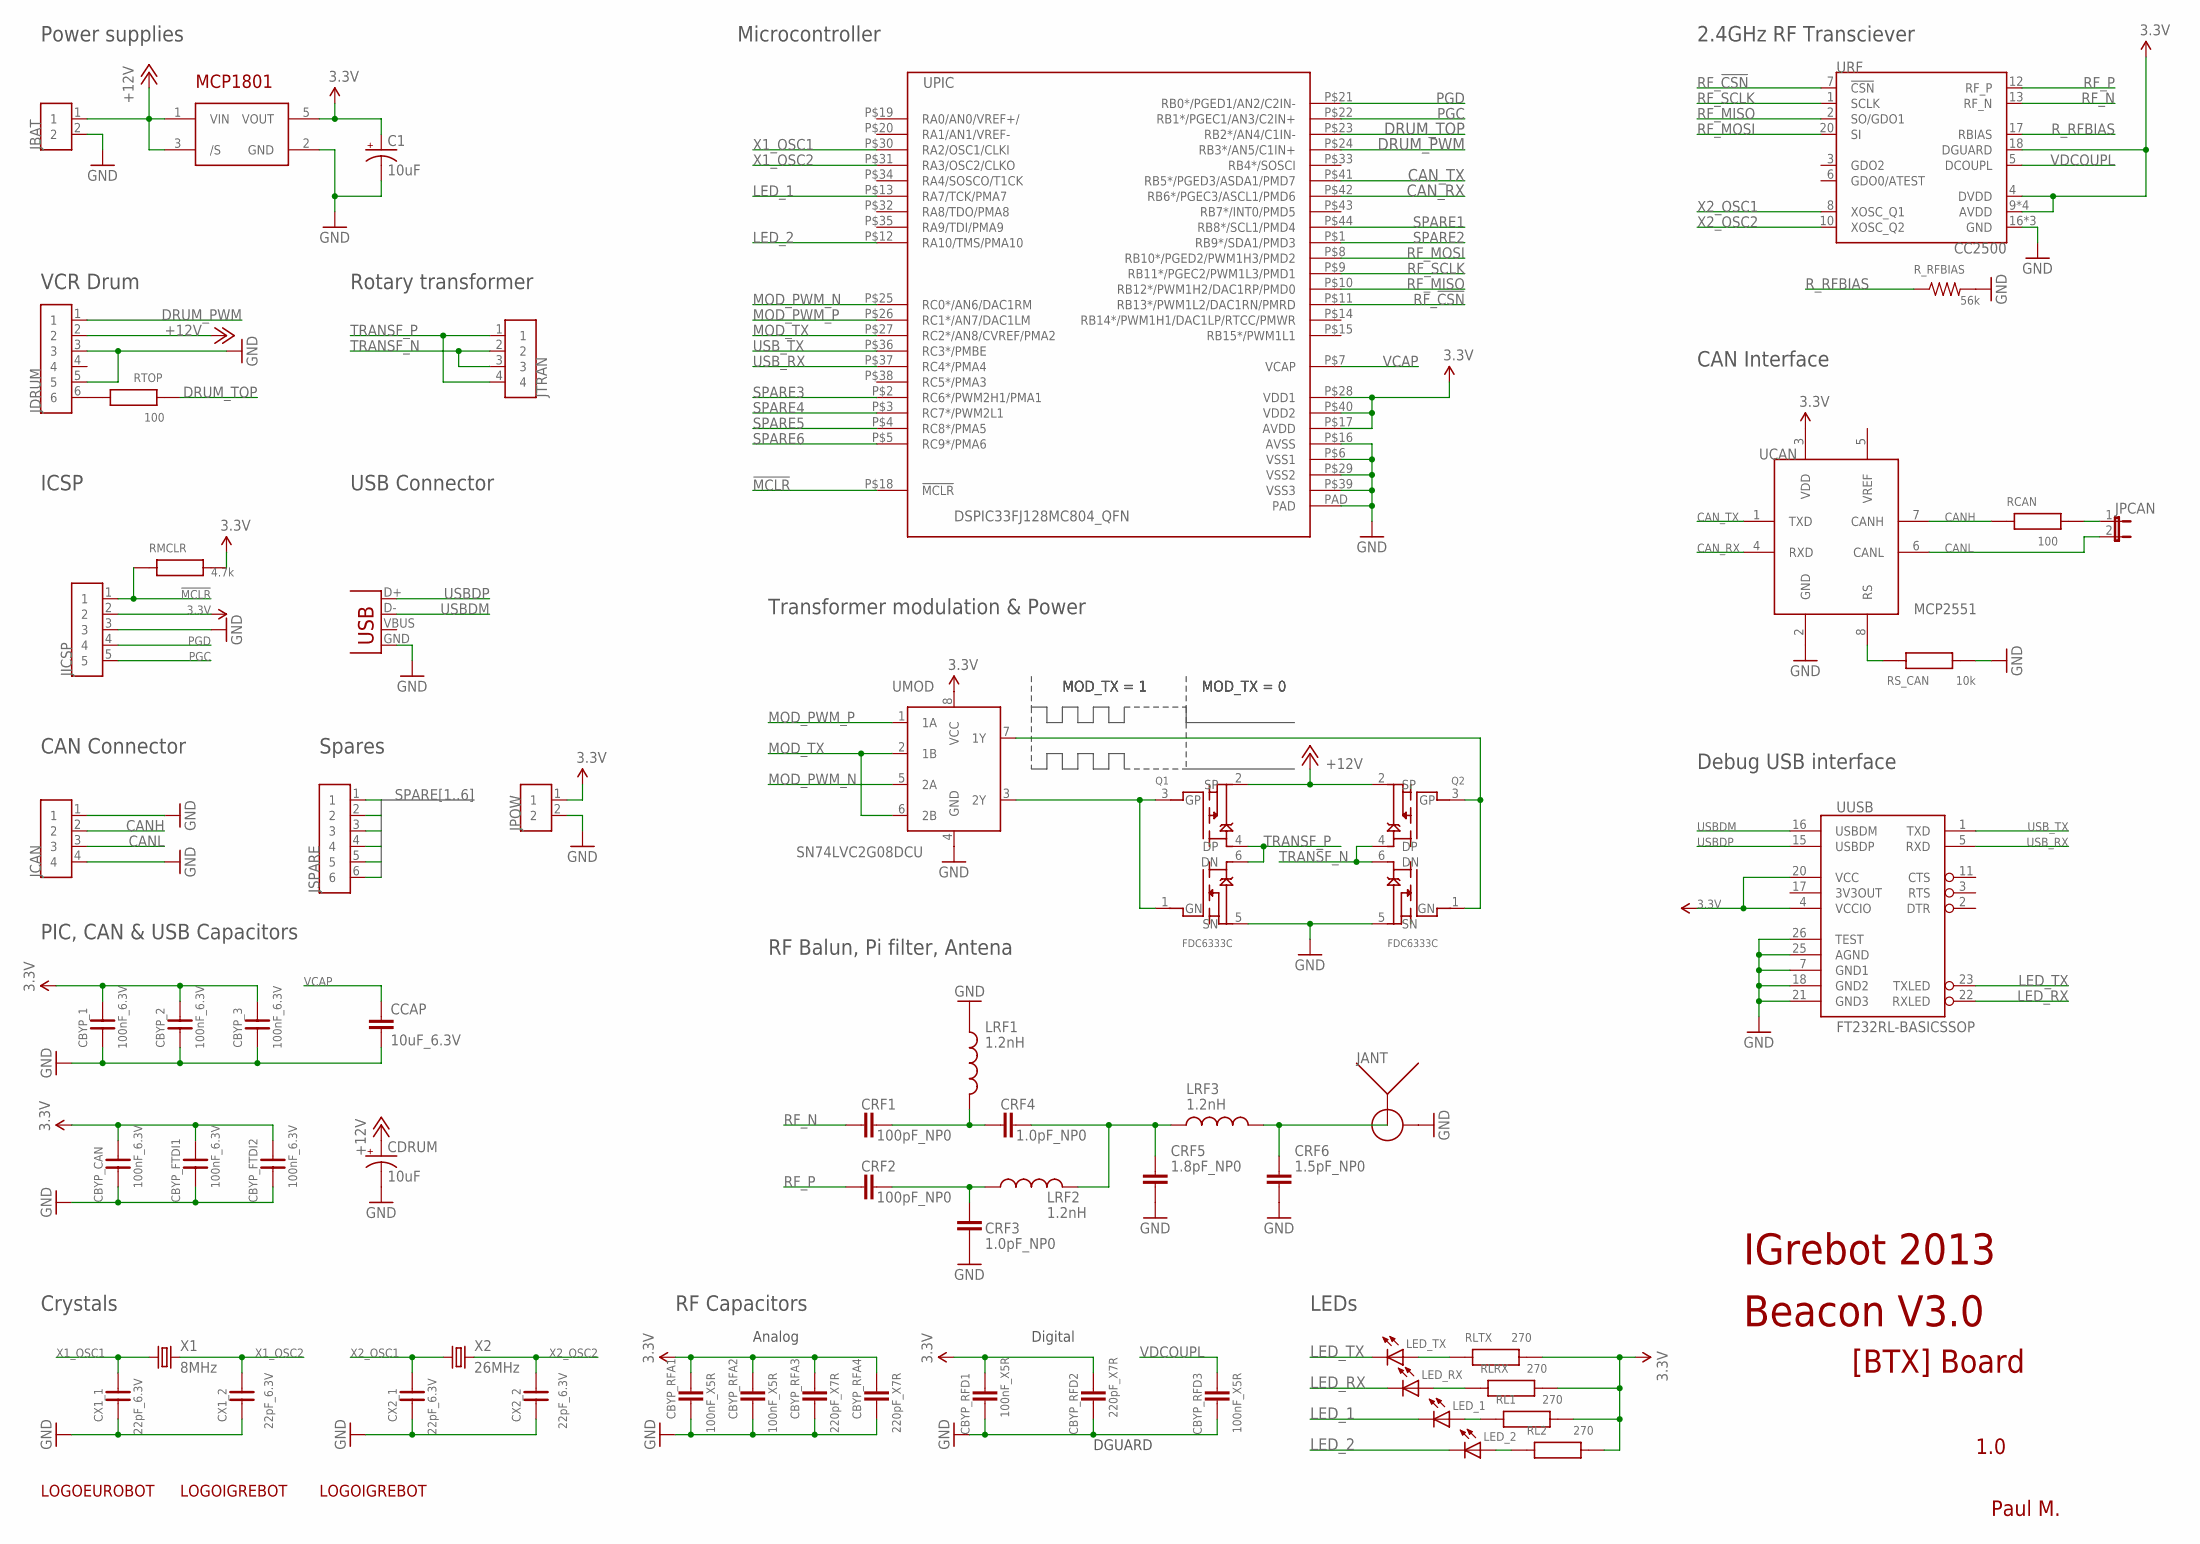
[picture p132: schematic BTX.sch]

Parts:
C1: 10uF; PANASONIC_C
CBYP_1, CBYP_2, CBYP_3: 100nF_6.3V; R0603
CBYP_CAN: 100nF_6.3V; R0603
CBYP_FTDI1, CBYP_FTDI2: 100nF_6.3V; R0603
CBYP_RFA1, CBYP_RFA2: 100nF_X5R; 0402-CAP
CBYP_RFA3, CBYP_RFA4: 220pF_X7R; 0402-CAP
CBYP_RFD1, CBYP_RFD3: 100nF_X5R; 0402-CAP
CBYP_RFD2: 220pF_X7R; 0402-CAP
CCAP: 10uF_6.3V; 1206
CDRUM: 10uF; PANASONIC_C
CRF1, CRF2: 100pF_NP0; 0402-CAP
CRF3, CRF4: 1.0pF_NP0; 0402-CAP
CRF5: 1.8pF_NP0; 0402-CAP
CRF6: 1.5pF_NP0; 0402-CAP
CX1_1, CX1_2, CX2_1, CX2_2: 22pF_6.3V; R0603
JANT: ENG_CD_1814400_C1; SMA-PCB-ANGLE
JBAT: MULTICOMP_PA001-2; CON2-5.00
JCAN: SIL4; CON4-2.54
JDRUM: SIL6; CON6-2.54
JICSP: SIL5; CON5-2.54
JPCAN: JUMPER-2PTH_LOCK; 1X02_LOCK
JPOW: SIL2; CON2-2.54
JSPARE: SIL6; CON6-2.54
JTRAN: SIL4; CON4-2.54
JUSB: USBSMD; USB-MINIB
LED_1, LED_2: LED0603; LED-0603
LED_RX: LED0603; LED-0603
LED_TX: LED0603; LED-0603
LRF1, LRF2, LRF3: 1.2nH; C0402
Q1, Q2: FDC6333C; SSOT6
RCAN: 100; R0603
RL1, RL2: 270; R0603
RLRX: 270; R0603
RLTX: 270; R0603
RMCLR: 4.7k; R0603
RS_CAN: 10k; R0603
RTOP: 100; R0603
R_RFBIAS: 56k; 0402-RES
U$3: LOGOEUROBOT; LOGO_EUROBOT_1
U$5, U$9: LOGOIGREBOT; LOGO_IGREBOT
UCAN: MCP2551; SO-08
UMOD: SN74LVC2G08DCU; DCU8
UPIC: DSPIC33FJ128MC804_QFN; QFN44-8X8
UREG: MCP1801; SOT23-5L
URF: CC2500; QFN20-0.5
UUSB: FT232RL-BASICSSOP; SSOP28DB
X1: 8MHz; XTAL_4.9-1.8
X2: 26MHz; XTAL_4.9-1.8

Connections:
3.3V: C1.+, CBYP_1.1, CBYP_2.1, CBYP_3.1, CBYP_CAN.1, CBYP_FTDI1.1, CBYP_FTDI2.1, CBYP_RFA1.2, CBYP_RFA2.2, CBYP_RFA3.2, CBYP_RFA4.2, CBYP_RFD1.2, CBYP_RFD2.2, JICSP.2, JPOW.1, RL1.1, RL2.1, RLRX.1, RLTX.1, RMCLR.1, UCAN.3 (VDD), UMOD.8 (VCC), UPIC.P$17 (AVDD), UPIC.P$28 (VDD1), UPIC.P$40 (VDD2), UREG.5 (VOUT), URF.4 (DVDD), URF.9 (AVDD), URF.11 (AVDD), URF.14 (AVDD), URF.15 (AVDD), URF.18 (DGUARD), UUSB.4 (VCCIO), UUSB.20 (VCC)
!MCLR!: JICSP.1, RMCLR.2, UPIC.P$18 (!MCLR)
+12V: CDRUM.+, JBAT.1, JDRUM.2, Q1.2 (SP), Q2.2 (SP), UREG.1 (VIN), UREG.3 (/S)
CANH: JCAN.2, RCAN.1, UCAN.7 (CANH)
CANL: JCAN.3, JPCAN.2, UCAN.6 (CANL)
CAN_RX: UCAN.4 (RXD), UPIC.P$42 (RB6*/PGEC3/ASCL1/PMD6)
CAN_TX: UCAN.1 (TXD), UPIC.P$41 (RB5*/PGED3/ASDA1/PMD7)
DRUM_PWM: JDRUM.1, UPIC.P$24 (RB3*/AN5/C1IN+)
DRUM_TOP: RTOP.1, UPIC.P$23 (RB2*/AN4/C1IN-)
GND: C1.-, CBYP_1.2, CBYP_2.2, CBYP_3.2, CBYP_CAN.2, CBYP_FTDI1.2, CBYP_FTDI2.2, CBYP_RFA1.1, CBYP_RFA2.1, CBYP_RFA3.1, CBYP_RFA4.1, CBYP_RFD1.1, CBYP_RFD2.1, CBYP_RFD3.1, CCAP.2, CDRUM.-, CRF3.1, CRF5.1, CRF6.1, CX1_1.2, CX1_2.2, CX2_1.2, CX2_2.2, JANT.B1 (B), JANT.B2 (B), JANT.B3 (B), JANT.B4 (B), JBAT.2, JCAN.1, JCAN.4, JDRUM.3, JDRUM.5, JICSP.3, JPOW.2, JUSB.GND, LRF1.1, Q1.5 (SN), Q2.5 (SN), RS_CAN.1, R_RFBIAS.2, UCAN.2 (GND), UMOD.4 (GND), UPIC.P$6 (VSS1), UPIC.P$16 (AVSS), UPIC.P$29 (VSS2), UPIC.P$39 (VSS3), UPIC.PAD, UREG.2 (GND), URF.16 (GND), URF.19 (GND), URF.PAD (GND), UUSB.7 (GND1), UUSB.18 (GND2), UUSB.21 (GND3), UUSB.25 (AGND), UUSB.26 (TEST)
LED_1: LED_1.C, UPIC.P$13 (RA7/TCK/PMA7)
LED_2: LED_2.C, UPIC.P$12 (RA10/TMS/PMA10)
LED_RX: LED_RX.C, UUSB.22 (RXLED)
LED_TX: LED_TX.C, UUSB.23 (TXLED)
MOD_N: Q1.1 (GN), Q1.3 (GP), UMOD.3 (2Y)
MOD_P: Q2.1 (GN), Q2.3 (GP), UMOD.7 (1Y)
MOD_PWM_N: UMOD.5 (2A), UPIC.P$25 (RC0*/AN6/DAC1RM)
MOD_PWM_P: UMOD.1 (1A), UPIC.P$26 (RC1*/AN7/DAC1LM)
MOD_TX: UMOD.2 (1B), UMOD.6 (2B), UPIC.P$27 (RC2*/AN8/CVREF/PMA2)
unnamed: CRF1.2, CRF4.2, LRF1.2
unnamed: LED_TX.A, RLTX.2
unnamed: CRF2.2, CRF3.2, LRF2.1
unnamed: CRF4.1, CRF5.2, LRF2.2, LRF3.1
unnamed: RS_CAN.2, UCAN.8 (RS)
unnamed: JPCAN.1, RCAN.2
unnamed: CRF6.2, JANT.A, LRF3.2
unnamed: LED_RX.A, RLRX.2
unnamed: LED_1.A, RL1.2
unnamed: LED_2.A, RL2.2
PGC: JICSP.5, UPIC.P$22 (RB1*/PGEC1/AN3/C2IN+)
PGD: JICSP.4, UPIC.P$21 (RB0*/PGED1/AN2/C2IN-)
RF_!CSN!: UPIC.P$11 (RB13*/PWM1L2/DAC1RN/PMRD), URF.7 (!CSN!)
RF_MISO: UPIC.P$10 (RB12*/PWM1H2/DAC1RP/PMD0), URF.2 (SO/GDO1)
RF_MOSI: UPIC.P$8 (RB10*/PGED2/PWM1H3/PMD2), URF.20 (SI)
RF_N: CRF1.1, URF.13 (RF_N)
RF_P: CRF2.1, URF.12 (RF_P)
RF_SCLK: UPIC.P$9 (RB11*/PGEC2/PWM1L3/PMD1), URF.1 (SCLK)
RTOP: JDRUM.6, RTOP.2
R_RFBIAS: R_RFBIAS.1, URF.17 (RBIAS)
SPARE1: JSPARE.1, UPIC.P$44 (RB8*/SCL1/PMD4)
SPARE2: JSPARE.2, UPIC.P$1 (RB9*/SDA1/PMD3)
SPARE3: JSPARE.3, UPIC.P$2 (RC6*/PWM2H1/PMA1)
SPARE4: JSPARE.4, UPIC.P$3 (RC7*/PWM2L1)
SPARE5: JSPARE.5, UPIC.P$4 (RC8*/PMA5)
SPARE6: JSPARE.6, UPIC.P$5 (RC9*/PMA6)
TRANSF_N: JTRAN.2, JTRAN.3, Q2.4 (DP), Q2.6 (DN)
TRANSF_P: JTRAN.1, JTRAN.4, Q1.4 (DP), Q1.6 (DN)
USBDM: JUSB.D-, UUSB.16 (USBDM)
USBDP: JUSB.D+, UUSB.15 (USBDP)
USB_RX: UPIC.P$37 (RC4*/PMA4), UUSB.5 (RXD)
USB_TX: UPIC.P$36 (RC3*/PMBE), UUSB.1 (TXD)
VCAP: CCAP.1, UPIC.P$7 (VCAP)
VDCOUPL: CBYP_RFD3.2, URF.5 (DCOUPL)
X1_OSC1: CX1_1.1, UPIC.P$30 (RA2/OSC1/CLKI), X1.P$1 (1)
X1_OSC2: CX1_2.1, UPIC.P$31 (RA3/OSC2/CLKO), X1.P$2 (2)
X2_OSC1: CX2_1.1, URF.8 (XOSC_Q1), X2.P$1 (1)
X2_OSC2: CX2_2.1, URF.10 (XOSC_Q2), X2.P$2 (2)

Notes on the sheet:
Debug USB interface
CAN Interface
LEDs
PIC, CAN & USB Capacitors
USB Connector
Power supplies
ICSP
Rotary transformer
VCR Drum
Transformer modulation & Power
DGUARD
RF Balun, Pi filter, Antena
2.4GHz RF Transciever
Crystals
RF Capacitors
Analog
Digital
CAN Connector
Microcontroller
MOD_TX = 1
MOD_TX = 0
Spares
IGrebot 2013
Beacon V3.0
[BTX] Board
1.0
Paul M.

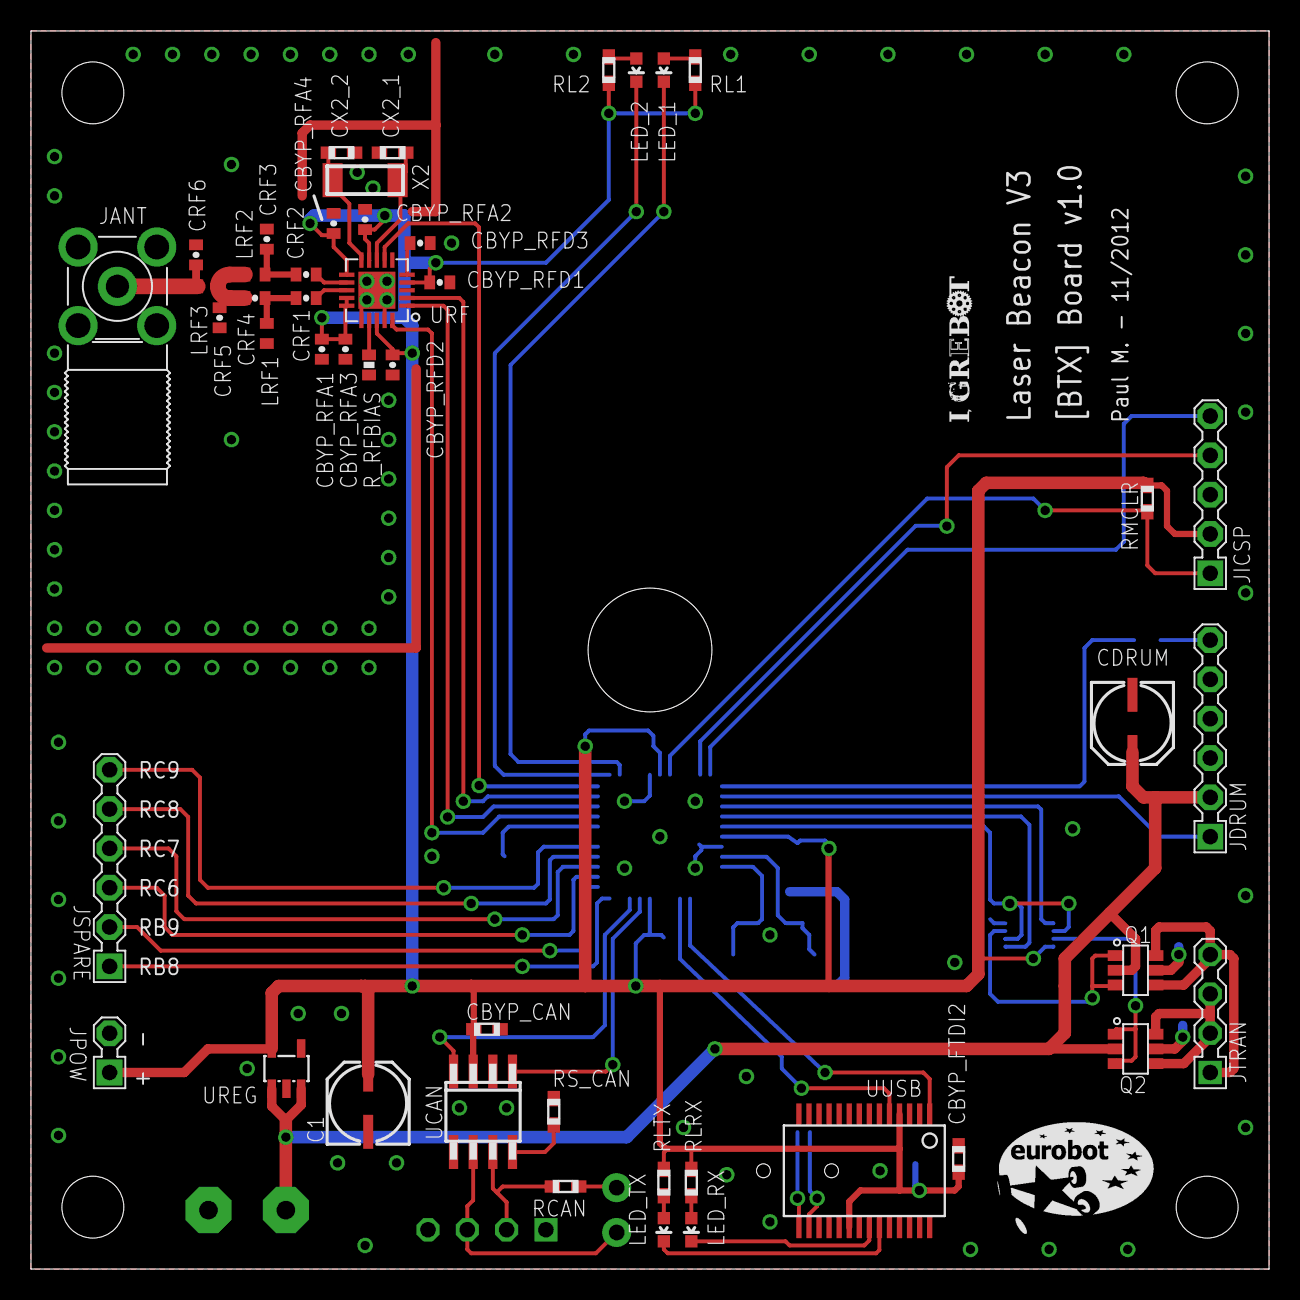
[picture p133: board BTX.brd from above]

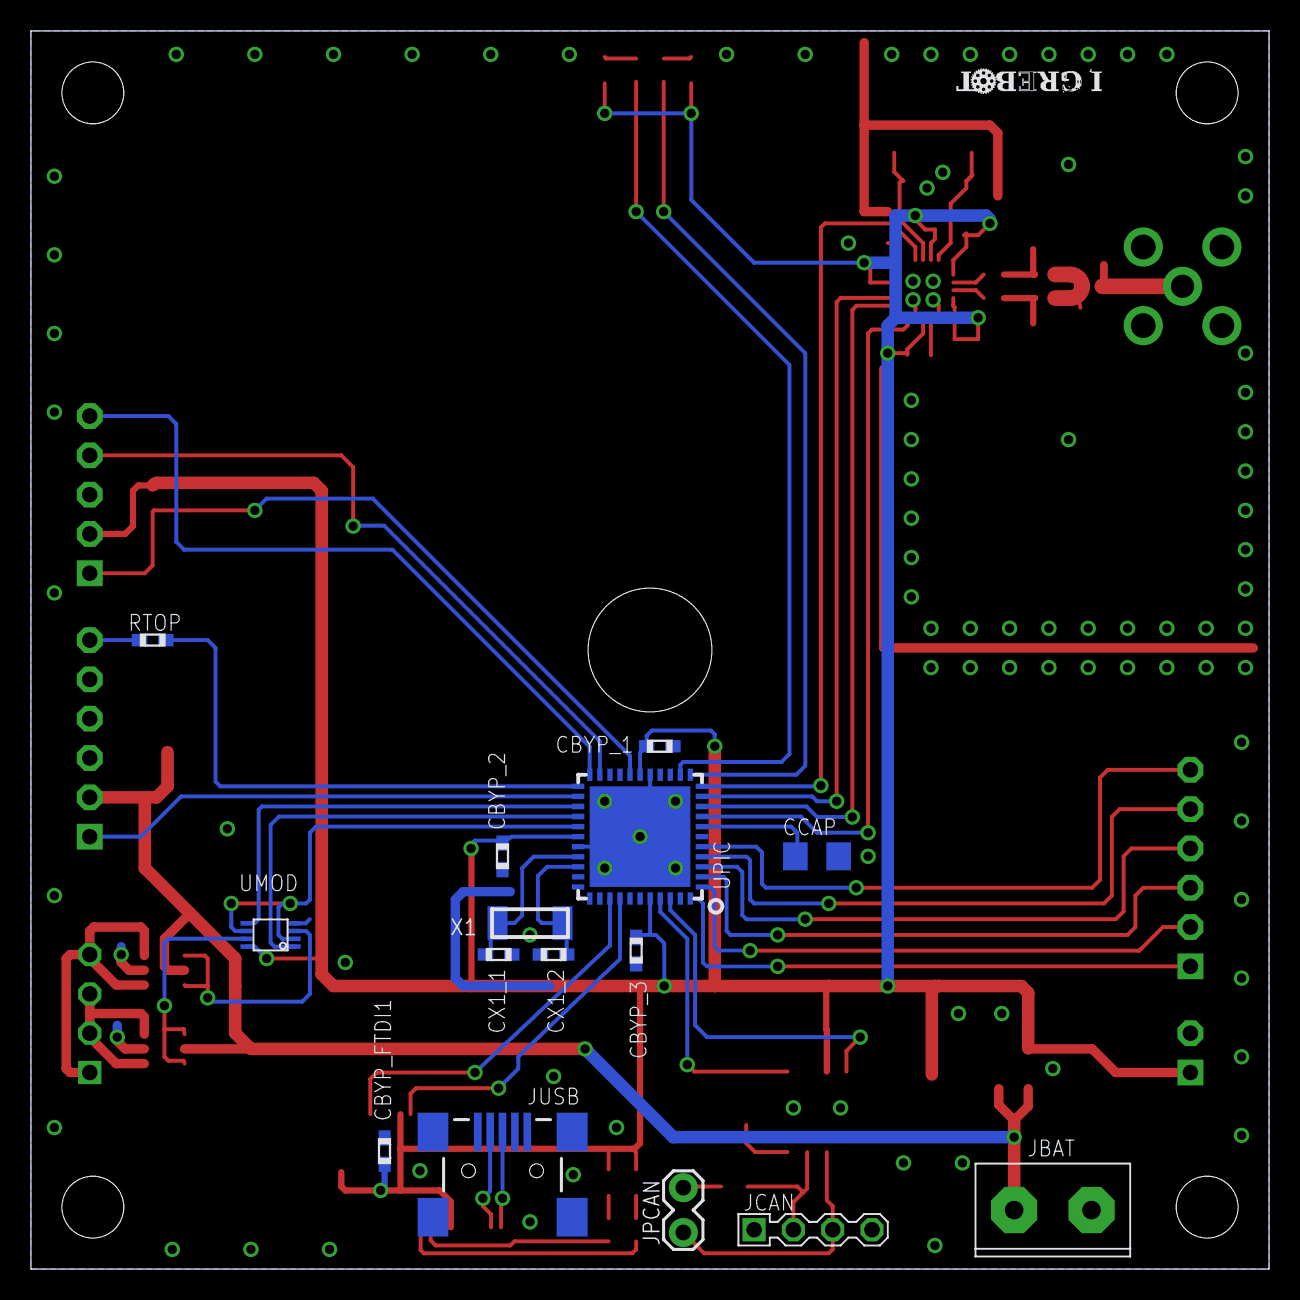
[picture p134: board BTX.brd from below]

Board: 2 copper layers, 80.0 x 80.0 mm, 65 parts (16 on the bottom side), 57 nets.
