I-Grebot/Laser_Beacon_V3.0/Electronics/TUD/TUD_v1.0/Sources/TUD.brd

## EAGLE design Electronics/TUD/TUD_v1.0/Sources/TUD.brd (2016-11-03)

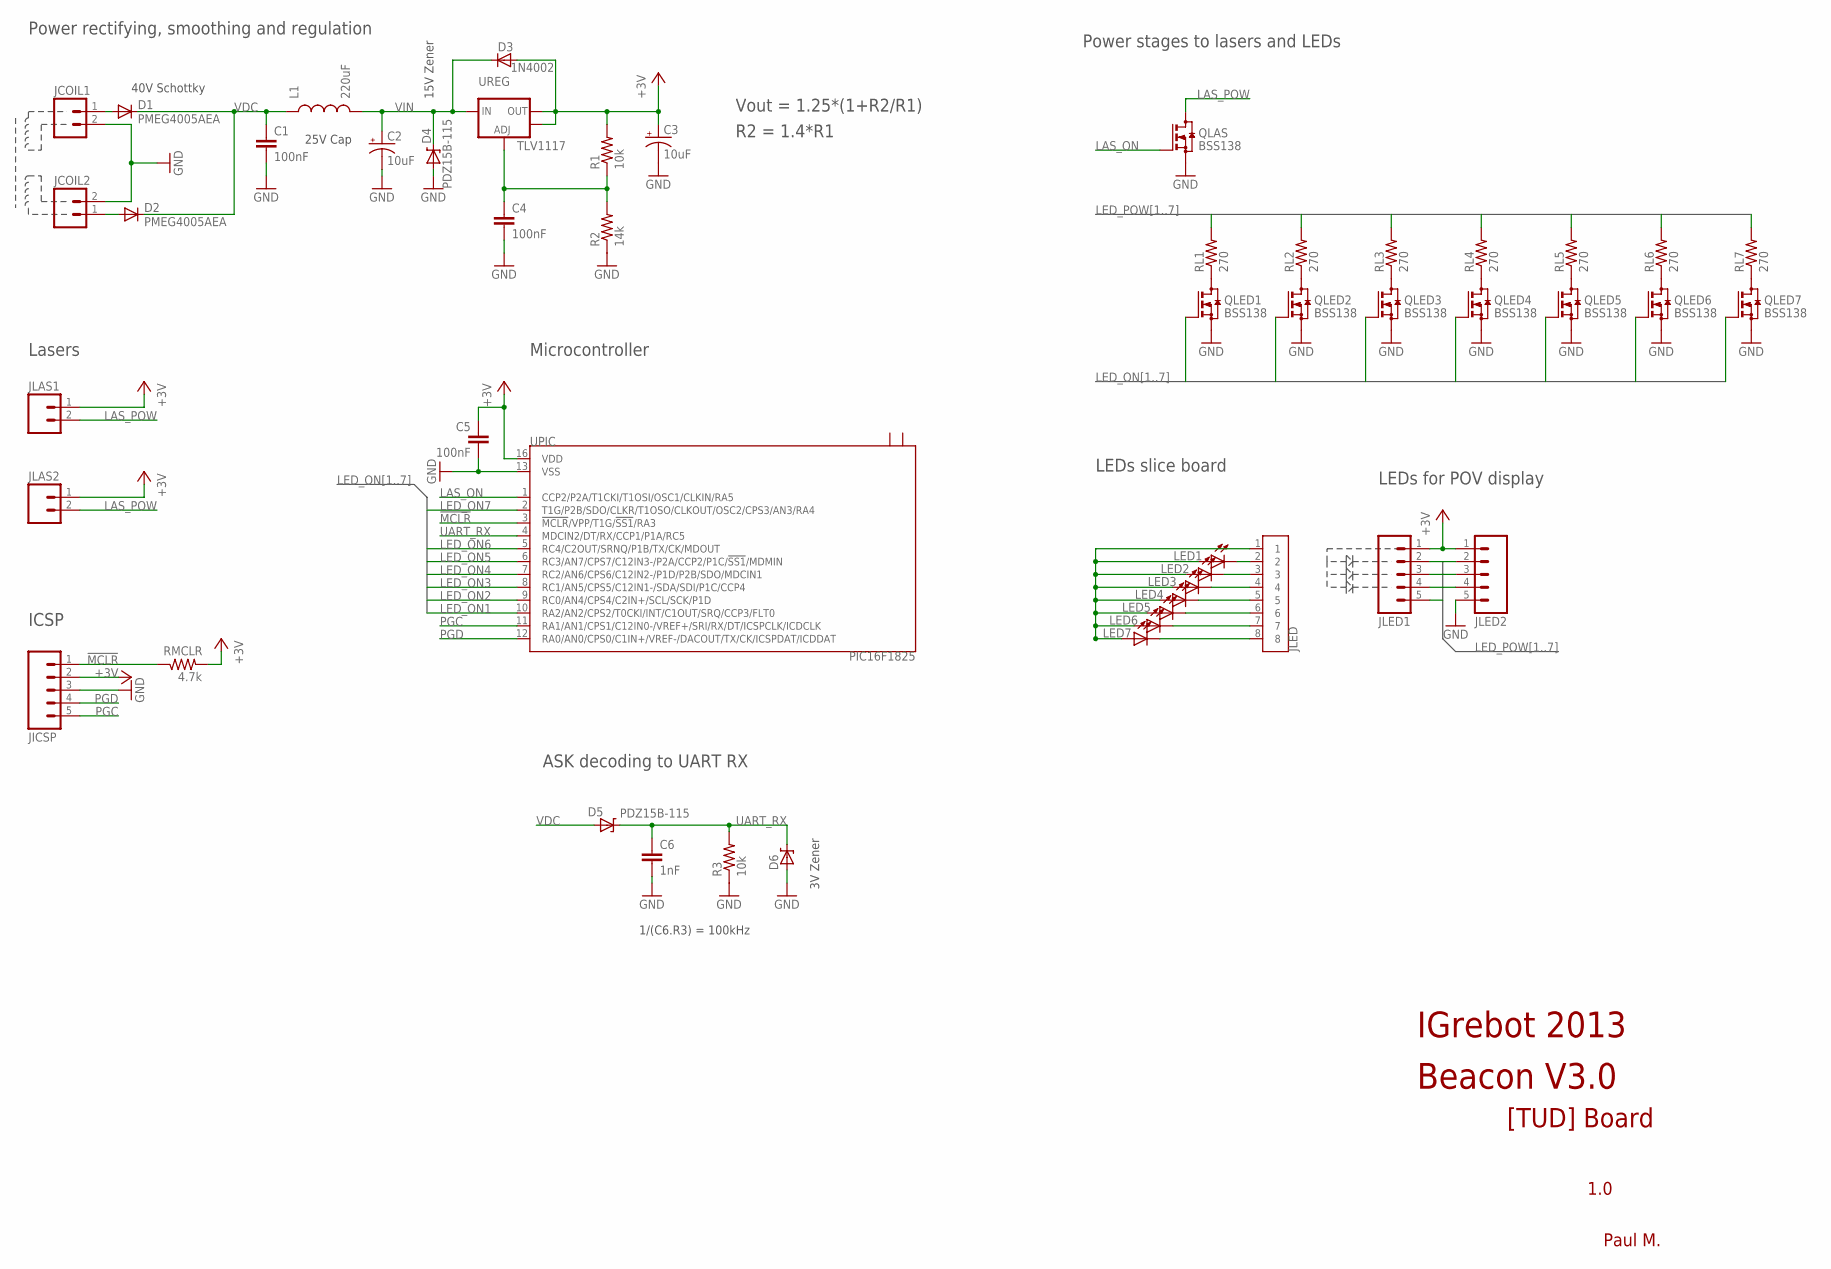
[picture p135: schematic TUD.sch]

Parts:
C1, C4, C5: 100nF; 0603-CAP
C2, C3: 10uF; EIA3528
C6: 1nF; 0603-CAP
D1, D2: PMEG4005AEA; SOD-323
D3: 1N4002; SOD-323
D4, D5: PDZ15B-115; SOD-323
D6: DIODE-ZENER-BZT52; SOD-323
JCOIL1, JCOIL2: M02LOCK; 1X02_LOCK
JICSP: M051.27MM; 1X05-1.27MM
JLAS1, JLAS2: M02LOCK; 1X02_LOCK
JLED: CON8_SMD-1; CON8-SMD-1
JLED1, JLED2: M051.27MM; 1X05-1.27MM
L1: 220uF; L-5X5
LED1, LED2, LED3, LED4, LED5, LED6, LED7: LED0603; LED-0603
QLAS: BSS138; SOT23
QLED1, QLED2, QLED3, QLED4, QLED5, QLED6, QLED7: BSS138; SOT23
R1, R3: 10k; 0603-RES
R2: 14k; 0603-RES
RL1, RL2, RL3, RL4, RL5, RL6, RL7: 270; 0603-RES
RMCLR: 4.7k; 0603-RES
UPIC: PIC16F1825; QFN16-0.65
UREG: TLV1117; SOT223

Connections:
!MCLR!: JICSP.1, RMCLR.1, UPIC.3 (!MCLR!/VPP/T1G/!SS1!/RA3)
+3V3: C3.A (+), C5.1, D3.2 (A), JICSP.2, JLAS1.1, JLAS2.1, JLED1.1, JLED2.1, R1.2, RMCLR.2, UPIC.16 (VDD), UREG.2 (OUT), UREG.4 (OUT)
GND: C1.2, C2.C (-), C3.C (-), C4.2, C5.2, C6.2, D4.2 (A), D6.2 (A), JCOIL1.2, JCOIL2.2, JICSP.3, JLED2.5, QLAS.2 (S), QLED1.2 (S), QLED2.2 (S), QLED3.2 (S), QLED4.2 (S), QLED5.2 (S), QLED6.2 (S), QLED7.2 (S), R2.1, R3.1, UPIC.13 (VSS)
LAS_ON: QLAS.1 (G), UPIC.1 (CCP2/P2A/T1CKI/T1OSI/OSC1/CLKIN/RA5)
LAS_POW: JLAS1.2, JLAS2.2, QLAS.3 (D)
LED_ON1: QLED1.1 (G), UPIC.10 (RA2/AN2/CPS2/T0CKI/INT/C1OUT/SRQ/CCP3/F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)
LED_ON2: QLED2.1 (G), UPIC.9 (RC0/AN4/CPS4/C2IN+/SCL/SCK/P1D)
LED_ON3: QLED3.1 (G), UPIC.8 (RC1/AN5/CPS5/C12IN1-/SDA/SDI/P1C/CCP4)
LED_ON4: QLED4.1 (G), UPIC.7 (RC2/AN6/CPS6/C12IN2-/P1D/P2B/SDO/MDCIN1)
LED_ON5: QLED5.1 (G), UPIC.6 (RC3/AN7/CPS7/C12IN3-/P2A/CCP2/P1C/!SS1!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)
LED_ON6: QLED6.1 (G), UPIC.5 (RC4/C2OUT/SRNQ/P1B/TX/CK/MDOUT)
LED_ON7: QLED7.1 (G), UPIC.2 (T1G/P2B/SDO/CLKR/T1OSO/CLKOUT/OSC2/CPS3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)
LED_POW1: JLED1.2, RL1.2
LED_POW2: JLED1.3, RL2.2
LED_POW3: JLED1.4, RL3.2
LED_POW4: JLED1.5, RL4.2
LED_POW5: JLED2.2, RL5.2
LED_POW6: JLED2.3, RL6.2
LED_POW7: JLED2.4, RL7.2
unnamed: JLED.2, LED1.C
unnamed: D1.2 (A), JCOIL1.1
unnamed: D2.2 (A), JCOIL2.1
unnamed: JLED.3, LED2.C
unnamed: QLED1.3 (D), RL1.1
unnamed: C4.1, R1.1, R2.2, UREG.1 (ADJ)
unnamed: QLED2.3 (D), RL2.1
unnamed: QLED3.3 (D), RL3.1
unnamed: QLED4.3 (D), RL4.1
unnamed: QLED5.3 (D), RL5.1
unnamed: QLED6.3 (D), RL6.1
unnamed: QLED7.3 (D), RL7.1
unnamed: JLED.4, LED3.C
unnamed: JLED.5, LED4.C
unnamed: JLED.6, LED5.C
unnamed: JLED.7, LED6.C
unnamed: JLED.8, LED7.C
unnamed: JLED.1, LED1.A, LED2.A, LED3.A, LED4.A, LED5.A, LED6.A, LED7.A
PGC: JICSP.5, UPIC.11 (RA1/AN1/CPS1/C12IN0-/VREF+/SRI/RX/DT/IC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)
PGD: JICSP.4, UPIC.12 (RA0/AN0/CPS0/C1IN+/VREF-/DACOUT/TX/CK/I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)
UART_RX: C6.1, D5.1 (C), D6.1 (C), R3.2, UPIC.4 (MDCIN2/DT/RX/CCP1/P1A/RC5)
VDC: C1.1, D1.1 (C), D2.1 (C), D5.2 (A), L1.1
VIN: C2.A (+), D3.1 (C), D4.1 (C), L1.2, UREG.3 (IN)

Notes on the sheet:
1.0
Paul M.
Vout = 1.25*(1+R2/R1)
R2 = 1.4*R1
40V Schottky
15V Zener
25V Cap
3V Zener
1/(C6.R3) = 100kHz
IGrebot 2013
Beacon V3.0
[TUD] Board
Power rectifying, smoothing and regulation
Power stages to lasers and LEDs
Microcontroller
ASK decoding to UART RX
LEDs slice board
LEDs for POV display
Lasers
ICSP

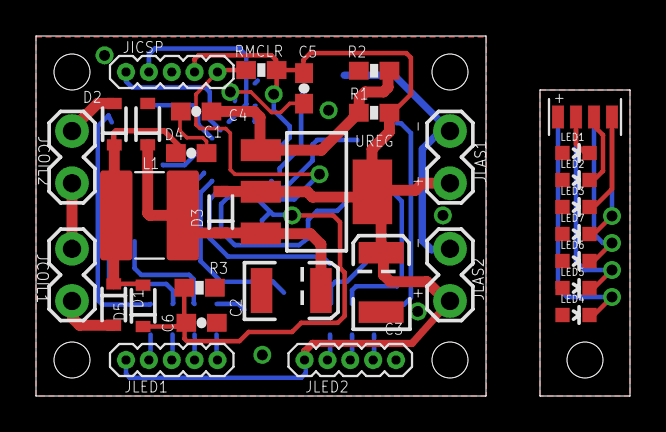
[picture p136: board TUD.brd from above]

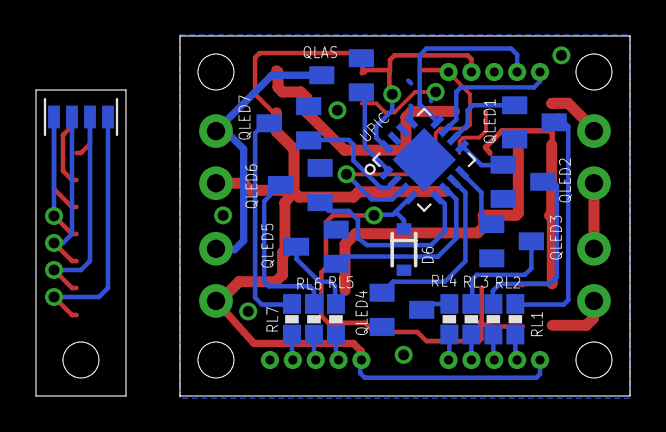
[picture p137: board TUD.brd from below]

Board: 2 copper layers, 33.0 x 20.0 mm, 49 parts (17 on the bottom side), 42 nets.
