I-Grebot/Laser_Beacon_V3.0/Electronics/PDD/Prototype/Sources/Rolab_PDD_prot.brd

## EAGLE design Electronics/PDD/Prototype/Sources/Rolab_PDD_prot.brd (2016-11-03)

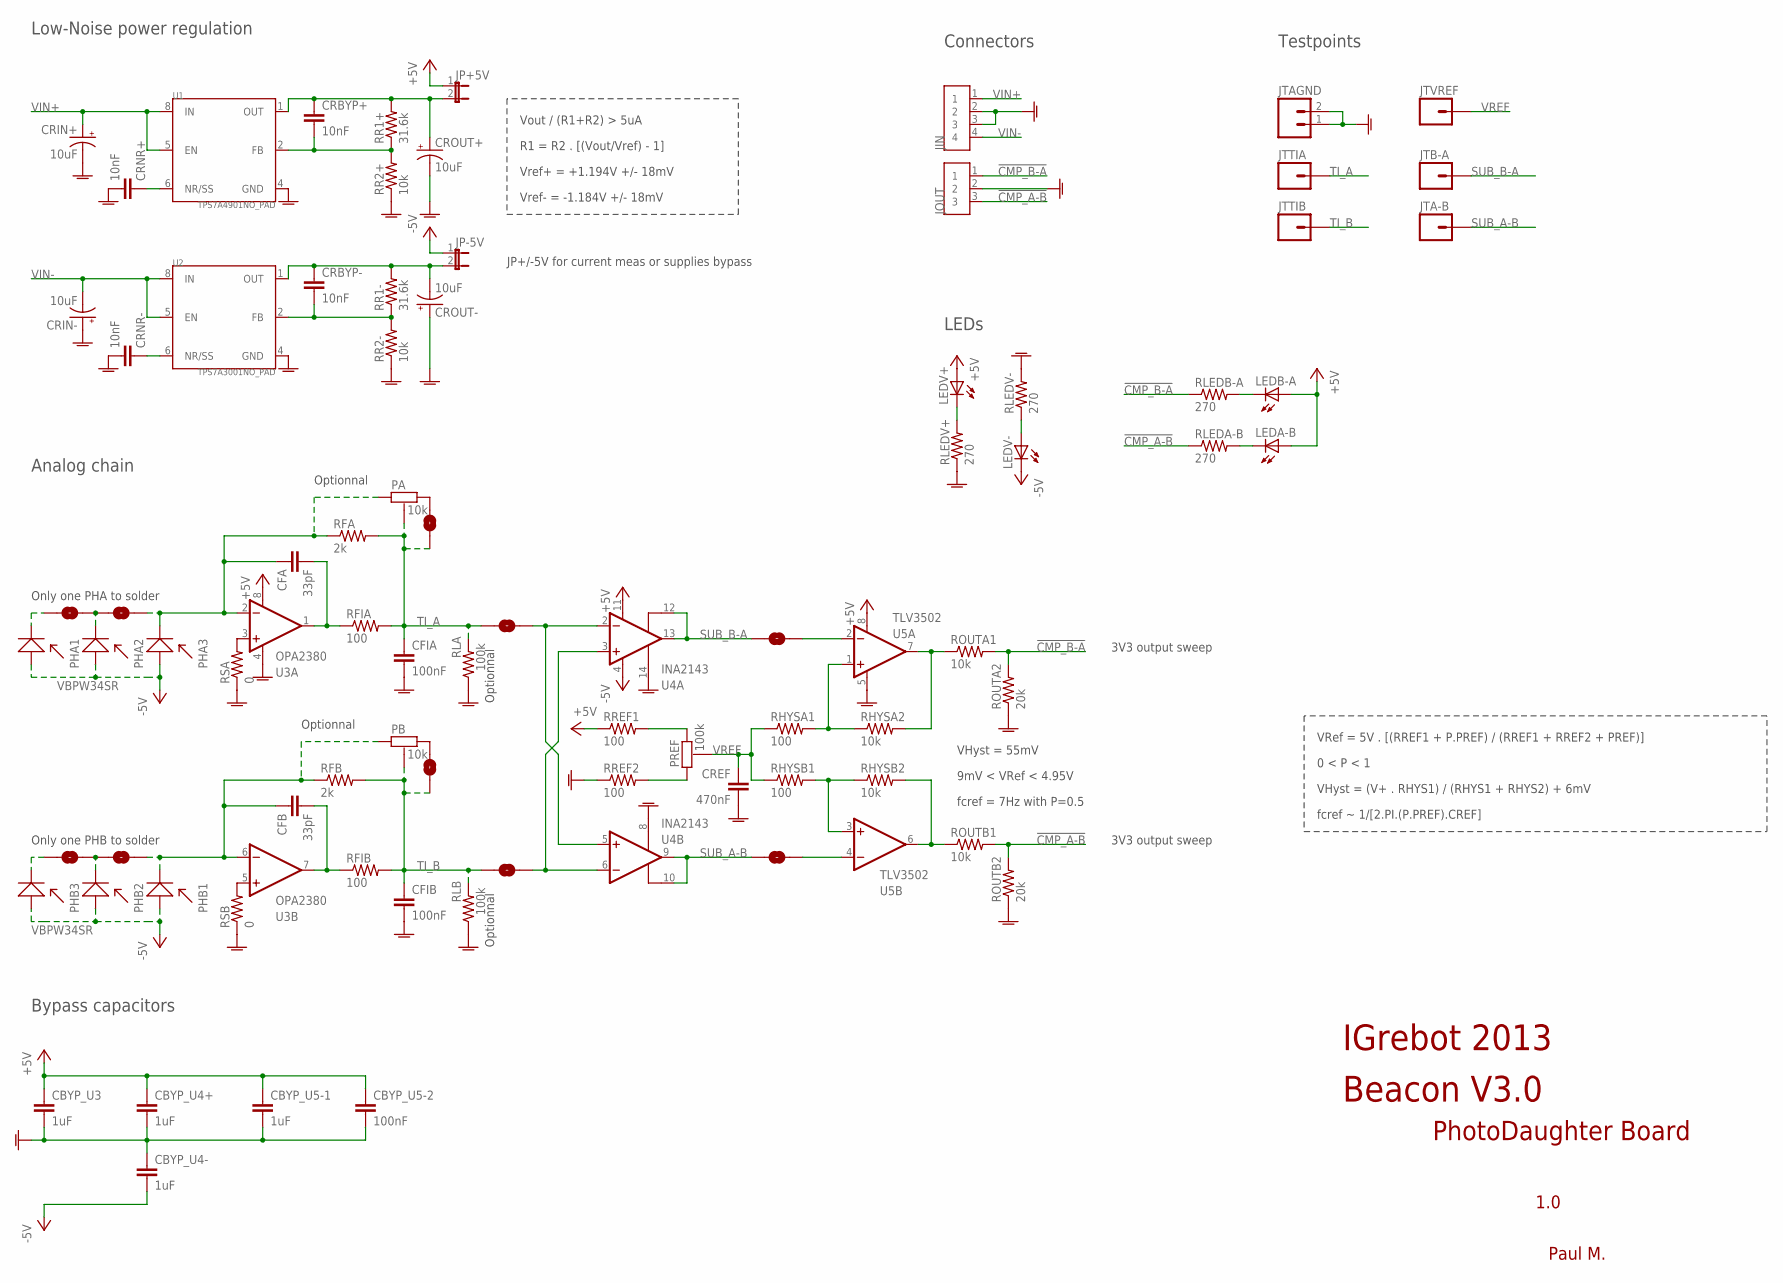
[picture p138: schematic Rolab_PDD_prot.sch]

Parts:
CBYP_U3, CBYP_U4+, CBYP_U4-, CBYP_U5-1: 1uF; 0603-CAP
CBYP_U5-2: 100nF; 0603-CAP
CFA: 33pF; 0603-CAP
CFB: 33pF; 0603-CAP
CFIA: 100nF; 0603-CAP
CFIB: 100nF; 0603-CAP
CRBYP+: 10nF; 0603-CAP
CRBYP-: 10nF; 0603-CAP
CREF: 470nF; 0603-CAP
CRIN+: 10uF; EIA3528-KIT
CRIN-: 10uF; EIA3528-KIT
CRNR+: 10nF; 0603-CAP
CRNR-: 10nF; 0603-CAP
CROUT+: 10uF; EIA3528-KIT
CROUT-: 10uF; EIA3528-KIT
JIN: SIL4; CON4-2.54
JOUT: SIL3; CON3-2.54
JP+5V: JUMPER-2PTH_LOCK; 1X02_LOCK
JP-5V: JUMPER-2PTH_LOCK; 1X02_LOCK
JTA-B: M01PTH; 1X01
JTAGND: M02LOCK; 1X02_LOCK
JTB-A: M01PTH; 1X01
JTTIA: M01PTH; 1X01
JTTIB: M01PTH; 1X01
JTVREF: M01PTH; 1X01
LEDA-B: LED0603; LED-0603
LEDB-A: LED0603; LED-0603
LEDV+: LED0603; LED-0603
LEDV-: LED0603; LED-0603
PA: 10k; TRIM-PVZ2A
PB: 10k; TRIM-PVZ2A
PHA1, PHA2, PHA3: VBPW34SR
PHB1, PHB2, PHB3: VBPW34SR
PREF: 100k; TRIM-PVZ2A
RFA: 2k; 0603-RES
RFB: 2k; 0603-RES
RFIA: 100; 0603-RES
RFIB: 100; 0603-RES
RHYSA1: 100; 0603-RES
RHYSA2: 10k; 0603-RES
RHYSB1: 100; 0603-RES
RHYSB2: 10k; 0603-RES
RLA: 100k; 0603-RES
RLB: 100k; 0603-RES
RLEDA-B: 270; 0603-RES
RLEDB-A: 270; 0603-RES
RLEDV+: 270; 0603-RES
RLEDV-: 270; 0603-RES
ROUTA1: 10k; 0603-RES
ROUTA2: 20k; 0603-RES
ROUTB1: 10k; 0603-RES
ROUTB2: 20k; 0603-RES
RR1+, RR1-: 31.6k; 0603-RES
RR2+, RR2-: 10k; 0603-RES
RREF1, RREF2: 100; 0603-RES
RSA: 0; 0603-RES
RSB: 0; 0603-RES
SJ1, SJ2, SJ3, SJ4, SJ5, SJ6, SJ7, SJ8, SJ9, SJ11: SOLDERJUMPERNC; SJ_2S
U1: TPS7A4901NO_PAD; MSOP8
U2: TPS7A3001NO_PAD; MSOP8
U3: OPA2380; MSOP8
U4: INA2143; SOIC14
U5: TLV3502; SOIC8

Connections:
!CMP_A-B!: JOUT.3, RLEDA-B.1, ROUTB1.2, ROUTB2.2
!CMP_B-A!: JOUT.1, RLEDB-A.1, ROUTA1.2, ROUTA2.2
+5V: CBYP_U3.1, CBYP_U4+.1, CBYP_U5-1.1, CBYP_U5-2.1, JP+5V.1, LEDA-B.A, LEDB-A.A, LEDV+.A, RREF1.1, U3.8 (V+), U4.11 (V+), U5.8 (V+)
-5V: CBYP_U4-.2, JP-5V.1, LEDV-.C, PHA1.A, PHA2.A, PHA3.A, PHB1.A, PHB2.A, PHB3.A, U4.4 (V-)
AGND: CBYP_U3.2, CBYP_U4+.2, CBYP_U4-.1, CBYP_U5-1.2, CBYP_U5-2.2, CFIA.2, CFIB.2, CREF.2, CRIN+.C (-), CRIN-.A (+), CRNR+.2, CRNR-.2, CROUT+.C (-), CROUT-.A (+), JIN.2, JIN.3, JOUT.2, JTAGND.1, JTAGND.2, RLA.1, RLB.1, RLEDV+.1, RLEDV-.2, ROUTA2.1, ROUTB2.1, RR2+.1, RR2-.1, RREF2.1, RSA.1, RSB.1, U1.4 (GND), U2.4 (GND), U3.4 (V-), U4.8 (REF), U4.14 (REF), U5.5 (V-)
unnamed: CRNR+.1, U1.6 (NR/SS)
unnamed: CRBYP-.2, RR1-.1, RR2-.2, U2.2 (FB)
unnamed: CFA.2, RFIA.1, U3.1 (OUT)
unnamed: CRNR-.1, U2.6 (NR/SS)
unnamed: CFA.1, PA.3 (C), PHA3.K, RFA.1, SJ7.2, U3.2 (-IN)
unnamed: CFB.2, RFIB.1, U3.7 (OUT)
unnamed: CRBYP+.2, RR1+.1, RR2+.2, U1.2 (FB)
unnamed: CFB.1, PB.3 (C), PHB1.K, RFB.1, SJ5.2, U3.6 (-IN)
unnamed: SJ2.2, U4.3 (+IN), U4.6 (-IN)
unnamed: RHYSA2.2, ROUTA1.1, U5.7 (OUT)
unnamed: SJ1.2, U4.2 (-IN), U4.5 (+IN)
unnamed: SJ3.2, U5.2 (-IN)
unnamed: SJ4.2, U5.4 (-IN)
unnamed: RHYSA1.2, RHYSA2.1, U5.1 (+IN)
unnamed: RHYSB1.2, RHYSB2.1, U5.3 (+IN)
unnamed: RHYSB2.2, ROUTB1.1, U5.6 (OUT)
unnamed: PREF.1 (A), RREF1.2
unnamed: PREF.3 (C), RREF2.2
unnamed: LEDV+.C, RLEDV+.2
unnamed: LEDV-.A, RLEDV-.1
unnamed: LEDB-A.C, RLEDB-A.2
unnamed: LEDA-B.C, RLEDA-B.2
unnamed: RSA.2, U3.3 (+IN)
unnamed: RSB.2, U3.5 (+IN)
unnamed: PA.1 (A), SJ8.2
unnamed: PHB2.K, SJ5.1, SJ9.2
unnamed: CRBYP+.1, CROUT+.A (+), JP+5V.2, RR1+.2, U1.1 (OUT)
unnamed: PHA2.K, SJ7.1, SJ11.2
unnamed: CRBYP-.1, CROUT-.C (-), JP-5V.2, RR1-.2, U2.1 (OUT)
unnamed: PHA1.K, SJ11.1
unnamed: PHB3.K, SJ9.1
unnamed: PB.1 (A), SJ6.2
SUB_A-B: JTA-B.1, SJ4.1, U4.9 (OUT), U4.10 (SENSE)
SUB_B-A: JTB-A.1, SJ3.1, U4.12 (SENSE), U4.13 (OUT)
TI_A: CFIA.1, JTTIA.1, PA.2 (B), RFA.2, RFIA.2, RLA.2, SJ1.1, SJ8.1
TI_B: CFIB.1, JTTIB.1, PB.2 (B), RFB.2, RFIB.2, RLB.2, SJ2.1, SJ6.1
VIN+: CRIN+.A (+), JIN.1, U1.5 (EN), U1.8 (IN)
VIN-: CRIN-.C (-), JIN.4, U2.5 (EN), U2.8 (IN)
VREF: CREF.1, JTVREF.1, PREF.2 (B), RHYSA1.1, RHYSB1.1

Notes on the sheet:
Vout / (R1+R2) > 5uA
R1 = R2 . [(Vout/Vref) - 1]
Vref+ = +1.194V +/- 18mV
Vref- = -1.184V +/- 18mV
Only one PHA to solder
Only one PHB to solder
VHyst = (V+ . RHYS1) / (RHYS1 + RHYS2) + 6mV
Optionnal
VRef = 5V . [(RREF1 + P.PREF) / (RREF1 + RREF2 + PREF)]
0 < P < 1
3V3 output sweep
VHyst = 55mV
Low-Noise power regulation
Analog chain
Connectors
Testpoints
Bypass capacitors
1.0
Paul M.
9mV < VRef < 4.95V
IGrebot 2013
Beacon V3.0
LEDs
PhotoDaughter Board
JP+/-5V for current meas or supplies bypass
fcref ~ 1/[2.PI.(P.PREF).CREF]
fcref = 7Hz with P=0.5

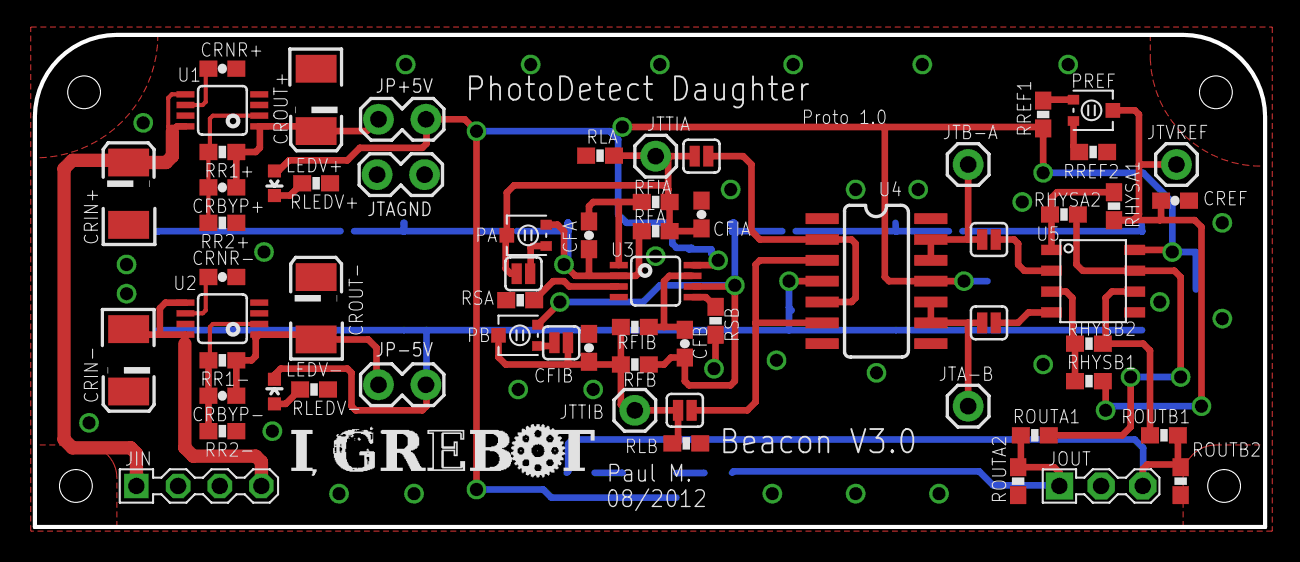
[picture p139: board Rolab_PDD_prot.brd from above]

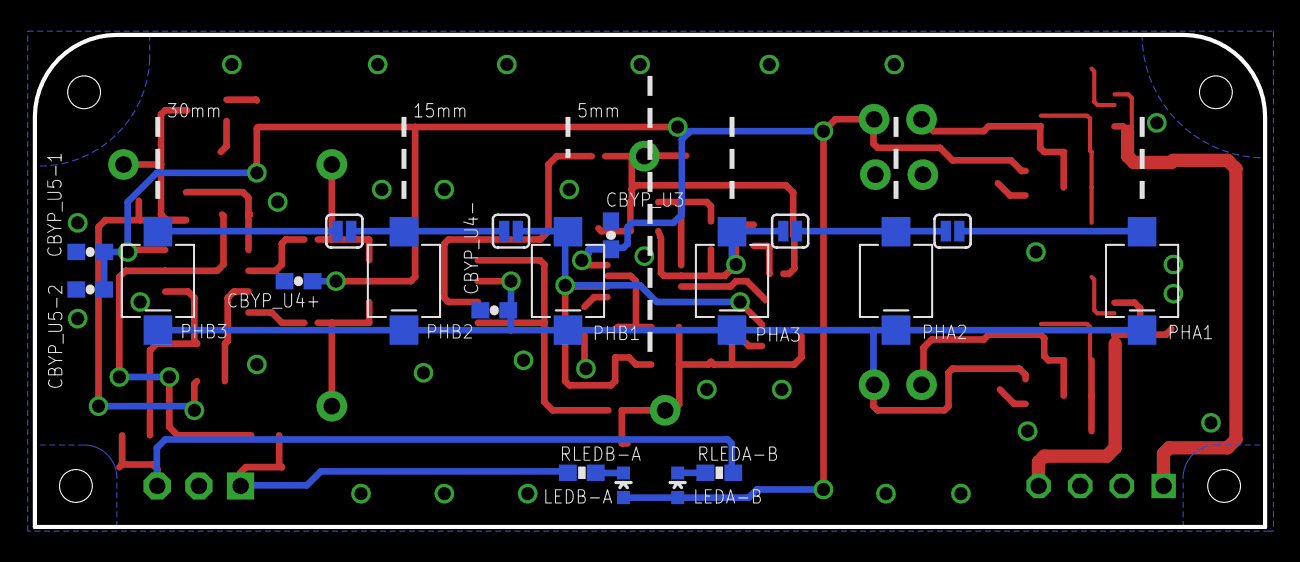
[picture p140: board Rolab_PDD_prot.brd from below]

Board: 2 copper layers, 75.0 x 30.0 mm, 82 parts (19 on the bottom side), 44 nets.
