I-Grebot/Laser_Beacon_V3.0/Electronics/Panels/Panel1/Sources/BRX_pan.brd

## EAGLE design Electronics/Panels/Panel1/Sources/BRX_pan.brd (2016-11-03)

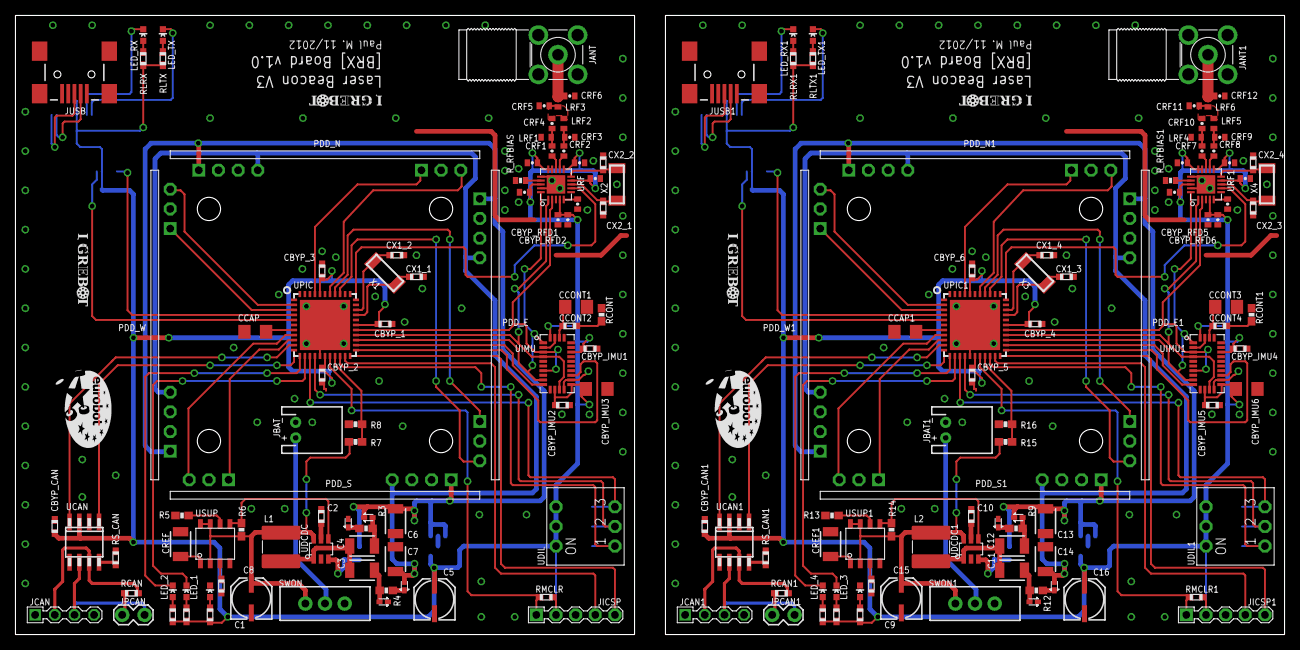
[picture p141: board BRX_pan.brd from above]

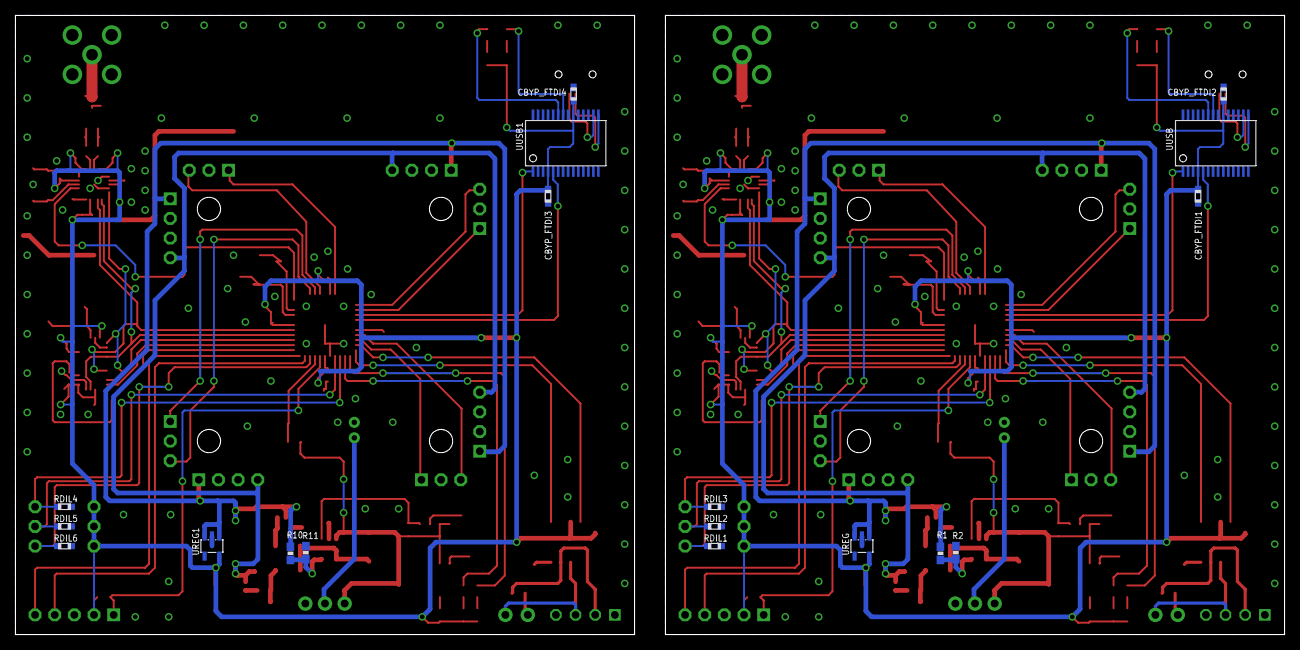
[picture p142: board BRX_pan.brd from below]

Board: 2 copper layers, 164.0 x 80.0 mm, 194 parts (18 on the bottom side), 144 nets.

Parts:
C1, C9: 4.7uF; PANASONIC_C
C2, C10: 47nF_16V; R0603
C3, C4, C11, C12: 1uF_16V; 1210
C5, C16: 10uF; PANASONIC_C
C6, C7, C13, C14: 2.2uF_16V; 1210
C8, C15: 470nF; R0603
CBYP_1, CBYP_2, CBYP_3, CBYP_4, CBYP_5, CBYP_6: 100nF_6.3V; R0603
CBYP_CAN, CBYP_CAN1: 100nF_6.3V; R0603
CBYP_FTDI1, CBYP_FTDI2, CBYP_FTDI3, CBYP_FTDI4: 100nF_6.3V; R0603
CBYP_IMU1, CBYP_IMU2, CBYP_IMU4, CBYP_IMU5: 100nF_6.3V; R0603
CBYP_IMU3, CBYP_IMU6: 10uF_6.3V; 1206
CBYP_RFA1, CBYP_RFA2, CBYP_RFA5, CBYP_RFA6: 100nF_X5R; 0402-CAP
CBYP_RFA3, CBYP_RFA4, CBYP_RFA7, CBYP_RFA8: 220pF_X7R; 0402-CAP
CBYP_RFD1, CBYP_RFD3, CBYP_RFD4, CBYP_RFD5: 100nF_X5R; 0402-CAP
CBYP_RFD2, CBYP_RFD6: 220pF_X7R; 0402-CAP
CCAP, CCAP1: 10uF_6.3V; 1206
CCONT1, CCONT3: 10nF; 1206
CCONT2, CCONT4: 470nF; R0603
CREF, CREF1: 1uF; 1210
CRF1, CRF2, CRF7, CRF8: 100pF_NP0; 0402-CAP
CRF3, CRF4, CRF9, CRF10: 1.0pF_NP0; 0402-CAP
CRF5, CRF11: 1.8pF_NP0; 0402-CAP
CRF6, CRF12: 1.5pF_NP0; 0402-CAP
CX1_1, CX1_2, CX1_3, CX1_4, CX2_1, CX2_2, CX2_3, CX2_4: 22pF_6.3V; R0603
D1, D2, D3, D4, D5, D6, D7, D8: PMEG2005; SOD-523
JANT, JANT1: ENG_CD_1814400_C1; SMA-PCB-ANGLE
JBAT, JBAT1: JST-2-PTH
JCAN, JCAN1: SIL4; CON4-2.54
JICSP, JICSP1: SIL5; CON5-2.54
JPCAN, JPCAN1: 1X02_LOCK
JUSB, JUSB1: USBSMD; USB-MINIB
L1, L2: 10uH; L-5X5
LED_1, LED_2, LED_3, LED_4: LED-0603
LED_POW, LED_POW1: LED-0603
LED_RX, LED_RX1: LED-0603
LED_TX, LED_TX1: LED-0603
LRF1, LRF2, LRF3, LRF4, LRF5, LRF6: 1.2nH; C0402
PDD_E, PDD_E1: PDD_BOARD; PDD_SOCKET
PDD_N, PDD_N1: PDD_BOARD; PDD_SOCKET
PDD_S, PDD_S1: PDD_BOARD; PDD_SOCKET
PDD_W, PDD_W1: PDD_BOARD; PDD_SOCKET
R1, R10: 113k; 0603-RES
R2, R11: 13.3k; 0603-RES
R3, R4, R9, R12: 1; 0603-RES
R5, R6, R8, R13, R14, R16: 10k; 0603-RES
R7, R15: 20k; 0603-RES
RCAN, RCAN1: 100; R0603
RCONT, RCONT1: 10k; 0603-RES
RDIL1, RDIL2, RDIL3, RDIL4, RDIL5, RDIL6: 10k; R0603
RL1, RL2, RL3, RL4: 270; R0603
RLPOW, RLPOW1: 270; R0603
RLRX, RLRX1: 270; R0603
RLTX, RLTX1: 270; R0603
RMCLR, RMCLR1: 4.7k; R0603
RS_CAN, RS_CAN1: 10k; R0603
R_RFBIAS, R_RFBIAS1: 56k; 0402-RES
SWON, SWON1: SWITCH-SPDT
U$1, U$4, U$5, U$9: LOGOIGREBOT; LOGO_IGREBOT
U$2, U$3: LOGOEUROBOT; LOGO_EUROBOT_1
UCAN, UCAN1: MCP2551; SO-08
UDCDC, UDCDC1: LT3467A; TSOT-23
UDIL, UDIL1: A6E-3104; SW_DIP-3
UIMU, UIMU1: LSM330DL; LLGA-28
UPIC, UPIC1: DSPIC33FJ128MC804_QFN; QFN44-8X8
UREG, UREG1: MCP1801; SOT23-5L
URF, URF1: CC2500; QFN20-0.5
USUP, USUP1: TL7709AC; SOIC8
UUSB, UUSB1: FT232RL-BASICSSOP; SSOP28DB
X1, X3: 8MHz; XTAL_4.9-1.8
X2, X4: 26MHz; XTAL_4.9-1.8

Connections:
3.3V: C5.+, CBYP_1.1, CBYP_2.1, CBYP_3.1, CBYP_CAN.1, CBYP_FTDI1.1, CBYP_FTDI2.1, CBYP_IMU1.1, CBYP_IMU2.1, CBYP_IMU3.1, CBYP_RFA1.2, CBYP_RFA2.2, CBYP_RFA3.2, CBYP_RFA4.2, CBYP_RFD1.2, CBYP_RFD2.2, JICSP.2, RL1.1, RL2.1, RLPOW.1, RLRX.1, RLTX.1, RMCLR.1, UCAN.3, UDIL.1A, UDIL.2A, UDIL.3A, UIMU.12, UIMU.15, UIMU.22, UIMU.28, UPIC.P$17, UPIC.P$28, UPIC.P$40, UREG.5, URF.4, URF.9, URF.11, URF.14, URF.15, URF.18, UUSB.4, UUSB.20
3.3V1: C16.+, CBYP_4.1, CBYP_5.1, CBYP_6.1, CBYP_CAN1.1, CBYP_FTDI3.1, CBYP_FTDI4.1, CBYP_IMU4.1, CBYP_IMU5.1, CBYP_IMU6.1, CBYP_RFA5.2, CBYP_RFA6.2, CBYP_RFA7.2, CBYP_RFA8.2, CBYP_RFD5.2, CBYP_RFD6.2, JICSP1.2, RL3.1, RL4.1, RLPOW1.1, RLRX1.1, RLTX1.1, RMCLR1.1, UCAN1.3, UDIL1.1A, UDIL1.2A, UDIL1.3A, UIMU1.12, UIMU1.15, UIMU1.22, UIMU1.28, UPIC1.P$17, UPIC1.P$28, UPIC1.P$40, UREG1.5, URF1.4, URF1.9, URF1.11, URF1.14, URF1.15, URF1.18, UUSB1.4, UUSB1.20
!CSN!_A: UIMU.17, UPIC.P$23
!CSN!_A1: UIMU1.17, UPIC1.P$23
!CSN!_G: UIMU.10, UPIC.P$24
!CSN!_G1: UIMU1.10, UPIC1.P$24
!CSN!_RF: UPIC.P$33, URF.7
!CSN!_RF1: UPIC1.P$33, URF1.7
!MCLR!: JICSP.1, RMCLR.2, UPIC.P$18
!MCLR!1: JICSP1.1, RMCLR1.2, UPIC1.P$18
!SHDN!: R6.2, UDCDC.4, USUP.5
!SHDN!1: R14.2, UDCDC1.4, USUP1.5
+12V: C6.1, D1.C, PDD_E.1, PDD_N.1, PDD_S.1, PDD_W.1, R1.2, UREG.1, UREG.3
+12V1: C13.1, D5.C, PDD_E1.1, PDD_N1.1, PDD_S1.1, PDD_W1.1, R10.2, UREG1.1, UREG1.3
-12V: C7.1, D4.A, PDD_E.4, PDD_N.4, PDD_S.4, PDD_W.4
-12V1: C14.1, D8.A, PDD_E1.4, PDD_N1.4, PDD_S1.4, PDD_W1.4
CANH: JCAN.2, RCAN.1, UCAN.7
CANH1: JCAN1.2, RCAN1.1, UCAN1.7
CANL: JCAN.3, JPCAN.2, UCAN.6
CANL1: JCAN1.3, JPCAN1.2, UCAN1.6
CAN_RX: UCAN.4, UPIC.P$10
CAN_RX1: UCAN1.4, UPIC1.P$10
CAN_TX: UCAN.1, UPIC.P$11
CAN_TX1: UCAN1.1, UPIC1.P$11
DIL1: RDIL1.1, UDIL.1B, UPIC.P$20
DIL2: RDIL2.1, UDIL.2B, UPIC.P$15
DIL3: RDIL3.1, UDIL.3B, UPIC.P$14
DIL4: RDIL4.1, UDIL1.3B, UPIC1.P$14
DIL5: RDIL5.1, UDIL1.2B, UPIC1.P$15
DIL6: RDIL6.1, UDIL1.1B, UPIC1.P$20
E_!A-B!: PDD_E.5, UPIC.P$37
E_!A-B!1: PDD_E1.5, UPIC1.P$37
E_!B-A!: PDD_E.7, UPIC.P$36
E_!B-A!1: PDD_E1.7, UPIC1.P$36
GND: C1.-, C2.2, C5.-, C6.2, C7.2, C8.2, CBYP_1.2, CBYP_2.2, CBYP_3.2, CBYP_CAN.2, CBYP_FTDI1.2, CBYP_FTDI2.2, CBYP_IMU1.2, CBYP_IMU2.2, CBYP_IMU3.2, CBYP_RFA1.1, CBYP_RFA2.1, CBYP_RFA3.1, CBYP_RFA4.1, CBYP_RFD1.1, CBYP_RFD2.1, CBYP_RFD3.1, CCAP.2, CCONT1.2, CREF.1, CRF3.1, CRF5.1, CRF6.1, CX1_1.2, CX1_2.2, CX2_1.2, CX2_2.2, D2.A, D3.C, JANT.B1, JANT.B2, JANT.B3, JANT.B4, JBAT.1, JCAN.1, JCAN.4, JICSP.3, JUSB.GND, LED_POW.C, LRF1.1, PDD_E.2, PDD_E.3, PDD_E.6, PDD_N.2, PDD_N.3, PDD_N.6, PDD_S.2, PDD_S.3, PDD_S.6, PDD_W.2, PDD_W.3, PDD_W.6, R2.1, R5.1, R8.1, RCONT.1, RDIL1.2, RDIL2.2, RDIL3.2, RS_CAN.1, R_RFBIAS.2, UCAN.2, UDCDC.2, UIMU.2, UIMU.11, UIMU.14, UIMU.16, UIMU.18, UIMU.19, UIMU.20, UIMU.23, UIMU.24, UIMU.25, UIMU.27, UPIC.P$6, UPIC.P$16, UPIC.P$29, UPIC.P$39, UPIC.PAD, UREG.2, URF.16, URF.19, URF.PAD, USUP.4, UUSB.7, UUSB.18, UUSB.21, UUSB.25, UUSB.26
GND1: C9.-, C10.2, C13.2, C14.2, C15.2, C16.-, CBYP_4.2, CBYP_5.2, CBYP_6.2, CBYP_CAN1.2, CBYP_FTDI3.2, CBYP_FTDI4.2, CBYP_IMU4.2, CBYP_IMU5.2, CBYP_IMU6.2, CBYP_RFA5.1, CBYP_RFA6.1, CBYP_RFA7.1, CBYP_RFA8.1, CBYP_RFD4.1, CBYP_RFD5.1, CBYP_RFD6.1, CCAP1.2, CCONT3.2, CREF1.1, CRF9.1, CRF11.1, CRF12.1, CX1_3.2, CX1_4.2, CX2_3.2, CX2_4.2, D6.A, D7.C, JANT1.B1, JANT1.B2, JANT1.B3, JANT1.B4, JBAT1.1, JCAN1.1, JCAN1.4, JICSP1.3, JUSB1.GND, LED_POW1.C, LRF4.1, PDD_E1.2, PDD_E1.3, PDD_E1.6, PDD_N1.2, PDD_N1.3, PDD_N1.6, PDD_S1.2, PDD_S1.3, PDD_S1.6, PDD_W1.2, PDD_W1.3, PDD_W1.6, R11.1, R13.1, R16.1, RCONT1.1, RDIL4.2, RDIL5.2, RDIL6.2, RS_CAN1.1, R_RFBIAS1.2, UCAN1.2, UDCDC1.2, UIMU1.2, UIMU1.11, UIMU1.14, UIMU1.16, UIMU1.18, UIMU1.19, UIMU1.20, UIMU1.23, UIMU1.24, UIMU1.25, UIMU1.27, UPIC1.P$6, UPIC1.P$16, UPIC1.P$29, UPIC1.P$39, UPIC1.PAD, UREG1.2, URF1.16, URF1.19, URF1.PAD, USUP1.4, UUSB1.7, UUSB1.18, UUSB1.21, UUSB1.25, UUSB1.26
LED_1: LED_1.C, UPIC.P$13
LED_2: LED_2.C, UPIC.P$12
LED_3: LED_3.C, UPIC1.P$13
LED_4: LED_4.C, UPIC1.P$12
LED_RX: LED_RX.C, UUSB.22
LED_RX1: LED_RX1.C, UUSB1.22
LED_TX: LED_TX.C, UUSB.23
LED_TX1: LED_TX1.C, UUSB1.23
MISO: UIMU.3, UIMU.7, UPIC.P$27, URF.2
MISO1: UIMU1.3, UIMU1.7, UPIC1.P$27, URF1.2
MOSI: UIMU.1, UIMU.9, UPIC.P$25, URF.20
MOSI1: UIMU1.1, UIMU1.9, UPIC1.P$25, URF1.20
unnamed: CRF1.2, CRF4.2, LRF1.2
unnamed: LED_TX.A, RLTX.2
unnamed: CRF2.2, CRF3.2, LRF2.1
unnamed: CRF4.1, CRF5.2, LRF2.2, LRF3.1
unnamed: RS_CAN.2, UCAN.8
unnamed: JPCAN.1, RCAN.2
unnamed: CRF6.2, JANT.A, LRF3.2
unnamed: LED_RX.A, RLRX.2
unnamed: LED_1.A, RL1.2
unnamed: LED_2.A, RL2.2
unnamed: C2.1, UDCDC.5
unnamed: JBAT.2, SWON.2
unnamed: C3.1, C4.1, L1.2, UDCDC.1
unnamed: C3.2, D3.A, R4.2
unnamed: D2.C, R3.1
unnamed: C4.2, D1.A, R3.2
unnamed: R5.2, USUP.6
unnamed: R1.1, R2.2, UDCDC.3
unnamed: D4.C, R4.1
unnamed: CCONT2.2, RCONT.2
unnamed: LED_POW.A, RLPOW.2
unnamed: RS_CAN1.2, UCAN1.8
unnamed: CRF7.2, CRF10.2, LRF4.2
unnamed: CRF8.2, CRF9.2, LRF5.1
unnamed: CRF10.1, CRF11.2, LRF5.2, LRF6.1
unnamed: CRF12.2, JANT1.A, LRF6.2
unnamed: JPCAN1.1, RCAN1.2
unnamed: LED_TX1.A, RLTX1.2
unnamed: LED_RX1.A, RLRX1.2
unnamed: LED_3.A, RL3.2
unnamed: LED_4.A, RL4.2
unnamed: C11.1, C12.1, L2.2, UDCDC1.1
unnamed: C10.1, UDCDC1.5
unnamed: D6.C, R9.1
unnamed: C12.2, D5.A, R9.2
unnamed: D8.C, R12.1
unnamed: C11.2, D7.A, R12.2
unnamed: R10.1, R11.2, UDCDC1.3
unnamed: R13.2, USUP1.6
unnamed: JBAT1.2, SWON1.2
unnamed: CCONT4.2, RCONT1.2
unnamed: LED_POW1.A, RLPOW1.2
N_!A-B!: PDD_N.5, UPIC.P$41
N_!A-B!1: PDD_N1.5, UPIC1.P$41
N_!B-A!: PDD_N.7, UPIC.P$38
N_!B-A!1: PDD_N1.7, UPIC1.P$38
PGC: JICSP.5, UPIC.P$22
PGC1: JICSP1.5, UPIC1.P$22
PGD: JICSP.4, UPIC.P$21
PGD1: JICSP1.4, UPIC1.P$21
RF_N: CRF1.1, URF.13
RF_N1: CRF7.1, URF1.13
RF_P: CRF2.1, URF.12
RF_P1: CRF8.1, URF1.12
R_RFBIAS: R_RFBIAS.1, URF.17
R_RFBIAS1: R_RFBIAS1.1, URF1.17
SCLK: UIMU.4, UIMU.13, UPIC.P$26, URF.1
SCLK1: UIMU1.4, UIMU1.13, UPIC1.P$26, URF1.1
SENSE_BAT: R7.2, R8.2, UPIC.P$19
SENSE_BAT1: R15.2, R16.2, UPIC1.P$19
S_!A-B!: PDD_S.5, UPIC.P$9
S_!A-B!1: PDD_S1.5, UPIC1.P$9
S_!B-A!: PDD_S.7, UPIC.P$8
S_!B-A!1: PDD_S1.7, UPIC1.P$8
USBDM: JUSB.D-, UUSB.16
USBDM1: JUSB1.D-, UUSB1.16
USBDP: JUSB.D+, UUSB.15
USBDP1: JUSB1.D+, UUSB1.15
USB_RX: UPIC.P$5, UUSB.5
USB_RX1: UPIC1.P$5, UUSB1.5
USB_TX: UPIC.P$4, UUSB.1
USB_TX1: UPIC1.P$4, UUSB1.1
VBAT: C1.+, L1.1, R6.1, R7.1, SWON.1, UDCDC.6, USUP.2, USUP.7, USUP.8
VBAT1: C9.+, L2.1, R14.1, R15.1, SWON1.1, UDCDC1.6, USUP1.2, USUP1.7, USUP1.8
VCAP: CCAP.1, UPIC.P$7
VCAP1: CCAP1.1, UPIC1.P$7
VCONT: CCONT1.1, CCONT2.1, UIMU.26
VCONT1: CCONT3.1, CCONT4.1, UIMU1.26
VCT: C8.1, USUP.3
VCT1: C15.1, USUP1.3
VDCOUPL: CBYP_RFD3.2, URF.5
VDCOUPL1: CBYP_RFD4.2, URF1.5
VREF: CREF.2, USUP.1
VREF1: CREF1.2, USUP1.1
W_!A-B!: PDD_W.5, UPIC.P$3
W_!A-B!1: PDD_W1.5, UPIC1.P$3
W_!B-A!: PDD_W.7, UPIC.P$2
W_!B-A!1: PDD_W1.7, UPIC1.P$2
X1_OSC1: CX1_1.1, UPIC.P$30, X1.P$1
X1_OSC2: CX1_2.1, UPIC.P$31, X1.P$2
X1_OSC3: CX1_3.1, UPIC1.P$30, X3.P$1
X1_OSC4: CX1_4.1, UPIC1.P$31, X3.P$2
X2_OSC1: CX2_1.1, URF.8, X2.P$1
X2_OSC2: CX2_2.1, URF.10, X2.P$2
X2_OSC3: CX2_3.1, URF1.8, X4.P$1
X2_OSC4: CX2_4.1, URF1.10, X4.P$2
