I-Grebot/Laser_Beacon_V3.0/Electronics/Panels/Panel2/Sources/Panel2.brd

## EAGLE design Electronics/Panels/Panel2/Sources/Panel2.brd (2016-11-03)

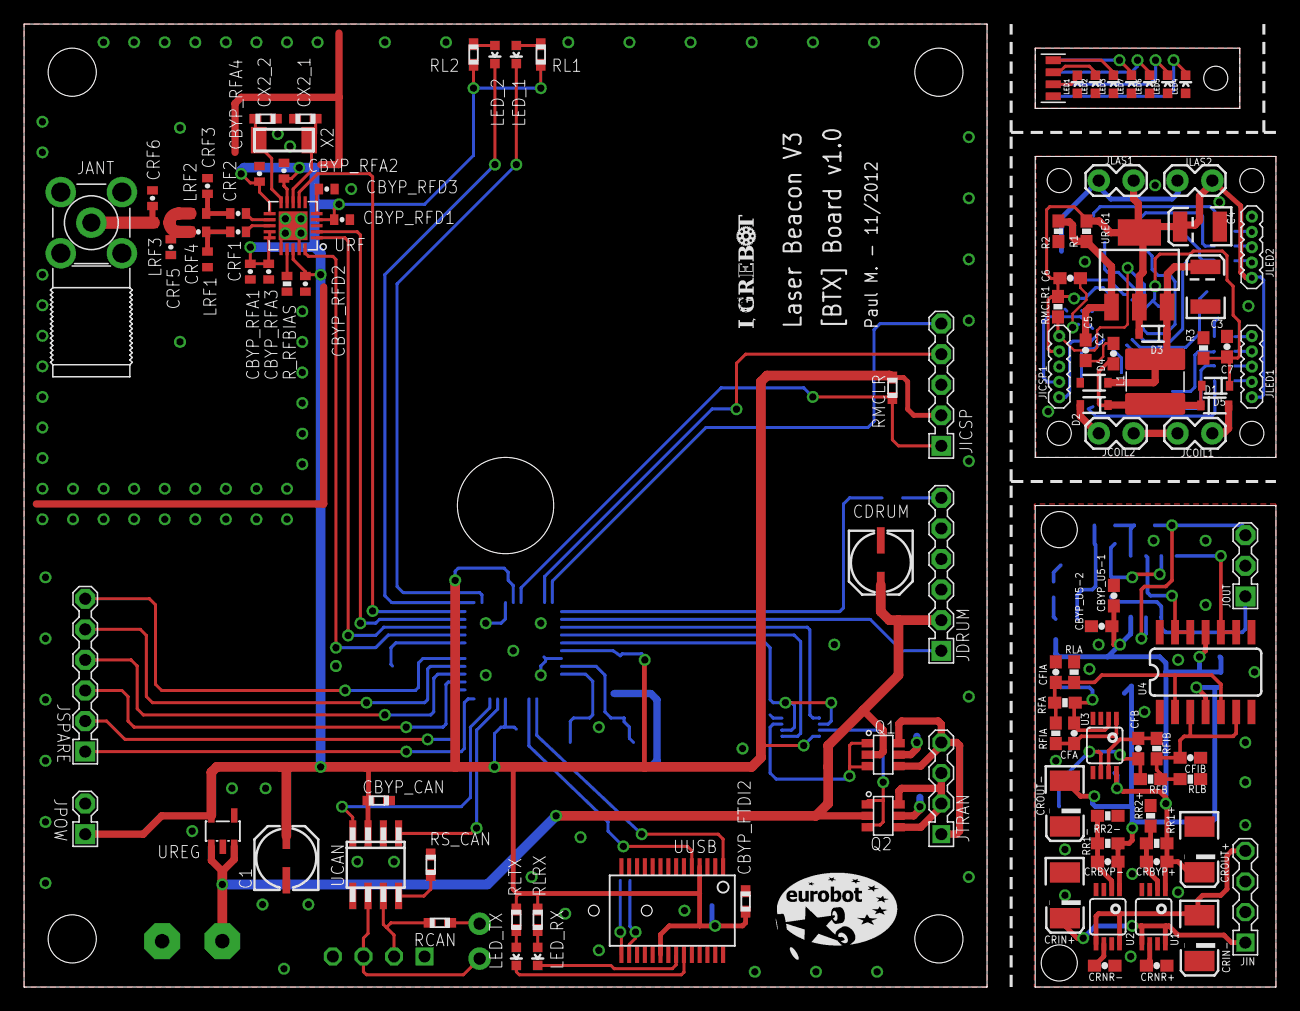
[picture p143: board Panel2.brd from above]

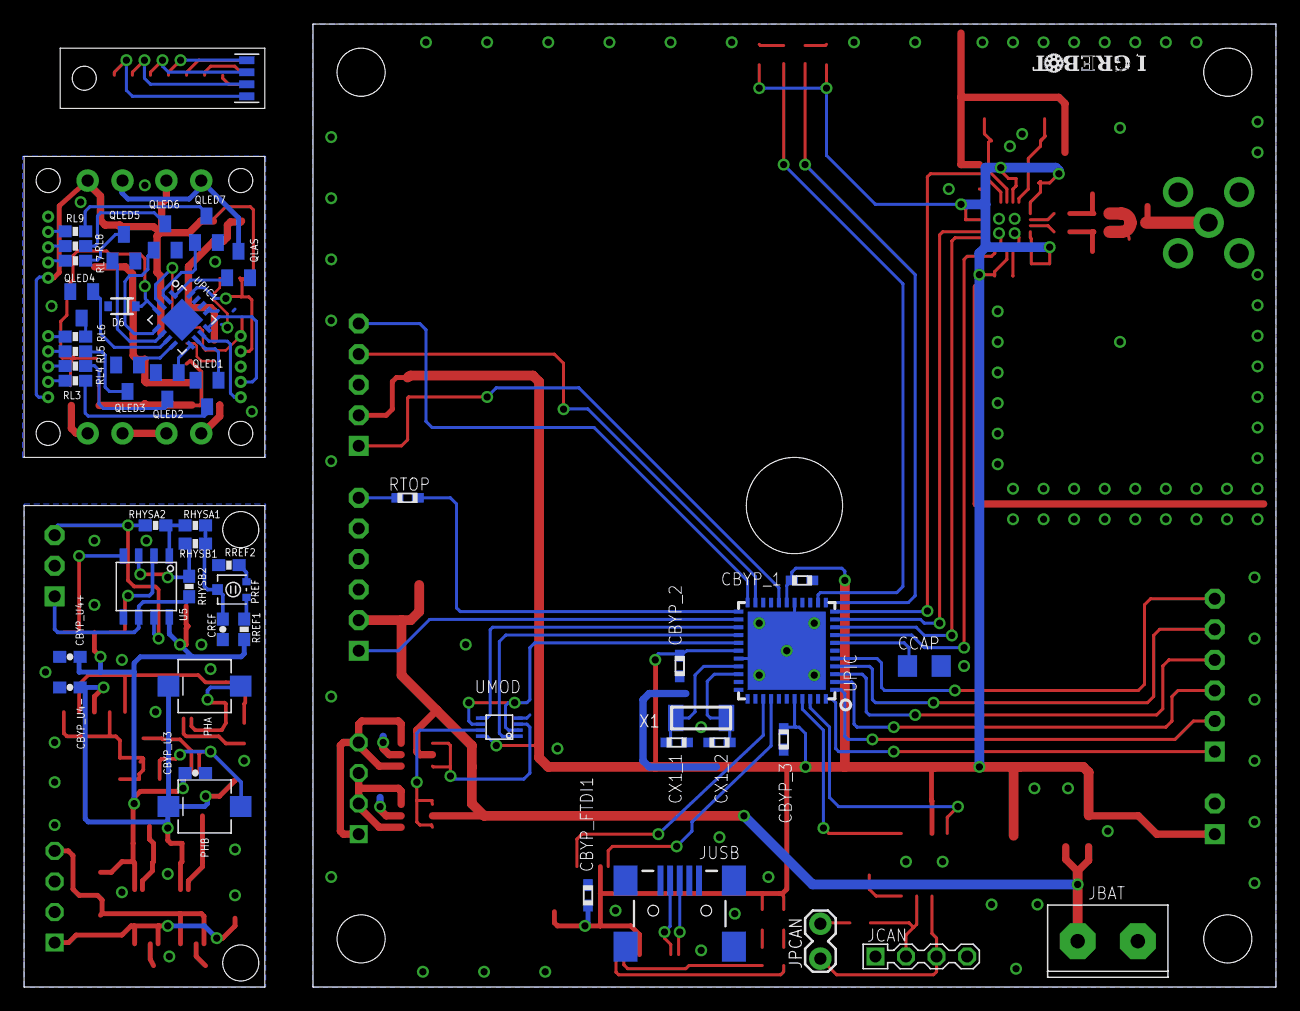
[picture p144: board Panel2.brd from below]

Board: 2 copper layers, 104.0 x 80.0 mm, 158 parts (47 on the bottom side), 123 nets.

Parts:
C1: 10uF; PANASONIC_C
C2, C5, C6: 100nF; 0603-CAP
C3, C4: 10uF; EIA3528
C7: 1nF; 0603-CAP
CBYP_1, CBYP_2, CBYP_3: 100nF_6.3V; R0603
CBYP_CAN: 100nF_6.3V; R0603
CBYP_FTDI1, CBYP_FTDI2: 100nF_6.3V; R0603
CBYP_RFA1, CBYP_RFA2: 100nF_X5R; 0402-CAP
CBYP_RFA3, CBYP_RFA4: 220pF_X7R; 0402-CAP
CBYP_RFD1, CBYP_RFD3: 100nF_X5R; 0402-CAP
CBYP_RFD2: 220pF_X7R; 0402-CAP
CBYP_U3, CBYP_U4+, CBYP_U4-, CBYP_U5-1: 1uF; 0603-CAP
CBYP_U5-2: 100nF; 0603-CAP
CCAP: 10uF_6.3V; 1206
CDRUM: 10uF; PANASONIC_C
CFA: 33pF; 0603-CAP
CFB: 33pF; 0603-CAP
CFIA: 100nF; 0603-CAP
CFIB: 100nF; 0603-CAP
CRBYP+: 10nF; 0603-CAP
CRBYP-: 10nF; 0603-CAP
CREF: 470nF; 0603-CAP
CRF1, CRF2: 100pF_NP0; 0402-CAP
CRF3, CRF4: 1.0pF_NP0; 0402-CAP
CRF5: 1.8pF_NP0; 0402-CAP
CRF6: 1.5pF_NP0; 0402-CAP
CRIN+: 10uF; EIA3528-KIT
CRIN-: 10uF; EIA3528-KIT
CRNR+: 10nF; 0603-CAP
CRNR-: 10nF; 0603-CAP
CROUT+: 10uF; EIA3528-KIT
CROUT-: 10uF; EIA3528-KIT
CX1_1, CX1_2, CX2_1, CX2_2: 22pF_6.3V; R0603
D1, D2: PMEG4005AEA; SOD-323
D3: 1N4002; SOD-323
D4, D5: PDZ15B-115; SOD-323
D6: SOD-323
JANT: ENG_CD_1814400_C1; SMA-PCB-ANGLE
JBAT: MULTICOMP_PA001-2; CON2-5.00
JCAN: SIL4; CON4-2.54
JCOIL1, JCOIL2: 1X02_LOCK
JDRUM: SIL6; CON6-2.54
JICSP: SIL5; CON5-2.54
JICSP1: 1X05-1.27MM
JIN: SIL4; CON4-2.54
JLAS1, JLAS2: 1X02_LOCK
JLED: CON8_SMD-1; CON8-SMD-1
JLED1, JLED2: 1X05-1.27MM
JOUT: SIL3; CON3-2.54
JPCAN: 1X02_LOCK
JPOW: SIL2; CON2-2.54
JSPARE: SIL6; CON6-2.54
JTRAN: SIL4; CON4-2.54
JUSB: USBSMD; USB-MINIB
L1: 220uF; L-5X5
LED1, LED2, LED3, LED4, LED5, LED6, LED7: LED-0603
LED_1, LED_2: LED-0603
LED_RX: LED-0603
LED_TX: LED-0603
LRF1, LRF2, LRF3: 1.2nH; C0402
PHA: VBPW34SR
PHB: VBPW34SR
PREF: 100k; TRIM-PVZ2A
Q1, Q2: FDC6333C; SSOT6
QLAS: BSS138; SOT23
QLED1, QLED2, QLED3, QLED4, QLED5, QLED6, QLED7: BSS138; SOT23
R1, R3: 10k; 0603-RES
R2: 14k; 0603-RES
RCAN: 100; R0603
RFA: 20k; 0603-RES
RFB: 20k; 0603-RES
RFIA: 100; 0603-RES
RFIB: 100; 0603-RES
RHYSA1: 100; 0603-RES
RHYSA2: 10k; 0603-RES
RHYSB1: 100; 0603-RES
RHYSB2: 10k; 0603-RES
RL1, RL2: 270; R0603
RL3, RL4, RL5, RL6, RL7, RL8, RL9: 270; 0603-RES
RLA: 100k; 0603-RES
RLB: 100k; 0603-RES
RLRX: 270; R0603
RLTX: 270; R0603
RMCLR: 4.7k; R0603
RMCLR1: 4.7k; 0603-RES
RR1+, RR1-: 31.6k; 0603-RES
RR2+, RR2-: 10k; 0603-RES
RREF1, RREF2: 100; 0603-RES
RS_CAN: 10k; R0603
RTOP: 100; R0603
R_RFBIAS: 56k; 0402-RES
U1: TPS7A4901NO_PAD; MSOP8
U2: TPS7A3001NO_PAD; MSOP8
U3: OPA2380; MSOP8
U4: INA2143; SOIC14
U5: TLV3502; SOIC8
U$3: LOGOEUROBOT; LOGO_EUROBOT_1
U$5, U$9: LOGOIGREBOT; LOGO_IGREBOT
UCAN: MCP2551; SO-08
UMOD: SN74LVC2G08DCU; DCU8
UPIC: DSPIC33FJ128MC804_QFN; QFN44-8X8
UPIC1: PIC16F1825; QFN16-0.65
UREG: MCP1801; SOT23-5L
UREG1: TLV1117; SOT223
URF: CC2500; QFN20-0.5
UUSB: FT232RL-BASICSSOP; SSOP28DB
X1: 8MHz; XTAL_4.9-1.8
X2: 26MHz; XTAL_4.9-1.8

Connections:
3.3V: C1.+, CBYP_1.1, CBYP_2.1, CBYP_3.1, CBYP_CAN.1, CBYP_FTDI1.1, CBYP_FTDI2.1, CBYP_RFA1.2, CBYP_RFA2.2, CBYP_RFA3.2, CBYP_RFA4.2, CBYP_RFD1.2, CBYP_RFD2.2, JICSP.2, JPOW.1, RL1.1, RL2.1, RLRX.1, RLTX.1, RMCLR.1, UCAN.3, UMOD.8, UPIC.P$17, UPIC.P$28, UPIC.P$40, UREG.5, URF.4, URF.9, URF.11, URF.14, URF.15, URF.18, UUSB.4, UUSB.20
!CMP_A-B!: JOUT.1, RHYSB2.2, U5.6
!CMP_B-A!: JOUT.3, RHYSA2.2, U5.7
!MCLR!: JICSP.1, RMCLR.2, UPIC.P$18
!MCLR!1: JICSP1.1, RMCLR1.1, UPIC1.3
+3V3: C4.A, C6.1, D3.2, JICSP1.2, JLAS1.1, JLAS2.1, JLED1.1, JLED2.1, R1.2, RMCLR1.2, UPIC1.16, UREG1.2, UREG1.4
+5V: CBYP_U3.1, CBYP_U4+.1, CBYP_U5-1.1, CBYP_U5-2.1, CRBYP+.1, CROUT+.A, RR1+.2, RREF1.1, U1.1, U3.8, U4.11, U5.8
+12V: CDRUM.+, JBAT.1, JDRUM.2, Q1.2, Q2.2, UREG.1, UREG.3
-5V: CBYP_U4-.2, CRBYP-.1, CROUT-.C, PHA.A, PHB.A, RR1-.2, U2.1, U4.4
AGND: CBYP_U3.2, CBYP_U4+.2, CBYP_U4-.1, CBYP_U5-1.2, CBYP_U5-2.2, CFIA.2, CFIB.2, CREF.2, CRIN+.C, CRIN-.A, CRNR+.2, CRNR-.2, CROUT+.C, CROUT-.A, JIN.2, JIN.3, JOUT.2, RLA.1, RLB.1, RR2+.1, RR2-.1, RREF2.1, U1.4, U2.4, U3.3, U3.4, U3.5, U4.8, U4.14, U5.5
CANH: JCAN.2, RCAN.1, UCAN.7
CANL: JCAN.3, JPCAN.2, UCAN.6
CAN_RX: UCAN.4, UPIC.P$42
CAN_TX: UCAN.1, UPIC.P$41
DRUM_PWM: JDRUM.1, UPIC.P$24
DRUM_TOP: RTOP.1, UPIC.P$23
GND: C1.-, CBYP_1.2, CBYP_2.2, CBYP_3.2, CBYP_CAN.2, CBYP_FTDI1.2, CBYP_FTDI2.2, CBYP_RFA1.1, CBYP_RFA2.1, CBYP_RFA3.1, CBYP_RFA4.1, CBYP_RFD1.1, CBYP_RFD2.1, CBYP_RFD3.1, CCAP.2, CDRUM.-, CRF3.1, CRF5.1, CRF6.1, CX1_1.2, CX1_2.2, CX2_1.2, CX2_2.2, JANT.B1, JANT.B2, JANT.B3, JANT.B4, JBAT.2, JCAN.1, JCAN.4, JDRUM.3, JDRUM.5, JICSP.3, JPOW.2, JUSB.GND, LRF1.1, Q1.5, Q2.5, RS_CAN.1, R_RFBIAS.2, UCAN.2, UMOD.4, UPIC.P$6, UPIC.P$16, UPIC.P$29, UPIC.P$39, UPIC.PAD, UREG.2, URF.16, URF.19, URF.PAD, UUSB.7, UUSB.18, UUSB.21, UUSB.25, UUSB.26
GND1: C2.2, C3.C, C4.C, C5.2, C6.2, C7.2, D4.2, D6.2, JCOIL1.2, JCOIL2.2, JICSP1.3, JLED2.5, QLAS.2, QLED1.2, QLED2.2, QLED3.2, QLED4.2, QLED5.2, QLED6.2, QLED7.2, R2.1, R3.1, UPIC1.13
LAS_ON: QLAS.1, UPIC1.1
LAS_POW: JLAS1.2, JLAS2.2, QLAS.3
LED_1: LED_1.C, UPIC.P$13
LED_2: LED_2.C, UPIC.P$12
LED_ON1: QLED1.1, UPIC1.10
LED_ON2: QLED2.1, UPIC1.9
LED_ON3: QLED3.1, UPIC1.8
LED_ON4: QLED4.1, UPIC1.7
LED_ON5: QLED5.1, UPIC1.6
LED_ON6: QLED6.1, UPIC1.5
LED_ON7: QLED7.1, UPIC1.2
LED_POW1: JLED1.2, RL3.2
LED_POW2: JLED1.3, RL4.2
LED_POW3: JLED1.4, RL5.2
LED_POW4: JLED1.5, RL6.2
LED_POW5: JLED2.2, RL7.2
LED_POW6: JLED2.3, RL8.2
LED_POW7: JLED2.4, RL9.2
LED_RX: LED_RX.C, UUSB.22
LED_TX: LED_TX.C, UUSB.23
MOD_N: Q1.1, Q1.3, UMOD.3
MOD_P: Q2.1, Q2.3, UMOD.7
MOD_PWM_N: UMOD.5, UPIC.P$25
MOD_PWM_P: UMOD.1, UPIC.P$26
MOD_TX: UMOD.2, UMOD.6, UPIC.P$27
unnamed: CRF1.2, CRF4.2, LRF1.2
unnamed: LED_TX.A, RLTX.2
unnamed: CRF2.2, CRF3.2, LRF2.1
unnamed: CRF4.1, CRF5.2, LRF2.2, LRF3.1
unnamed: RS_CAN.2, UCAN.8
unnamed: JPCAN.1, RCAN.2
unnamed: CRF6.2, JANT.A, LRF3.2
unnamed: LED_RX.A, RLRX.2
unnamed: LED_1.A, RL1.2
unnamed: LED_2.A, RL2.2
unnamed: D1.2, JCOIL1.1
unnamed: D2.2, JCOIL2.1
unnamed: C5.1, R1.1, R2.2, UREG1.1
unnamed: QLED1.3, RL3.1
unnamed: QLED2.3, RL4.1
unnamed: QLED3.3, RL5.1
unnamed: QLED4.3, RL6.1
unnamed: QLED5.3, RL7.1
unnamed: QLED6.3, RL8.1
unnamed: QLED7.3, RL9.1
unnamed: JLED.2, LED1.C
unnamed: JLED.3, LED2.C
unnamed: JLED.4, LED3.C
unnamed: JLED.5, LED4.C
unnamed: JLED.6, LED5.C
unnamed: JLED.7, LED6.C
unnamed: JLED.8, LED7.C
unnamed: JLED.1, LED1.A, LED2.A, LED3.A, LED4.A, LED5.A, LED6.A, LED7.A
unnamed: CRNR+.1, U1.6
unnamed: CRNR-.1, U2.6
unnamed: CRBYP+.2, RR1+.1, RR2+.2, U1.2
unnamed: CRBYP-.2, RR1-.1, RR2-.2, U2.2
unnamed: CFA.2, RFIA.1, U3.1
unnamed: CFA.1, PHA.K, RFA.1, U3.2
unnamed: CFB.2, RFIB.1, U3.7
unnamed: CFB.1, PHB.K, RFB.1, U3.6
unnamed: RHYSA1.2, RHYSA2.1, U5.1
unnamed: RHYSB1.2, RHYSB2.1, U5.3
unnamed: PREF.1, RREF1.2
unnamed: PREF.3, RREF2.2
PGC: JICSP.5, UPIC.P$22
PGC1: JICSP1.5, UPIC1.11
PGD: JICSP.4, UPIC.P$21
PGD1: JICSP1.4, UPIC1.12
RF_!CSN!: UPIC.P$11, URF.7
RF_MISO: UPIC.P$10, URF.2
RF_MOSI: UPIC.P$8, URF.20
RF_N: CRF1.1, URF.13
RF_P: CRF2.1, URF.12
RF_SCLK: UPIC.P$9, URF.1
RTOP: JDRUM.6, RTOP.2
R_RFBIAS: R_RFBIAS.1, URF.17
SPARE1: JSPARE.1, UPIC.P$44
SPARE2: JSPARE.2, UPIC.P$1
SPARE3: JSPARE.3, UPIC.P$2
SPARE4: JSPARE.4, UPIC.P$3
SPARE5: JSPARE.5, UPIC.P$4
SPARE6: JSPARE.6, UPIC.P$5
SUB_A-B: U4.9, U4.10, U5.4
SUB_B-A: U4.12, U4.13, U5.2
TI_A: CFIA.1, RFA.2, RFIA.2, RLA.2, U4.2, U4.5
TI_B: CFIB.1, RFB.2, RFIB.2, RLB.2, U4.3, U4.6
TRANSF_N: JTRAN.2, JTRAN.3, Q2.4, Q2.6
TRANSF_P: JTRAN.1, JTRAN.4, Q1.4, Q1.6
UART_RX: C7.1, D5.1, D6.1, R3.2, UPIC1.4
USBDM: JUSB.D-, UUSB.16
USBDP: JUSB.D+, UUSB.15
USB_RX: UPIC.P$37, UUSB.5
USB_TX: UPIC.P$36, UUSB.1
VCAP: CCAP.1, UPIC.P$7
VDC: C2.1, D1.1, D2.1, D5.2, L1.1
VDCOUPL: CBYP_RFD3.2, URF.5
VIN: C3.A, D3.1, D4.1, L1.2, UREG1.3
VIN+: CRIN+.A, JIN.1, U1.5, U1.8
VIN-: CRIN-.C, JIN.4, U2.5, U2.8
VREF: CREF.1, PREF.2, RHYSA1.1, RHYSB1.1
X1_OSC1: CX1_1.1, UPIC.P$30, X1.P$1
X1_OSC2: CX1_2.1, UPIC.P$31, X1.P$2
X2_OSC1: CX2_1.1, URF.8, X2.P$1
X2_OSC2: CX2_2.1, URF.10, X2.P$2
