I-Grebot/Laser_Beacon_V3.0/Electronics/Panels/Panel1/Sources/Panel1.brd

## EAGLE design Electronics/Panels/Panel1/Sources/Panel1.brd (2016-11-03)

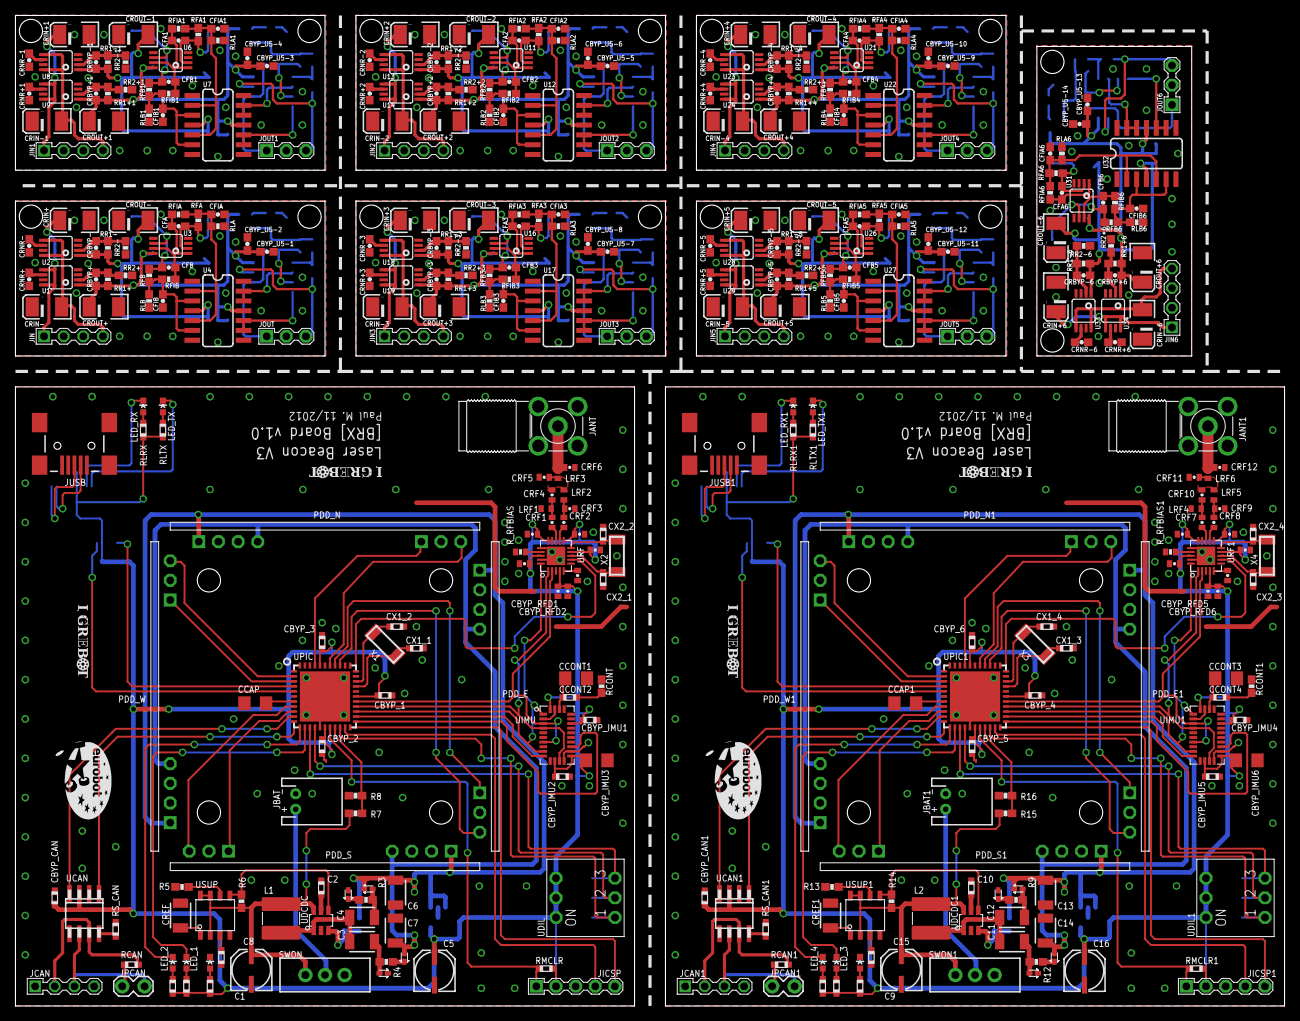
[picture p145: board Panel1.brd from above]

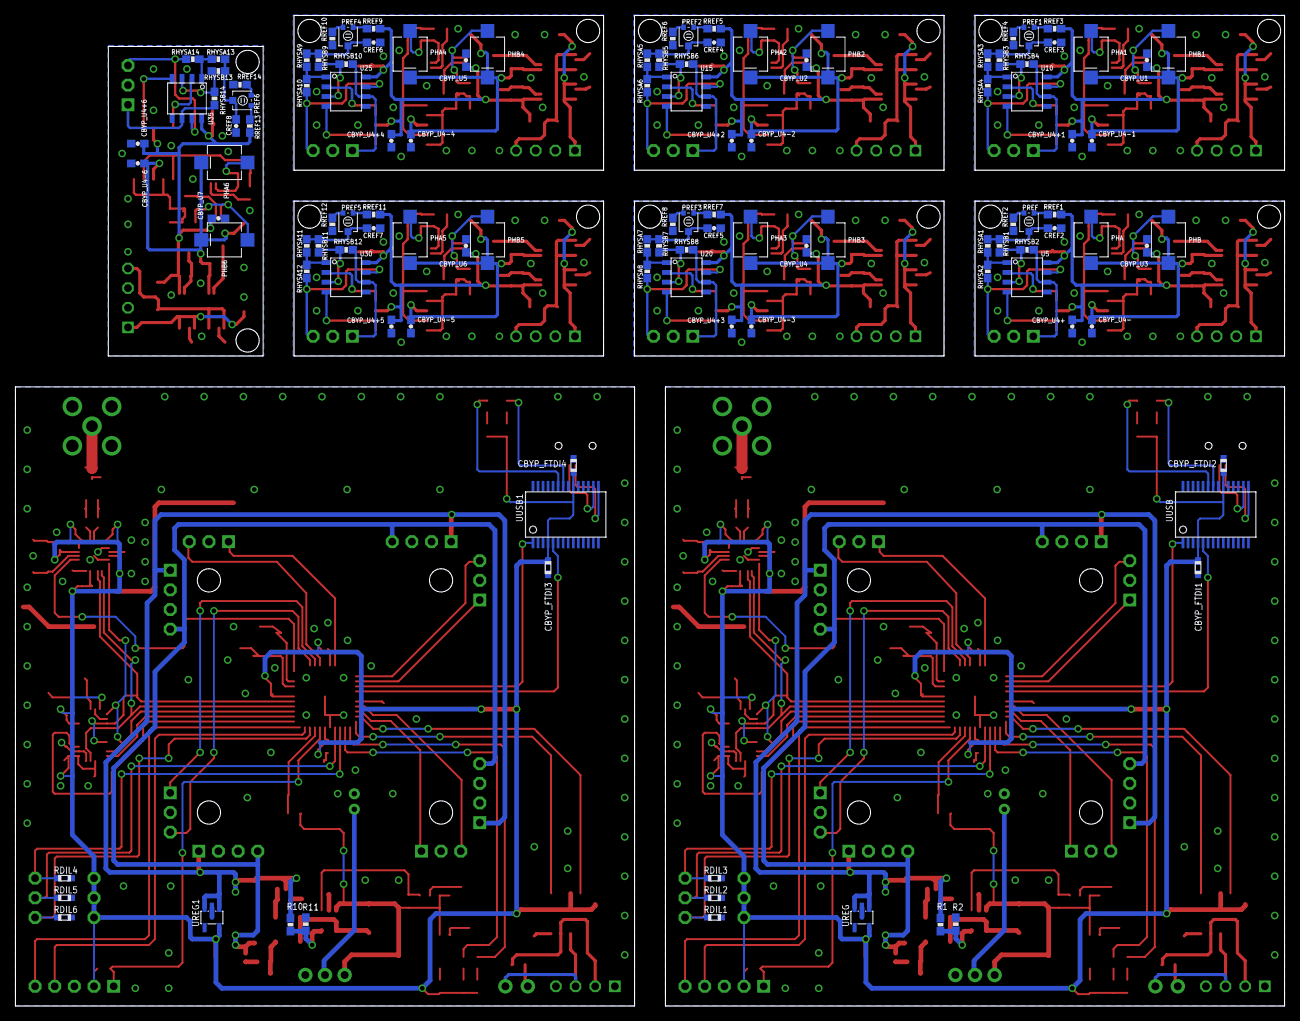
[picture p146: board Panel1.brd from below]

Board: 2 copper layers, 164.0 x 128.0 mm, 502 parts (116 on the bottom side), 312 nets.

Parts:
C1, C9: 4.7uF; PANASONIC_C
C2, C10: 47nF_16V; R0603
C3, C4, C11, C12: 1uF_16V; 1210
C5, C16: 10uF; PANASONIC_C
C6, C7, C13, C14: 2.2uF_16V; 1210
C8, C15: 470nF; R0603
CBYP_1, CBYP_2, CBYP_3, CBYP_4, CBYP_5, CBYP_6: 100nF_6.3V; R0603
CBYP_CAN, CBYP_CAN1: 100nF_6.3V; R0603
CBYP_FTDI1, CBYP_FTDI2, CBYP_FTDI3, CBYP_FTDI4: 100nF_6.3V; R0603
CBYP_IMU1, CBYP_IMU2, CBYP_IMU4, CBYP_IMU5: 100nF_6.3V; R0603
CBYP_IMU3, CBYP_IMU6: 10uF_6.3V; 1206
CBYP_RFA1, CBYP_RFA2, CBYP_RFA5, CBYP_RFA6: 100nF_X5R; 0402-CAP
CBYP_RFA3, CBYP_RFA4, CBYP_RFA7, CBYP_RFA8: 220pF_X7R; 0402-CAP
CBYP_RFD1, CBYP_RFD3, CBYP_RFD4, CBYP_RFD5: 100nF_X5R; 0402-CAP
CBYP_RFD2, CBYP_RFD6: 220pF_X7R; 0402-CAP
CBYP_U1, CBYP_U2, CBYP_U3, CBYP_U4, CBYP_U4+, CBYP_U4+1, CBYP_U4+2, CBYP_U4+3, CBYP_U4+4, CBYP_U4+5, CBYP_U4+6, CBYP_U4-, CBYP_U4-1, CBYP_U4-2, CBYP_U4-3, CBYP_U4-4, CBYP_U4-5, CBYP_U4-6, CBYP_U5, CBYP_U5-1, CBYP_U5-3, CBYP_U5-5, CBYP_U5-7, CBYP_U5-9, CBYP_U5-11, CBYP_U5-13, CBYP_U6, CBYP_U7: 1uF; 0603-CAP
CBYP_U5-2, CBYP_U5-4, CBYP_U5-6, CBYP_U5-8, CBYP_U5-10, CBYP_U5-12, CBYP_U5-14: 100nF; 0603-CAP
CCAP, CCAP1: 10uF_6.3V; 1206
CCONT1, CCONT3: 10nF; 1206
CCONT2, CCONT4: 470nF; R0603
CFA, CFA1, CFA2, CFA3, CFA4, CFA5, CFA6: 33pF; 0603-CAP
CFB, CFB1, CFB2, CFB3, CFB4, CFB5, CFB6: 33pF; 0603-CAP
CFIA, CFIA1, CFIA2, CFIA3, CFIA4, CFIA5, CFIA6: 100nF; 0603-CAP
CFIB, CFIB1, CFIB2, CFIB3, CFIB4, CFIB5, CFIB6: 100nF; 0603-CAP
CRBYP+, CRBYP+1, CRBYP+2, CRBYP+3, CRBYP+4, CRBYP+5, CRBYP+6: 10nF; 0603-CAP
CRBYP-, CRBYP-1, CRBYP-2, CRBYP-3, CRBYP-4, CRBYP-5, CRBYP-6: 10nF; 0603-CAP
CREF, CREF1: 1uF; 1210
CREF2, CREF3, CREF4, CREF5, CREF6, CREF7, CREF8: 470nF; 0603-CAP
CRF1, CRF2, CRF7, CRF8: 100pF_NP0; 0402-CAP
CRF3, CRF4, CRF9, CRF10: 1.0pF_NP0; 0402-CAP
CRF5, CRF11: 1.8pF_NP0; 0402-CAP
CRF6, CRF12: 1.5pF_NP0; 0402-CAP
CRIN+, CRIN+1, CRIN+2, CRIN+3, CRIN+4, CRIN+5, CRIN+6: 10uF; EIA3528-KIT
CRIN-, CRIN-1, CRIN-2, CRIN-3, CRIN-4, CRIN-5, CRIN-6: 10uF; EIA3528-KIT
CRNR+, CRNR+1, CRNR+2, CRNR+3, CRNR+4, CRNR+5, CRNR+6: 10nF; 0603-CAP
CRNR-, CRNR-1, CRNR-2, CRNR-3, CRNR-4, CRNR-5, CRNR-6: 10nF; 0603-CAP
CROUT+, CROUT+1, CROUT+2, CROUT+3, CROUT+4, CROUT+5, CROUT+6: 10uF; EIA3528-KIT
CROUT-, CROUT-1, CROUT-2, CROUT-3, CROUT-4, CROUT-5, CROUT-6: 10uF; EIA3528-KIT
CX1_1, CX1_2, CX1_3, CX1_4, CX2_1, CX2_2, CX2_3, CX2_4: 22pF_6.3V; R0603
D1, D2, D3, D4, D5, D6, D7, D8: PMEG2005; SOD-523
JANT, JANT1: ENG_CD_1814400_C1; SMA-PCB-ANGLE
JBAT, JBAT1: JST-2-PTH
JCAN, JCAN1: SIL4; CON4-2.54
JICSP, JICSP1: SIL5; CON5-2.54
JIN, JIN1, JIN2, JIN3, JIN4, JIN5, JIN6: SIL4; CON4-2.54
JOUT, JOUT1, JOUT2, JOUT3, JOUT4, JOUT5, JOUT6: SIL3; CON3-2.54
JPCAN, JPCAN1: 1X02_LOCK
JUSB, JUSB1: USBSMD; USB-MINIB
L1, L2: 10uH; L-5X5
LED_1, LED_2, LED_3, LED_4: LED-0603
LED_POW, LED_POW1: LED-0603
LED_RX, LED_RX1: LED-0603
LED_TX, LED_TX1: LED-0603
LRF1, LRF2, LRF3, LRF4, LRF5, LRF6: 1.2nH; C0402
PDD_E, PDD_E1: PDD_BOARD; PDD_SOCKET
PDD_N, PDD_N1: PDD_BOARD; PDD_SOCKET
PDD_S, PDD_S1: PDD_BOARD; PDD_SOCKET
PDD_W, PDD_W1: PDD_BOARD; PDD_SOCKET
PHA, PHA1, PHA2, PHA3, PHA4, PHA5, PHA6: VBPW34SR
PHB, PHB1, PHB2, PHB3, PHB4, PHB5, PHB6: VBPW34SR
PREF, PREF1, PREF2, PREF3, PREF4, PREF5, PREF6: 100k; TRIM-PVZ2A
R1, R10: 113k; 0603-RES
R2, R11: 13.3k; 0603-RES
R3, R4, R9, R12: 1; 0603-RES
R5, R6, R8, R13, R14, R16: 10k; 0603-RES
R7, R15: 20k; 0603-RES
RCAN, RCAN1: 100; R0603
RCONT, RCONT1: 10k; 0603-RES
RDIL1, RDIL2, RDIL3, RDIL4, RDIL5, RDIL6: 10k; R0603
RFA, RFA1, RFA2, RFA3, RFA4, RFA5, RFA6: 20k; 0603-RES
RFB, RFB1, RFB2, RFB3, RFB4, RFB5, RFB6: 20k; 0603-RES
RFIA, RFIA1, RFIA2, RFIA3, RFIA4, RFIA5, RFIA6: 100; 0603-RES
RFIB, RFIB1, RFIB2, RFIB3, RFIB4, RFIB5, RFIB6: 100; 0603-RES
RHYSA1, RHYSA3, RHYSA5, RHYSA7, RHYSA9, RHYSA11, RHYSA13: 100; 0603-RES
RHYSA2, RHYSA4, RHYSA6, RHYSA8, RHYSA10, RHYSA12, RHYSA14: 10k; 0603-RES
RHYSB1, RHYSB3, RHYSB5, RHYSB7, RHYSB9, RHYSB11, RHYSB13: 100; 0603-RES
RHYSB2, RHYSB4, RHYSB6, RHYSB8, RHYSB10, RHYSB12, RHYSB14: 10k; 0603-RES
RL1, RL2, RL3, RL4: 270; R0603
RLA, RLA1, RLA2, RLA3, RLA4, RLA5, RLA6: 100k; 0603-RES
RLB, RLB1, RLB2, RLB3, RLB4, RLB5, RLB6: 100k; 0603-RES
RLPOW, RLPOW1: 270; R0603
RLRX, RLRX1: 270; R0603
RLTX, RLTX1: 270; R0603
RMCLR, RMCLR1: 4.7k; R0603
RR1+, RR1+1, RR1+2, RR1+3, RR1+4, RR1+5, RR1+6, RR1-, RR1-1, RR1-2, RR1-3, RR1-4, RR1-5, RR1-6: 31.6k; 0603-RES
RR2+, RR2+1, RR2+2, RR2+3, RR2+4, RR2+5, RR2+6, RR2-, RR2-1, RR2-2, RR2-3, RR2-4, RR2-5, RR2-6: 10k; 0603-RES
RREF1, RREF2, RREF3, RREF4, RREF5, RREF6, RREF7, RREF8, RREF9, RREF10, RREF11, RREF12, RREF13, RREF14: 100; 0603-RES
RS_CAN, RS_CAN1: 10k; R0603
R_RFBIAS, R_RFBIAS1: 56k; 0402-RES
SWON, SWON1: SWITCH-SPDT
U1, U9, U14, U19, U24, U29, U34: TPS7A4901NO_PAD; MSOP8
U2, U8, U13, U18, U23, U28, U33: TPS7A3001NO_PAD; MSOP8
U3, U6, U11, U16, U21, U26, U31: OPA2380; MSOP8
U4, U7, U12, U17, U22, U27, U32: INA2143; SOIC14
U5, U10, U15, U20, U25, U30, U35: TLV3502; SOIC8
U$1, U$4, U$5, U$9: LOGOIGREBOT; LOGO_IGREBOT
U$2, U$3: LOGOEUROBOT; LOGO_EUROBOT_1
UCAN, UCAN1: MCP2551; SO-08
UDCDC, UDCDC1: LT3467A; TSOT-23
UDIL, UDIL1: A6E-3104; SW_DIP-3
UIMU, UIMU1: LSM330DL; LLGA-28
UPIC, UPIC1: DSPIC33FJ128MC804_QFN; QFN44-8X8
UREG, UREG1: MCP1801; SOT23-5L
URF, URF1: CC2500; QFN20-0.5
USUP, USUP1: TL7709AC; SOIC8
UUSB, UUSB1: FT232RL-BASICSSOP; SSOP28DB
X1, X3: 8MHz; XTAL_4.9-1.8
X2, X4: 26MHz; XTAL_4.9-1.8

Connections:
3.3V: C5.+, CBYP_1.1, CBYP_2.1, CBYP_3.1, CBYP_CAN.1, CBYP_FTDI1.1, CBYP_FTDI2.1, CBYP_IMU1.1, CBYP_IMU2.1, CBYP_IMU3.1, CBYP_RFA1.2, CBYP_RFA2.2, CBYP_RFA3.2, CBYP_RFA4.2, CBYP_RFD1.2, CBYP_RFD2.2, JICSP.2, RL1.1, RL2.1, RLPOW.1, RLRX.1, RLTX.1, RMCLR.1, UCAN.3, UDIL.1A, UDIL.2A, UDIL.3A, UIMU.12, UIMU.15, UIMU.22, UIMU.28, UPIC.P$17, UPIC.P$28, UPIC.P$40, UREG.5, URF.4, URF.9, URF.11, URF.14, URF.15, URF.18, UUSB.4, UUSB.20
3.3V1: C16.+, CBYP_4.1, CBYP_5.1, CBYP_6.1, CBYP_CAN1.1, CBYP_FTDI3.1, CBYP_FTDI4.1, CBYP_IMU4.1, CBYP_IMU5.1, CBYP_IMU6.1, CBYP_RFA5.2, CBYP_RFA6.2, CBYP_RFA7.2, CBYP_RFA8.2, CBYP_RFD5.2, CBYP_RFD6.2, JICSP1.2, RL3.1, RL4.1, RLPOW1.1, RLRX1.1, RLTX1.1, RMCLR1.1, UCAN1.3, UDIL1.1A, UDIL1.2A, UDIL1.3A, UIMU1.12, UIMU1.15, UIMU1.22, UIMU1.28, UPIC1.P$17, UPIC1.P$28, UPIC1.P$40, UREG1.5, URF1.4, URF1.9, URF1.11, URF1.14, URF1.15, URF1.18, UUSB1.4, UUSB1.20
!CMP_A-B!: JOUT.1, RHYSB2.2, U5.6
!CMP_A-B!1: JOUT1.1, RHYSB4.2, U10.6
!CMP_A-B!2: JOUT2.1, RHYSB6.2, U15.6
!CMP_A-B!3: JOUT3.1, RHYSB8.2, U20.6
!CMP_A-B!4: JOUT4.1, RHYSB10.2, U25.6
!CMP_A-B!5: JOUT5.1, RHYSB12.2, U30.6
!CMP_A-B!6: JOUT6.1, RHYSB14.2, U35.6
!CMP_B-A!: JOUT.3, RHYSA2.2, U5.7
!CMP_B-A!1: JOUT1.3, RHYSA4.2, U10.7
!CMP_B-A!2: JOUT2.3, RHYSA6.2, U15.7
!CMP_B-A!3: JOUT3.3, RHYSA8.2, U20.7
!CMP_B-A!4: JOUT4.3, RHYSA10.2, U25.7
!CMP_B-A!5: JOUT5.3, RHYSA12.2, U30.7
!CMP_B-A!6: JOUT6.3, RHYSA14.2, U35.7
!CSN!_A: UIMU.17, UPIC.P$23
!CSN!_A1: UIMU1.17, UPIC1.P$23
!CSN!_G: UIMU.10, UPIC.P$24
!CSN!_G1: UIMU1.10, UPIC1.P$24
!CSN!_RF: UPIC.P$33, URF.7
!CSN!_RF1: UPIC1.P$33, URF1.7
!MCLR!: JICSP.1, RMCLR.2, UPIC.P$18
!MCLR!1: JICSP1.1, RMCLR1.2, UPIC1.P$18
!SHDN!: R6.2, UDCDC.4, USUP.5
!SHDN!1: R14.2, UDCDC1.4, USUP1.5
+5V: CBYP_U3.1, CBYP_U4+.1, CBYP_U5-1.1, CBYP_U5-2.1, CRBYP+.1, CROUT+.A, RR1+.2, RREF1.1, U1.1, U3.8, U4.11, U5.8
+5V1: CBYP_U1.1, CBYP_U4+1.1, CBYP_U5-3.1, CBYP_U5-4.1, CRBYP+1.1, CROUT+1.A, RR1+1.2, RREF3.1, U6.8, U7.11, U9.1, U10.8
+5V2: CBYP_U2.1, CBYP_U4+2.1, CBYP_U5-5.1, CBYP_U5-6.1, CRBYP+2.1, CROUT+2.A, RR1+2.2, RREF5.1, U11.8, U12.11, U14.1, U15.8
+5V3: CBYP_U4.1, CBYP_U4+3.1, CBYP_U5-7.1, CBYP_U5-8.1, CRBYP+3.1, CROUT+3.A, RR1+3.2, RREF7.1, U16.8, U17.11, U19.1, U20.8
+5V4: CBYP_U4+4.1, CBYP_U5.1, CBYP_U5-9.1, CBYP_U5-10.1, CRBYP+4.1, CROUT+4.A, RR1+4.2, RREF9.1, U21.8, U22.11, U24.1, U25.8
+5V5: CBYP_U4+5.1, CBYP_U5-11.1, CBYP_U5-12.1, CBYP_U6.1, CRBYP+5.1, CROUT+5.A, RR1+5.2, RREF11.1, U26.8, U27.11, U29.1, U30.8
+5V6: CBYP_U4+6.1, CBYP_U5-13.1, CBYP_U5-14.1, CBYP_U7.1, CRBYP+6.1, CROUT+6.A, RR1+6.2, RREF13.1, U31.8, U32.11, U34.1, U35.8
+12V: C6.1, D1.C, PDD_E.1, PDD_N.1, PDD_S.1, PDD_W.1, R1.2, UREG.1, UREG.3
+12V1: C13.1, D5.C, PDD_E1.1, PDD_N1.1, PDD_S1.1, PDD_W1.1, R10.2, UREG1.1, UREG1.3
-5V: CBYP_U4-.2, CRBYP-.1, CROUT-.C, PHA.A, PHB.A, RR1-.2, U2.1, U4.4
-5V1: CBYP_U4-1.2, CRBYP-1.1, CROUT-1.C, PHA1.A, PHB1.A, RR1-1.2, U7.4, U8.1
-5V2: CBYP_U4-2.2, CRBYP-2.1, CROUT-2.C, PHA2.A, PHB2.A, RR1-2.2, U12.4, U13.1
-5V3: CBYP_U4-3.2, CRBYP-3.1, CROUT-3.C, PHA3.A, PHB3.A, RR1-3.2, U17.4, U18.1
-5V4: CBYP_U4-4.2, CRBYP-4.1, CROUT-4.C, PHA4.A, PHB4.A, RR1-4.2, U22.4, U23.1
-5V5: CBYP_U4-5.2, CRBYP-5.1, CROUT-5.C, PHA5.A, PHB5.A, RR1-5.2, U27.4, U28.1
-5V6: CBYP_U4-6.2, CRBYP-6.1, CROUT-6.C, PHA6.A, PHB6.A, RR1-6.2, U32.4, U33.1
-12V: C7.1, D4.A, PDD_E.4, PDD_N.4, PDD_S.4, PDD_W.4
-12V1: C14.1, D8.A, PDD_E1.4, PDD_N1.4, PDD_S1.4, PDD_W1.4
AGND: CBYP_U3.2, CBYP_U4+.2, CBYP_U4-.1, CBYP_U5-1.2, CBYP_U5-2.2, CFIA.2, CFIB.2, CREF2.2, CRIN+.C, CRIN-.A, CRNR+.2, CRNR-.2, CROUT+.C, CROUT-.A, JIN.2, JIN.3, JOUT.2, RLA.1, RLB.1, RR2+.1, RR2-.1, RREF2.1, U1.4, U2.4, U3.3, U3.4, U3.5, U4.8, U4.14, U5.5
AGND1: CBYP_U1.2, CBYP_U4+1.2, CBYP_U4-1.1, CBYP_U5-3.2, CBYP_U5-4.2, CFIA1.2, CFIB1.2, CREF3.2, CRIN+1.C, CRIN-1.A, CRNR+1.2, CRNR-1.2, CROUT+1.C, CROUT-1.A, JIN1.2, JIN1.3, JOUT1.2, RLA1.1, RLB1.1, RR2+1.1, RR2-1.1, RREF4.1, U6.3, U6.4, U6.5, U7.8, U7.14, U8.4, U9.4, U10.5
AGND2: CBYP_U2.2, CBYP_U4+2.2, CBYP_U4-2.1, CBYP_U5-5.2, CBYP_U5-6.2, CFIA2.2, CFIB2.2, CREF4.2, CRIN+2.C, CRIN-2.A, CRNR+2.2, CRNR-2.2, CROUT+2.C, CROUT-2.A, JIN2.2, JIN2.3, JOUT2.2, RLA2.1, RLB2.1, RR2+2.1, RR2-2.1, RREF6.1, U11.3, U11.4, U11.5, U12.8, U12.14, U13.4, U14.4, U15.5
AGND3: CBYP_U4.2, CBYP_U4+3.2, CBYP_U4-3.1, CBYP_U5-7.2, CBYP_U5-8.2, CFIA3.2, CFIB3.2, CREF5.2, CRIN+3.C, CRIN-3.A, CRNR+3.2, CRNR-3.2, CROUT+3.C, CROUT-3.A, JIN3.2, JIN3.3, JOUT3.2, RLA3.1, RLB3.1, RR2+3.1, RR2-3.1, RREF8.1, U16.3, U16.4, U16.5, U17.8, U17.14, U18.4, U19.4, U20.5
AGND4: CBYP_U4+4.2, CBYP_U4-4.1, CBYP_U5.2, CBYP_U5-9.2, CBYP_U5-10.2, CFIA4.2, CFIB4.2, CREF6.2, CRIN+4.C, CRIN-4.A, CRNR+4.2, CRNR-4.2, CROUT+4.C, CROUT-4.A, JIN4.2, JIN4.3, JOUT4.2, RLA4.1, RLB4.1, RR2+4.1, RR2-4.1, RREF10.1, U21.3, U21.4, U21.5, U22.8, U22.14, U23.4, U24.4, U25.5
AGND5: CBYP_U4+5.2, CBYP_U4-5.1, CBYP_U5-11.2, CBYP_U5-12.2, CBYP_U6.2, CFIA5.2, CFIB5.2, CREF7.2, CRIN+5.C, CRIN-5.A, CRNR+5.2, CRNR-5.2, CROUT+5.C, CROUT-5.A, JIN5.2, JIN5.3, JOUT5.2, RLA5.1, RLB5.1, RR2+5.1, RR2-5.1, RREF12.1, U26.3, U26.4, U26.5, U27.8, U27.14, U28.4, U29.4, U30.5
AGND6: CBYP_U4+6.2, CBYP_U4-6.1, CBYP_U5-13.2, CBYP_U5-14.2, CBYP_U7.2, CFIA6.2, CFIB6.2, CREF8.2, CRIN+6.C, CRIN-6.A, CRNR+6.2, CRNR-6.2, CROUT+6.C, CROUT-6.A, JIN6.2, JIN6.3, JOUT6.2, RLA6.1, RLB6.1, RR2+6.1, RR2-6.1, RREF14.1, U31.3, U31.4, U31.5, U32.8, U32.14, U33.4, U34.4, U35.5
CANH: JCAN.2, RCAN.1, UCAN.7
CANH1: JCAN1.2, RCAN1.1, UCAN1.7
CANL: JCAN.3, JPCAN.2, UCAN.6
CANL1: JCAN1.3, JPCAN1.2, UCAN1.6
CAN_RX: UCAN.4, UPIC.P$10
CAN_RX1: UCAN1.4, UPIC1.P$10
CAN_TX: UCAN.1, UPIC.P$11
CAN_TX1: UCAN1.1, UPIC1.P$11
DIL1: RDIL1.1, UDIL.1B, UPIC.P$20
DIL2: RDIL2.1, UDIL.2B, UPIC.P$15
DIL3: RDIL3.1, UDIL.3B, UPIC.P$14
DIL4: RDIL4.1, UDIL1.3B, UPIC1.P$14
DIL5: RDIL5.1, UDIL1.2B, UPIC1.P$15
DIL6: RDIL6.1, UDIL1.1B, UPIC1.P$20
E_!A-B!: PDD_E.5, UPIC.P$37
E_!A-B!1: PDD_E1.5, UPIC1.P$37
E_!B-A!: PDD_E.7, UPIC.P$36
E_!B-A!1: PDD_E1.7, UPIC1.P$36
GND: C1.-, C2.2, C5.-, C6.2, C7.2, C8.2, CBYP_1.2, CBYP_2.2, CBYP_3.2, CBYP_CAN.2, CBYP_FTDI1.2, CBYP_FTDI2.2, CBYP_IMU1.2, CBYP_IMU2.2, CBYP_IMU3.2, CBYP_RFA1.1, CBYP_RFA2.1, CBYP_RFA3.1, CBYP_RFA4.1, CBYP_RFD1.1, CBYP_RFD2.1, CBYP_RFD3.1, CCAP.2, CCONT1.2, CREF.1, CRF3.1, CRF5.1, CRF6.1, CX1_1.2, CX1_2.2, CX2_1.2, CX2_2.2, D2.A, D3.C, JANT.B1, JANT.B2, JANT.B3, JANT.B4, JBAT.1, JCAN.1, JCAN.4, JICSP.3, JUSB.GND, LED_POW.C, LRF1.1, PDD_E.2, PDD_E.3, PDD_E.6, PDD_N.2, PDD_N.3, PDD_N.6, PDD_S.2, PDD_S.3, PDD_S.6, PDD_W.2, PDD_W.3, PDD_W.6, R2.1, R5.1, R8.1, RCONT.1, RDIL1.2, RDIL2.2, RDIL3.2, RS_CAN.1, R_RFBIAS.2, UCAN.2, UDCDC.2, UIMU.2, UIMU.11, UIMU.14, UIMU.16, UIMU.18, UIMU.19, UIMU.20, UIMU.23, UIMU.24, UIMU.25, UIMU.27, UPIC.P$6, UPIC.P$16, UPIC.P$29, UPIC.P$39, UPIC.PAD, UREG.2, URF.16, URF.19, URF.PAD, USUP.4, UUSB.7, UUSB.18, UUSB.21, UUSB.25, UUSB.26
GND1: C9.-, C10.2, C13.2, C14.2, C15.2, C16.-, CBYP_4.2, CBYP_5.2, CBYP_6.2, CBYP_CAN1.2, CBYP_FTDI3.2, CBYP_FTDI4.2, CBYP_IMU4.2, CBYP_IMU5.2, CBYP_IMU6.2, CBYP_RFA5.1, CBYP_RFA6.1, CBYP_RFA7.1, CBYP_RFA8.1, CBYP_RFD4.1, CBYP_RFD5.1, CBYP_RFD6.1, CCAP1.2, CCONT3.2, CREF1.1, CRF9.1, CRF11.1, CRF12.1, CX1_3.2, CX1_4.2, CX2_3.2, CX2_4.2, D6.A, D7.C, JANT1.B1, JANT1.B2, JANT1.B3, JANT1.B4, JBAT1.1, JCAN1.1, JCAN1.4, JICSP1.3, JUSB1.GND, LED_POW1.C, LRF4.1, PDD_E1.2, PDD_E1.3, PDD_E1.6, PDD_N1.2, PDD_N1.3, PDD_N1.6, PDD_S1.2, PDD_S1.3, PDD_S1.6, PDD_W1.2, PDD_W1.3, PDD_W1.6, R11.1, R13.1, R16.1, RCONT1.1, RDIL4.2, RDIL5.2, RDIL6.2, RS_CAN1.1, R_RFBIAS1.2, UCAN1.2, UDCDC1.2, UIMU1.2, UIMU1.11, UIMU1.14, UIMU1.16, UIMU1.18, UIMU1.19, UIMU1.20, UIMU1.23, UIMU1.24, UIMU1.25, UIMU1.27, UPIC1.P$6, UPIC1.P$16, UPIC1.P$29, UPIC1.P$39, UPIC1.PAD, UREG1.2, URF1.16, URF1.19, URF1.PAD, USUP1.4, UUSB1.7, UUSB1.18, UUSB1.21, UUSB1.25, UUSB1.26
LED_1: LED_1.C, UPIC.P$13
LED_2: LED_2.C, UPIC.P$12
LED_3: LED_3.C, UPIC1.P$13
LED_4: LED_4.C, UPIC1.P$12
LED_RX: LED_RX.C, UUSB.22
LED_RX1: LED_RX1.C, UUSB1.22
LED_TX: LED_TX.C, UUSB.23
LED_TX1: LED_TX1.C, UUSB1.23
MISO: UIMU.3, UIMU.7, UPIC.P$27, URF.2
MISO1: UIMU1.3, UIMU1.7, UPIC1.P$27, URF1.2
MOSI: UIMU.1, UIMU.9, UPIC.P$25, URF.20
MOSI1: UIMU1.1, UIMU1.9, UPIC1.P$25, URF1.20
unnamed: CRF1.2, CRF4.2, LRF1.2
unnamed: LED_TX.A, RLTX.2
unnamed: CRF2.2, CRF3.2, LRF2.1
unnamed: CRF4.1, CRF5.2, LRF2.2, LRF3.1
unnamed: RS_CAN.2, UCAN.8
unnamed: JPCAN.1, RCAN.2
unnamed: CRF6.2, JANT.A, LRF3.2
unnamed: LED_RX.A, RLRX.2
unnamed: LED_1.A, RL1.2
unnamed: LED_2.A, RL2.2
unnamed: C2.1, UDCDC.5
unnamed: JBAT.2, SWON.2
unnamed: C3.1, C4.1, L1.2, UDCDC.1
unnamed: C3.2, D3.A, R4.2
unnamed: D2.C, R3.1
unnamed: C4.2, D1.A, R3.2
unnamed: R5.2, USUP.6
unnamed: R1.1, R2.2, UDCDC.3
unnamed: D4.C, R4.1
unnamed: CCONT2.2, RCONT.2
unnamed: LED_POW.A, RLPOW.2
unnamed: RS_CAN1.2, UCAN1.8
unnamed: CRF7.2, CRF10.2, LRF4.2
unnamed: CRF8.2, CRF9.2, LRF5.1
unnamed: CRF10.1, CRF11.2, LRF5.2, LRF6.1
unnamed: CRF12.2, JANT1.A, LRF6.2
unnamed: JPCAN1.1, RCAN1.2
unnamed: LED_TX1.A, RLTX1.2
unnamed: LED_RX1.A, RLRX1.2
unnamed: LED_3.A, RL3.2
unnamed: LED_4.A, RL4.2
unnamed: C11.1, C12.1, L2.2, UDCDC1.1
unnamed: C10.1, UDCDC1.5
unnamed: D6.C, R9.1
unnamed: C12.2, D5.A, R9.2
unnamed: D8.C, R12.1
unnamed: C11.2, D7.A, R12.2
unnamed: R10.1, R11.2, UDCDC1.3
unnamed: R13.2, USUP1.6
unnamed: JBAT1.2, SWON1.2
unnamed: CCONT4.2, RCONT1.2
unnamed: LED_POW1.A, RLPOW1.2
unnamed: CRNR+.1, U1.6
unnamed: CRNR-.1, U2.6
unnamed: CRBYP+.2, RR1+.1, RR2+.2, U1.2
unnamed: CRBYP-.2, RR1-.1, RR2-.2, U2.2
unnamed: CFA.2, RFIA.1, U3.1
unnamed: CFA.1, PHA.K, RFA.1, U3.2
unnamed: CFB.2, RFIB.1, U3.7
unnamed: CFB.1, PHB.K, RFB.1, U3.6
unnamed: RHYSA1.2, RHYSA2.1, U5.1
unnamed: RHYSB1.2, RHYSB2.1, U5.3
unnamed: PREF.1, RREF1.2
unnamed: PREF.3, RREF2.2
unnamed: CRNR+1.1, U9.6
unnamed: CRNR-1.1, U8.6
unnamed: CRBYP+1.2, RR1+1.1, RR2+1.2, U9.2
unnamed: CRBYP-1.2, RR1-1.1, RR2-1.2, U8.2
unnamed: CFA1.2, RFIA1.1, U6.1
unnamed: CFA1.1, PHA1.K, RFA1.1, U6.2
unnamed: CFB1.2, RFIB1.1, U6.7
unnamed: CFB1.1, PHB1.K, RFB1.1, U6.6
unnamed: RHYSA3.2, RHYSA4.1, U10.1
unnamed: RHYSB3.2, RHYSB4.1, U10.3
unnamed: PREF1.1, RREF3.2
unnamed: PREF1.3, RREF4.2
unnamed: CRNR+2.1, U14.6
unnamed: CRNR-2.1, U13.6
unnamed: CRBYP+2.2, RR1+2.1, RR2+2.2, U14.2
unnamed: CRBYP-2.2, RR1-2.1, RR2-2.2, U13.2
unnamed: CFA2.2, RFIA2.1, U11.1
unnamed: CFA2.1, PHA2.K, RFA2.1, U11.2
unnamed: CFB2.2, RFIB2.1, U11.7
unnamed: CFB2.1, PHB2.K, RFB2.1, U11.6
unnamed: RHYSA5.2, RHYSA6.1, U15.1
unnamed: RHYSB5.2, RHYSB6.1, U15.3
unnamed: PREF2.1, RREF5.2
unnamed: PREF2.3, RREF6.2
unnamed: CRNR+3.1, U19.6
unnamed: CRNR-3.1, U18.6
unnamed: CRBYP+3.2, RR1+3.1, RR2+3.2, U19.2
unnamed: CRBYP-3.2, RR1-3.1, RR2-3.2, U18.2
unnamed: CFA3.2, RFIA3.1, U16.1
unnamed: CFA3.1, PHA3.K, RFA3.1, U16.2
unnamed: CFB3.2, RFIB3.1, U16.7
unnamed: CFB3.1, PHB3.K, RFB3.1, U16.6
unnamed: RHYSA7.2, RHYSA8.1, U20.1
unnamed: RHYSB7.2, RHYSB8.1, U20.3
unnamed: PREF3.1, RREF7.2
unnamed: PREF3.3, RREF8.2
unnamed: CRNR+4.1, U24.6
unnamed: CRNR-4.1, U23.6
unnamed: CRBYP+4.2, RR1+4.1, RR2+4.2, U24.2
unnamed: CRBYP-4.2, RR1-4.1, RR2-4.2, U23.2
unnamed: CFA4.2, RFIA4.1, U21.1
unnamed: CFA4.1, PHA4.K, RFA4.1, U21.2
unnamed: CFB4.2, RFIB4.1, U21.7
unnamed: CFB4.1, PHB4.K, RFB4.1, U21.6
unnamed: RHYSA9.2, RHYSA10.1, U25.1
unnamed: RHYSB9.2, RHYSB10.1, U25.3
unnamed: PREF4.1, RREF9.2
unnamed: PREF4.3, RREF10.2
unnamed: CRNR+5.1, U29.6
unnamed: CRNR-5.1, U28.6
unnamed: CRBYP+5.2, RR1+5.1, RR2+5.2, U29.2
unnamed: CRBYP-5.2, RR1-5.1, RR2-5.2, U28.2
unnamed: CFA5.2, RFIA5.1, U26.1
unnamed: CFA5.1, PHA5.K, RFA5.1, U26.2
unnamed: CFB5.2, RFIB5.1, U26.7
unnamed: CFB5.1, PHB5.K, RFB5.1, U26.6
unnamed: RHYSA11.2, RHYSA12.1, U30.1
unnamed: RHYSB11.2, RHYSB12.1, U30.3
unnamed: PREF5.1, RREF11.2
unnamed: PREF5.3, RREF12.2
unnamed: CRNR+6.1, U34.6
unnamed: CRNR-6.1, U33.6
unnamed: CRBYP+6.2, RR1+6.1, RR2+6.2, U34.2
unnamed: CRBYP-6.2, RR1-6.1, RR2-6.2, U33.2
unnamed: CFA6.2, RFIA6.1, U31.1
unnamed: CFA6.1, PHA6.K, RFA6.1, U31.2
unnamed: CFB6.2, RFIB6.1, U31.7
unnamed: CFB6.1, PHB6.K, RFB6.1, U31.6
unnamed: RHYSA13.2, RHYSA14.1, U35.1
unnamed: RHYSB13.2, RHYSB14.1, U35.3
unnamed: PREF6.1, RREF13.2
unnamed: PREF6.3, RREF14.2
N_!A-B!: PDD_N.5, UPIC.P$41
N_!A-B!1: PDD_N1.5, UPIC1.P$41
N_!B-A!: PDD_N.7, UPIC.P$38
N_!B-A!1: PDD_N1.7, UPIC1.P$38
PGC: JICSP.5, UPIC.P$22
PGC1: JICSP1.5, UPIC1.P$22
PGD: JICSP.4, UPIC.P$21
PGD1: JICSP1.4, UPIC1.P$21
RF_N: CRF1.1, URF.13
RF_N1: CRF7.1, URF1.13
RF_P: CRF2.1, URF.12
RF_P1: CRF8.1, URF1.12
R_RFBIAS: R_RFBIAS.1, URF.17
R_RFBIAS1: R_RFBIAS1.1, URF1.17
SCLK: UIMU.4, UIMU.13, UPIC.P$26, URF.1
SCLK1: UIMU1.4, UIMU1.13, UPIC1.P$26, URF1.1
SENSE_BAT: R7.2, R8.2, UPIC.P$19
SENSE_BAT1: R15.2, R16.2, UPIC1.P$19
SUB_A-B: U4.9, U4.10, U5.4
SUB_A-B1: U7.9, U7.10, U10.4
SUB_A-B2: U12.9, U12.10, U15.4
SUB_A-B3: U17.9, U17.10, U20.4
SUB_A-B4: U22.9, U22.10, U25.4
SUB_A-B5: U27.9, U27.10, U30.4
SUB_A-B6: U32.9, U32.10, U35.4
SUB_B-A: U4.12, U4.13, U5.2
SUB_B-A1: U7.12, U7.13, U10.2
SUB_B-A2: U12.12, U12.13, U15.2
SUB_B-A3: U17.12, U17.13, U20.2
SUB_B-A4: U22.12, U22.13, U25.2
SUB_B-A5: U27.12, U27.13, U30.2
SUB_B-A6: U32.12, U32.13, U35.2
S_!A-B!: PDD_S.5, UPIC.P$9
S_!A-B!1: PDD_S1.5, UPIC1.P$9
S_!B-A!: PDD_S.7, UPIC.P$8
S_!B-A!1: PDD_S1.7, UPIC1.P$8
TI_A: CFIA.1, RFA.2, RFIA.2, RLA.2, U4.2, U4.5
TI_A1: CFIA1.1, RFA1.2, RFIA1.2, RLA1.2, U7.2, U7.5
TI_A2: CFIA2.1, RFA2.2, RFIA2.2, RLA2.2, U12.2, U12.5
TI_A3: CFIA3.1, RFA3.2, RFIA3.2, RLA3.2, U17.2, U17.5
TI_A4: CFIA4.1, RFA4.2, RFIA4.2, RLA4.2, U22.2, U22.5
TI_A5: CFIA5.1, RFA5.2, RFIA5.2, RLA5.2, U27.2, U27.5
TI_A6: CFIA6.1, RFA6.2, RFIA6.2, RLA6.2, U32.2, U32.5
TI_B: CFIB.1, RFB.2, RFIB.2, RLB.2, U4.3, U4.6
TI_B1: CFIB1.1, RFB1.2, RFIB1.2, RLB1.2, U7.3, U7.6
TI_B2: CFIB2.1, RFB2.2, RFIB2.2, RLB2.2, U12.3, U12.6
TI_B3: CFIB3.1, RFB3.2, RFIB3.2, RLB3.2, U17.3, U17.6
TI_B4: CFIB4.1, RFB4.2, RFIB4.2, RLB4.2, U22.3, U22.6
TI_B5: CFIB5.1, RFB5.2, RFIB5.2, RLB5.2, U27.3, U27.6
TI_B6: CFIB6.1, RFB6.2, RFIB6.2, RLB6.2, U32.3, U32.6
USBDM: JUSB.D-, UUSB.16
USBDM1: JUSB1.D-, UUSB1.16
USBDP: JUSB.D+, UUSB.15
USBDP1: JUSB1.D+, UUSB1.15
USB_RX: UPIC.P$5, UUSB.5
USB_RX1: UPIC1.P$5, UUSB1.5
USB_TX: UPIC.P$4, UUSB.1
USB_TX1: UPIC1.P$4, UUSB1.1
VBAT: C1.+, L1.1, R6.1, R7.1, SWON.1, UDCDC.6, USUP.2, USUP.7, USUP.8
VBAT1: C9.+, L2.1, R14.1, R15.1, SWON1.1, UDCDC1.6, USUP1.2, USUP1.7, USUP1.8
VCAP: CCAP.1, UPIC.P$7
VCAP1: CCAP1.1, UPIC1.P$7
VCONT: CCONT1.1, CCONT2.1, UIMU.26
VCONT1: CCONT3.1, CCONT4.1, UIMU1.26
VCT: C8.1, USUP.3
VCT1: C15.1, USUP1.3
VDCOUPL: CBYP_RFD3.2, URF.5
VDCOUPL1: CBYP_RFD4.2, URF1.5
VIN+: CRIN+.A, JIN.1, U1.5, U1.8
VIN+1: CRIN+1.A, JIN1.1, U9.5, U9.8
VIN+2: CRIN+2.A, JIN2.1, U14.5, U14.8
VIN+3: CRIN+3.A, JIN3.1, U19.5, U19.8
VIN+4: CRIN+4.A, JIN4.1, U24.5, U24.8
VIN+5: CRIN+5.A, JIN5.1, U29.5, U29.8
VIN+6: CRIN+6.A, JIN6.1, U34.5, U34.8
VIN-: CRIN-.C, JIN.4, U2.5, U2.8
VIN-1: CRIN-1.C, JIN1.4, U8.5, U8.8
VIN-2: CRIN-2.C, JIN2.4, U13.5, U13.8
VIN-3: CRIN-3.C, JIN3.4, U18.5, U18.8
VIN-4: CRIN-4.C, JIN4.4, U23.5, U23.8
VIN-5: CRIN-5.C, JIN5.4, U28.5, U28.8
VIN-6: CRIN-6.C, JIN6.4, U33.5, U33.8
VREF: CREF.2, USUP.1
VREF1: CREF1.2, USUP1.1
VREF2: CREF2.1, PREF.2, RHYSA1.1, RHYSB1.1
VREF3: CREF3.1, PREF1.2, RHYSA3.1, RHYSB3.1
VREF4: CREF4.1, PREF2.2, RHYSA5.1, RHYSB5.1
VREF5: CREF5.1, PREF3.2, RHYSA7.1, RHYSB7.1
VREF6: CREF6.1, PREF4.2, RHYSA9.1, RHYSB9.1
VREF7: CREF7.1, PREF5.2, RHYSA11.1, RHYSB11.1
VREF8: CREF8.1, PREF6.2, RHYSA13.1, RHYSB13.1
W_!A-B!: PDD_W.5, UPIC.P$3
W_!A-B!1: PDD_W1.5, UPIC1.P$3
W_!B-A!: PDD_W.7, UPIC.P$2
W_!B-A!1: PDD_W1.7, UPIC1.P$2
X1_OSC1: CX1_1.1, UPIC.P$30, X1.P$1
X1_OSC2: CX1_2.1, UPIC.P$31, X1.P$2
X1_OSC3: CX1_3.1, UPIC1.P$30, X3.P$1
X1_OSC4: CX1_4.1, UPIC1.P$31, X3.P$2
X2_OSC1: CX2_1.1, URF.8, X2.P$1
X2_OSC2: CX2_2.1, URF.10, X2.P$2
X2_OSC3: CX2_3.1, URF1.8, X4.P$1
X2_OSC4: CX2_4.1, URF1.10, X4.P$2
