I-Grebot/Laser_Beacon_V3.0/(commit log)

2016-11-03 Porting from assembla to Git
    First porting gathering everything related to laser Beacon V3
    [BRX.brd, BRX.sch, BRX_pan.brd, BTX.brd, BTX.sch, BTX_pan.brd, Laser_Beacon_V3.0_BOM.xlsx, PDD.brd]
2017-04-02 WIP before computer change
    [PhotoDetectMain_Algorithm.xlsx]
2017-05-06 work in progress SPI
2017-05-14 SPI working, main needed registers can be read
2017-05-17 add the arduino SPI master used for validation
